Liftyee/multum-in-parvo/README.md

# multum-in-parvo
Low power, high performance mesh radio device
