Liftyee/multum-in-parvo/docs/project-proposal.md

# Project Proposal

## Target

I will design and test a high-performance, versatile mesh radio device. It will improve on two engineering fields compared to existing devices:

1. Radio-frequency (RF) and antenna design.
2. Low-power design.

These improvements will be field tested by community members to evaluate their real-world impact.

## Rationale

Everyday wireless devices like phones rely on base stations to communicate. These are single points of failure that can fail due to man-made or natural incidents (for example, a power cut), or be completely absent in remote locations.

In contrast, mesh networks such as Meshtastic are not reliant on any single device, because the mesh radio devices ("nodes") can communicate directly with each other. Distributing these devices to a community makes it more resilient, as it ensures coordination and communication can be maintained independently of major networks.

I already own many Meshtastic radio devices. They are inexpensive and functional, but there are two key problems:

1. The actual RF performance is often lacking, with poorly tuned antennas and suboptimal circuit design. This diminishes the range, efficiency, and therefore usefulness of the device.
2. Most nodes are power-hungry, with processors and high-power consumers such as GPS limiting battery life. Additionally, support for sustainable power sources (for example, solar and wind) is limited, hindering their off-grid potential.

I aim to improve on these two areas while maintaining an affordable price point compared with expensive professional nodes. The finished nodes will be sent to selected Meshtastic community members for testing.

## Timescale

1. **Design and ordering of first revision (electronics and casing):** 2 weeks.
2. **Standalone antenna and casing development:** 2 weeks, while waiting for designed parts to arrive.
3. **Testing, characterisation, and tuning of first revision:** 2 weeks.
4. **Improve design and order second revision:** 1 week.
5. **Repeat steps 2–3, distribute to the community, gather feedback, and write up:** 4 more weeks.

## Personal and Professional Development

In the short term, the skills I will gain in the RF and electronics engineering fields are in demand for internships and embedded engineering roles, which I aim to apply for.

In the medium to long term, RF is a field in which I am likely to specialise, from my current perspective. The real-world experience from this project will give me useful intuition about these concepts at an early stage, so I am well prepared to go further in my future career.

I think all the areas I plan to explore in this project are of high importance in our information-based society. These areas are also current weaknesses in my electronics skill set, so the experience from this project will help make me a more well-rounded engineer who can contribute to more projects in the future.

Finally, executing this project will improve my planning and decision-making skills, increasing my ability to bring projects to completion.
