Liftyee/multum-in-parvo/docs/references.md

# References

## Energy harvesting

- Chevrier, M., “The Secrets of Energy Harvesting: the Sloth and the Bear,” Texas Instruments, SSZTC44, September 2015. [Local PDF](./SSZTC44-sloth-and-bear.pdf) · [TI document page](https://www.ti.com/document-viewer/lit/html/ssztc44) · [TI PDF](https://www.ti.com/lit/ta/ssztc44/ssztc44.pdf)
