Liftyee/multum-in-parvo/hardware/reports/power-four-page.png

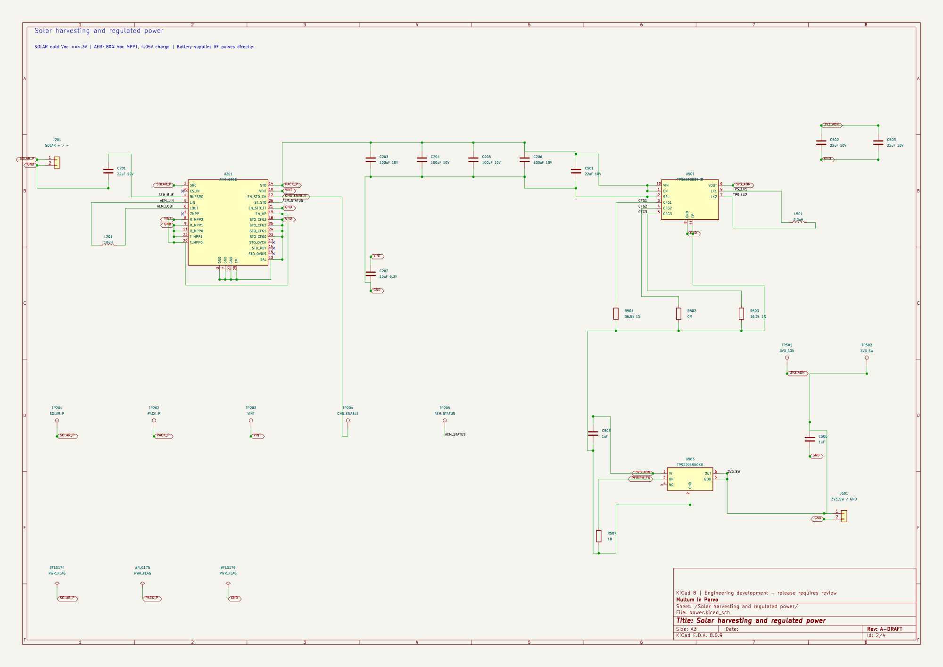
hardware/reports/power-four-page.png
