Liftyee/multum-in-parvo/hardware/reports/radio-four-page.png

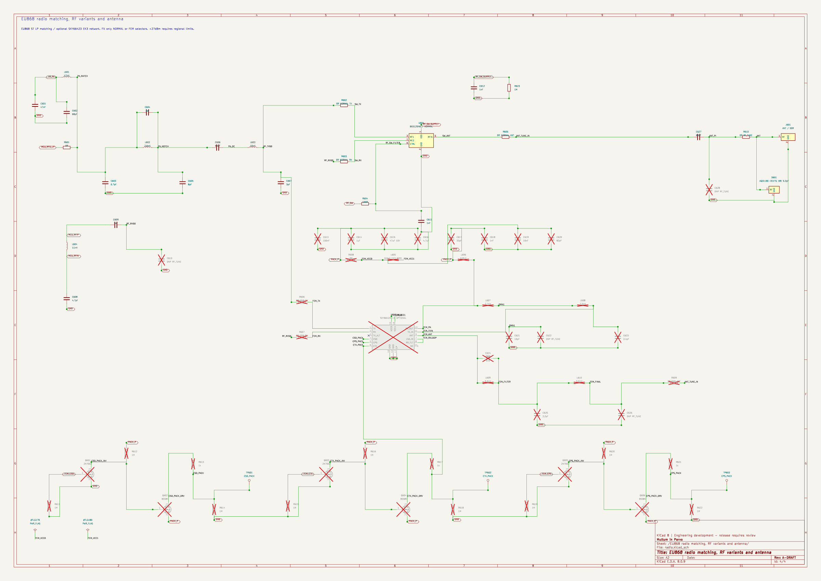
hardware/reports/radio-four-page.png
