Liftyee/multum-in-parvo/hardware/reports/rf-detail.png

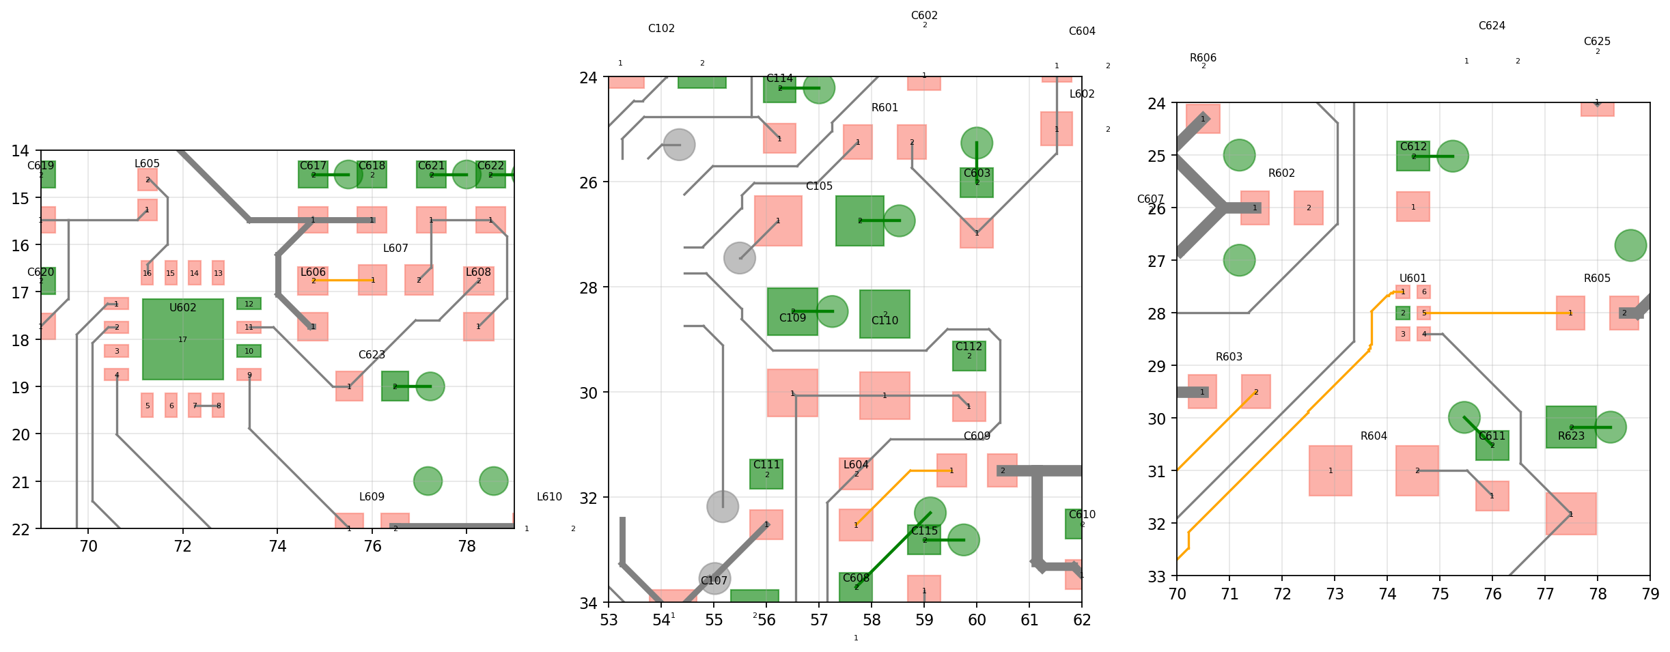
hardware/reports/rf-detail.png
