Liftyee/multum-in-parvo/hardware/reports/rf-placement.png

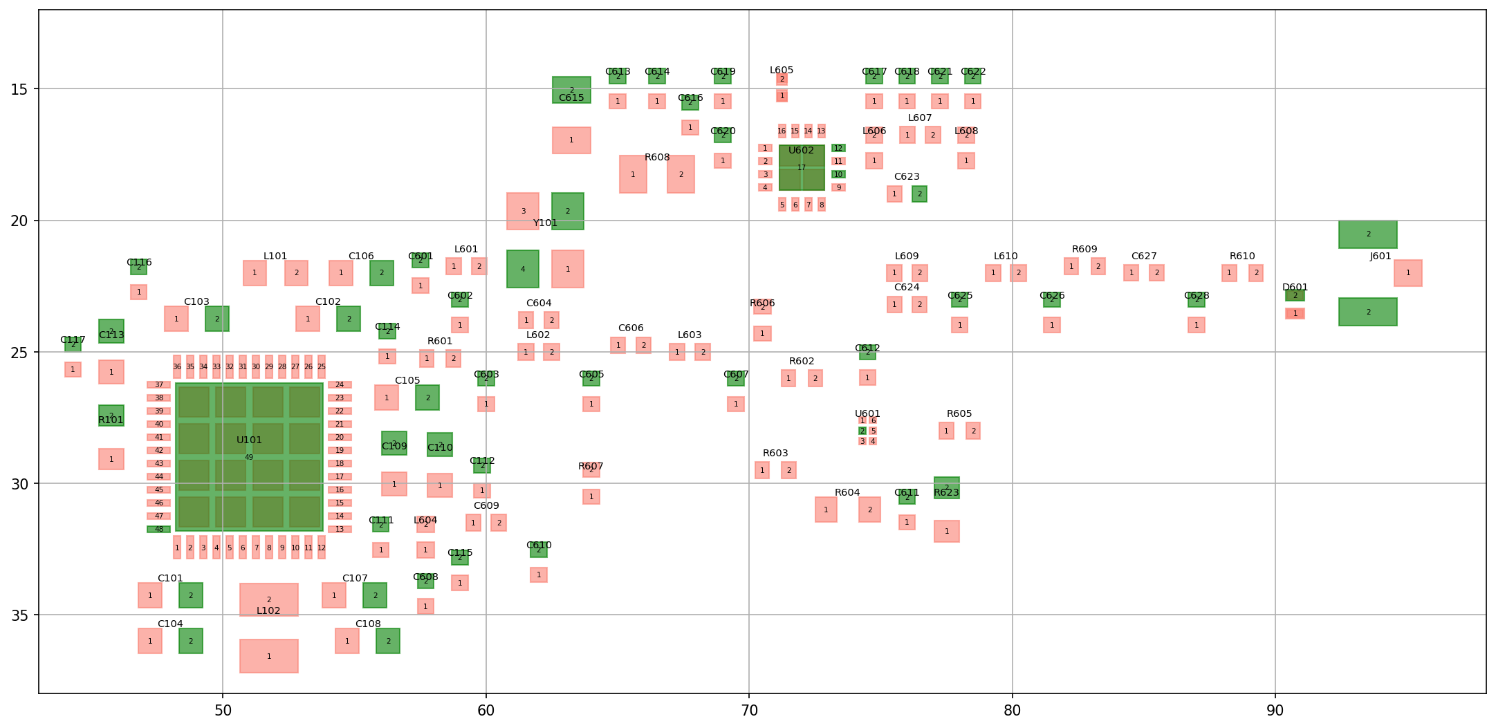
hardware/reports/rf-placement.png
