Liftyee/multum-in-parvo/hardware/reports/rf-routing-final.png

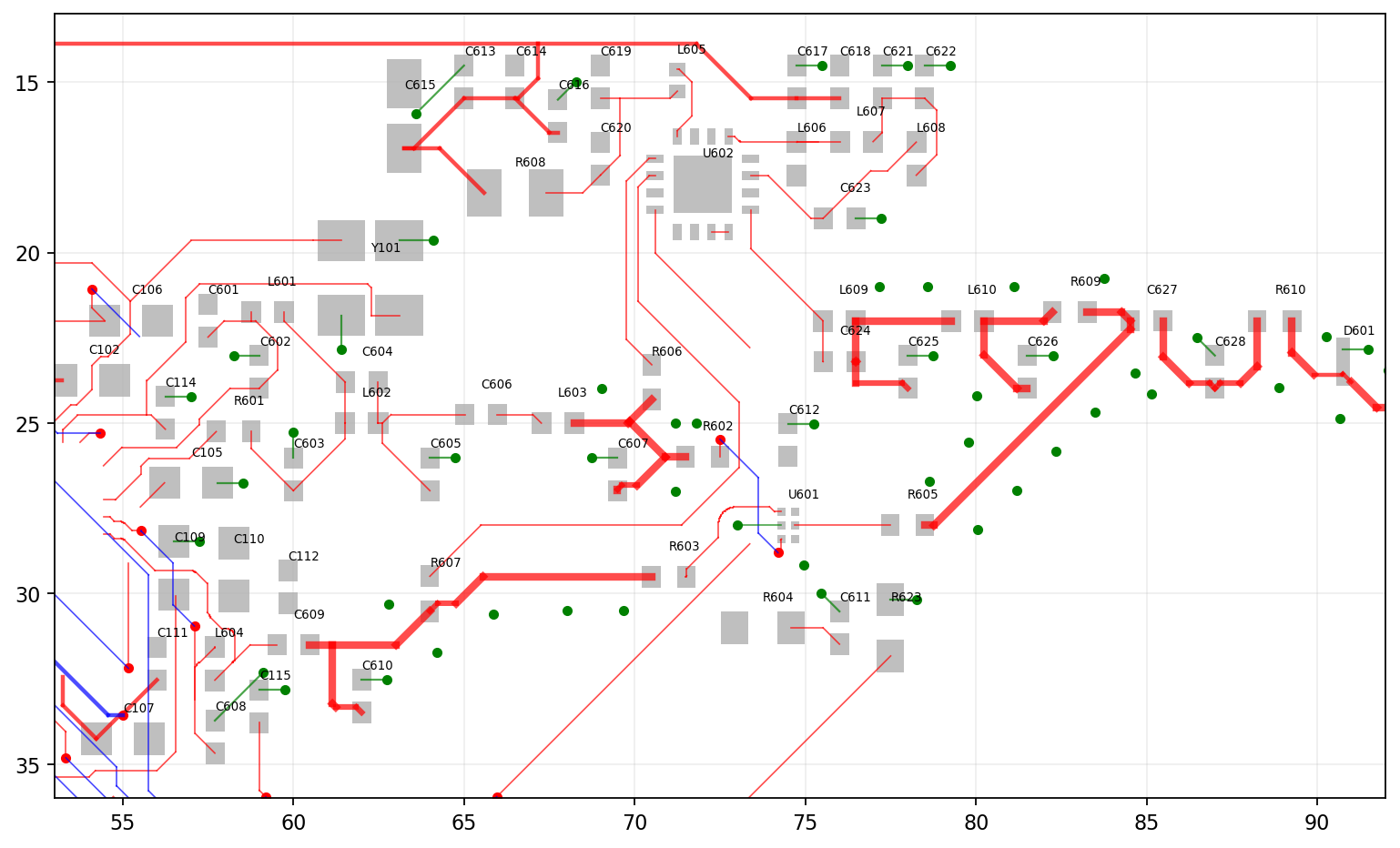
hardware/reports/rf-routing-final.png
