Liftyee/multum-in-parvo/hardware/reports/schematic-rf.png

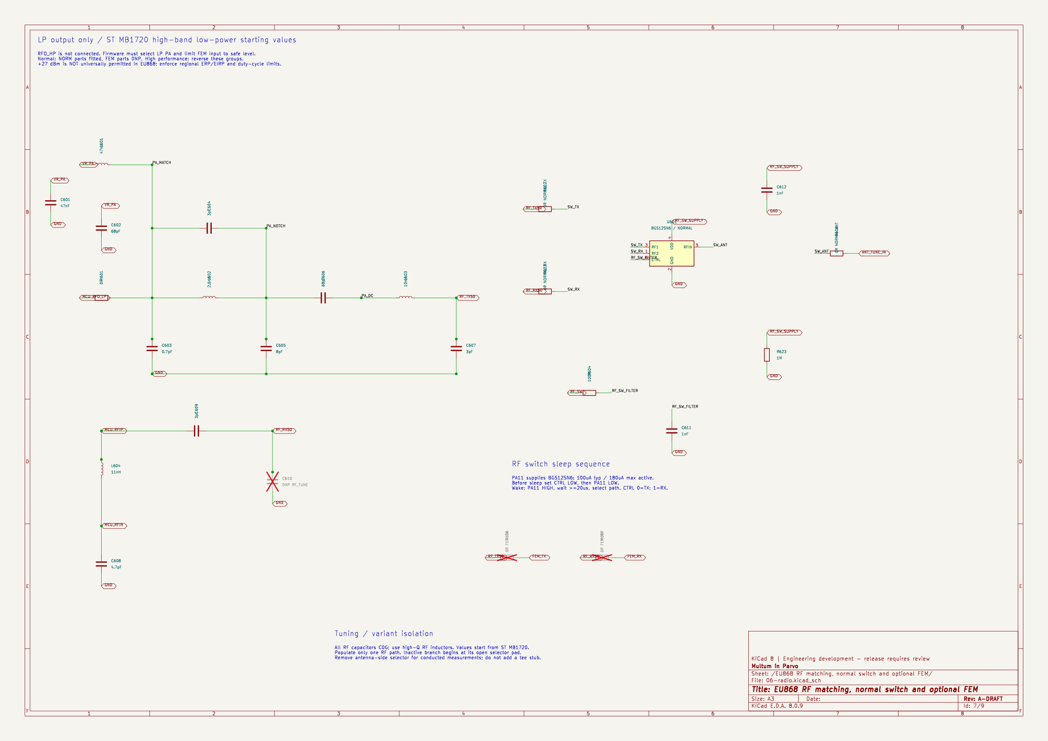
hardware/reports/schematic-rf.png
