Liftyee/multum-in-parvo/hardware/reports/schematic-solar.png

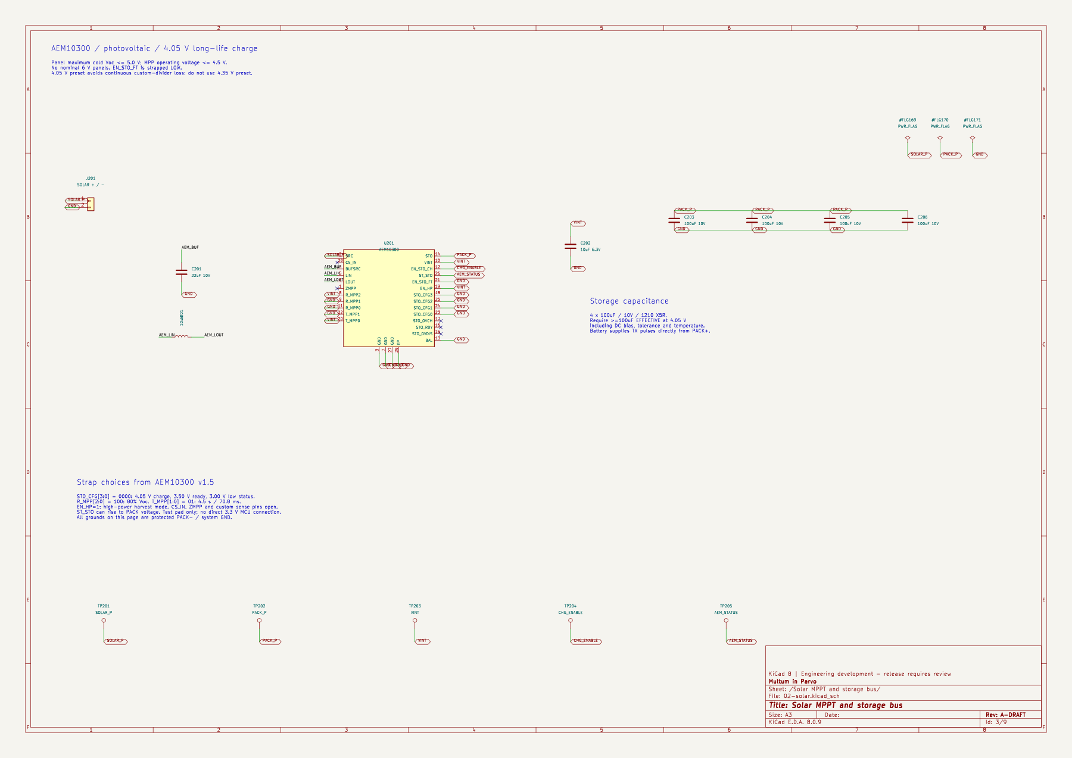
hardware/reports/schematic-solar.png
