Liftyee/multum-in-parvo/hardware/sources/aem-land.png

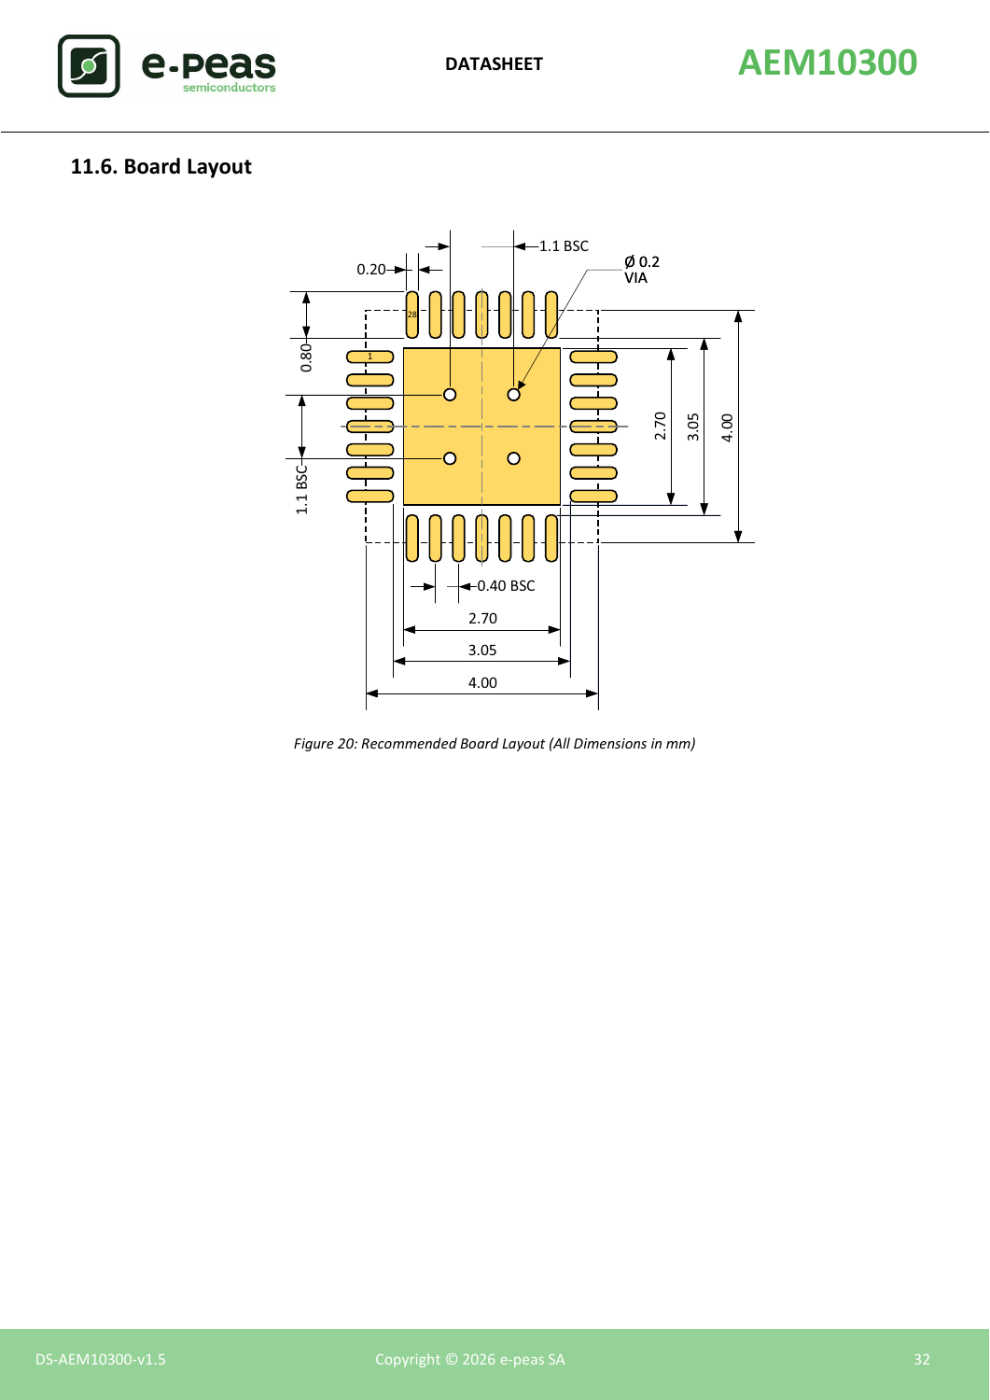
hardware/sources/aem-land.png
