Liftyee/multum-in-parvo/hardware/sources/fet-drawing.png

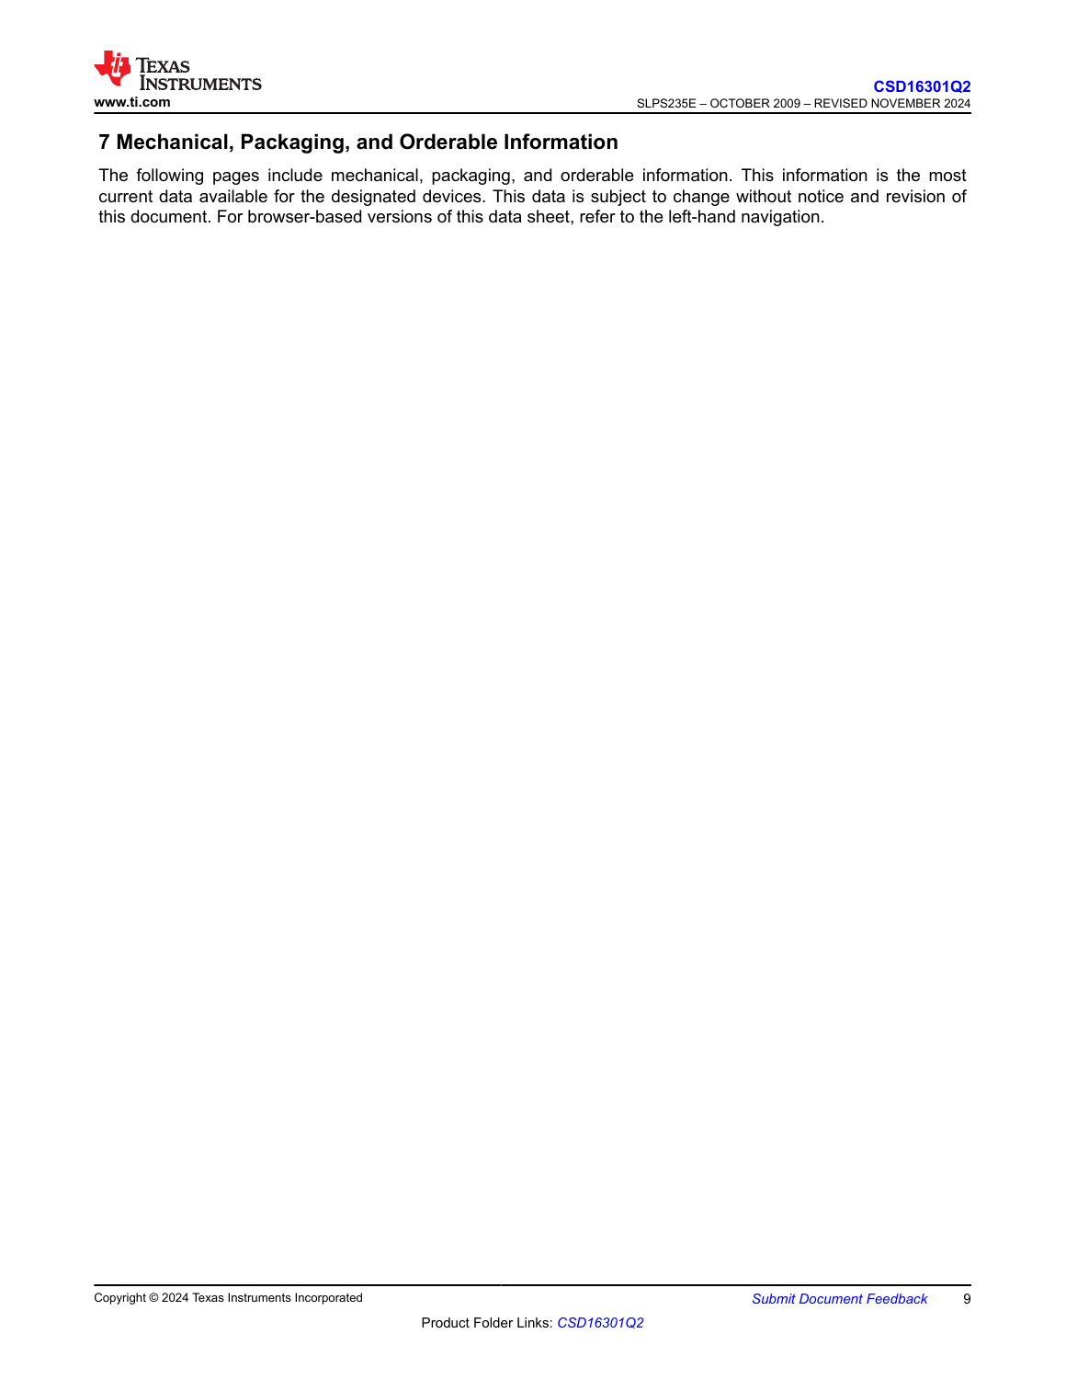
hardware/sources/fet-drawing.png
