Liftyee/multum-in-parvo/hardware/sources/fet-land.png

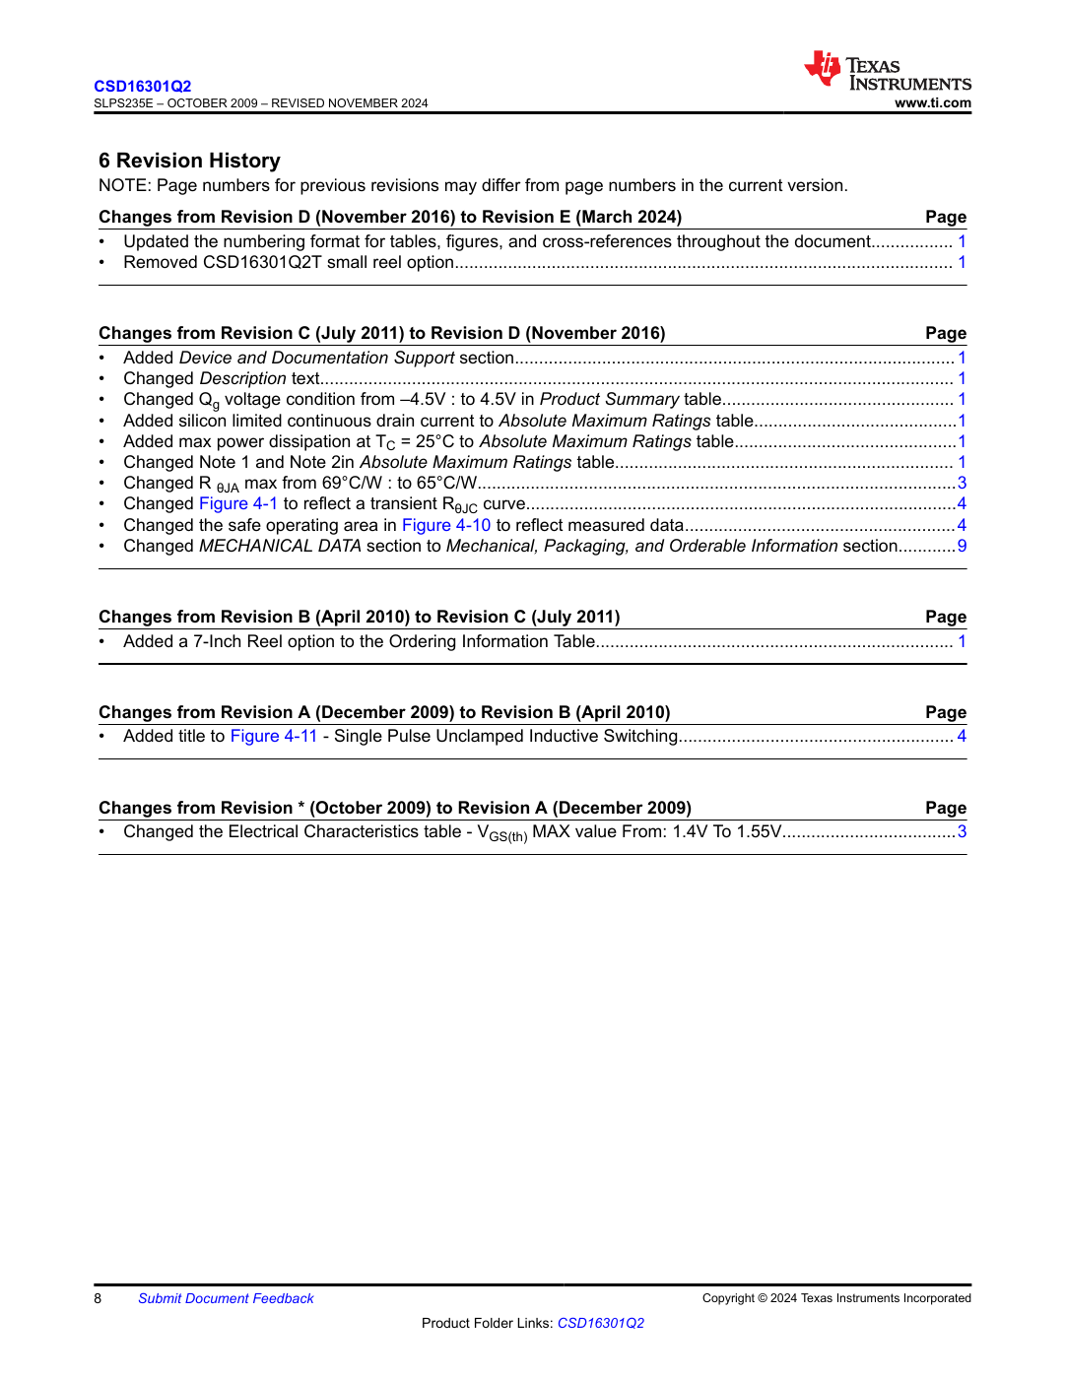
hardware/sources/fet-land.png
