Liftyee/multum-in-parvo/hardware/sources/sky-circuit.png

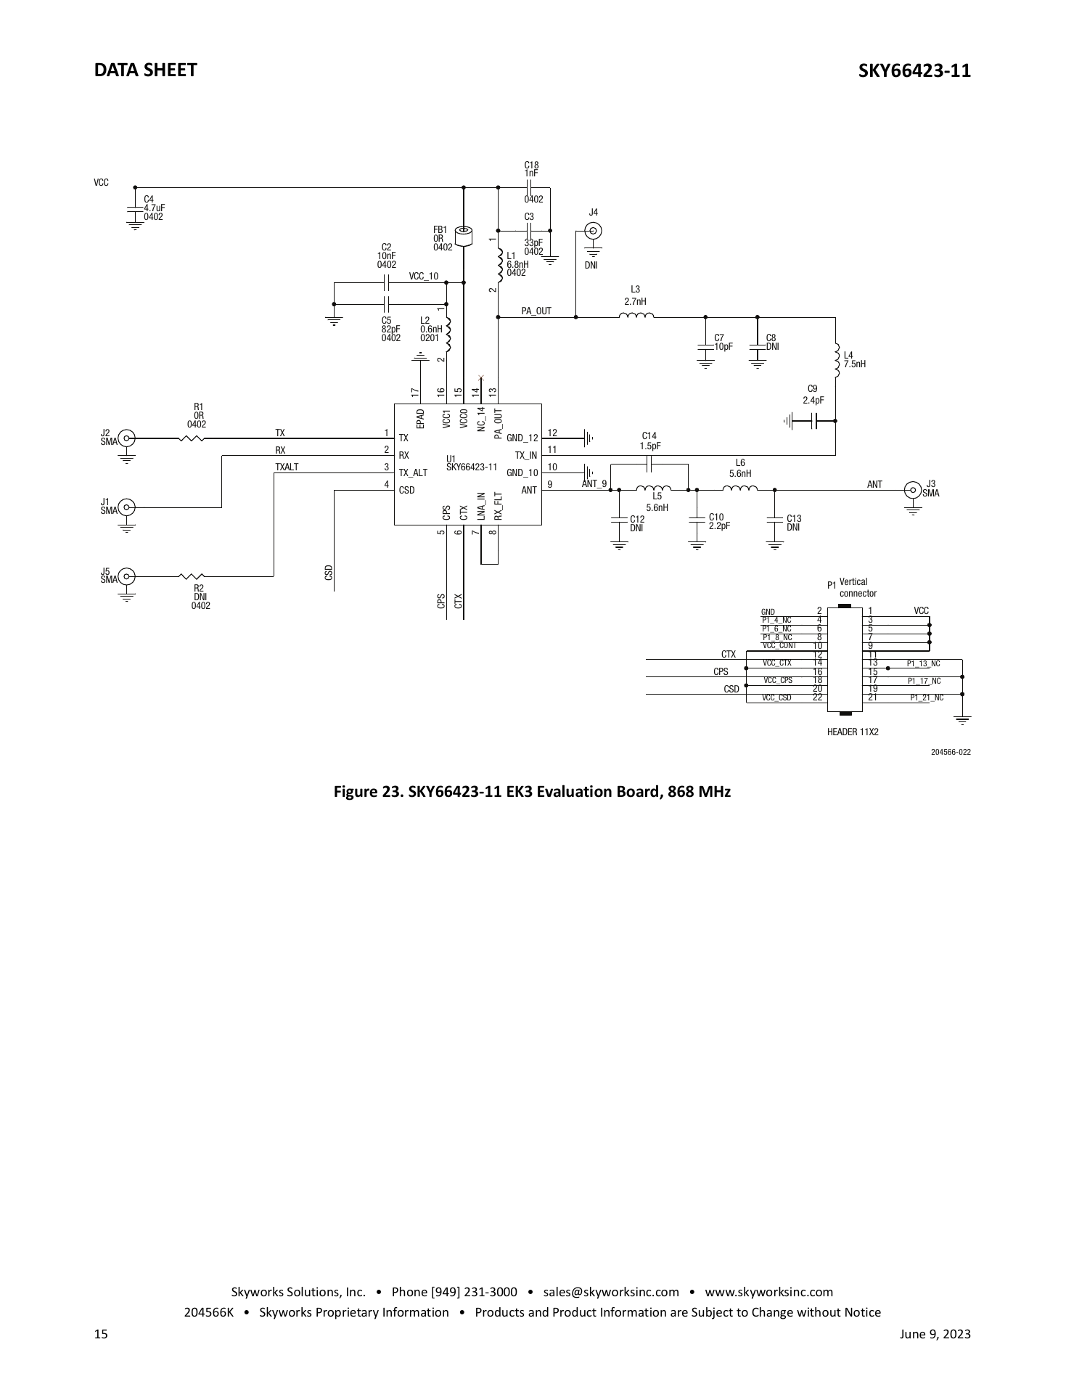
hardware/sources/sky-circuit.png
