Liftyee/multum-in-parvo/hardware/sources/sky-footprint.png

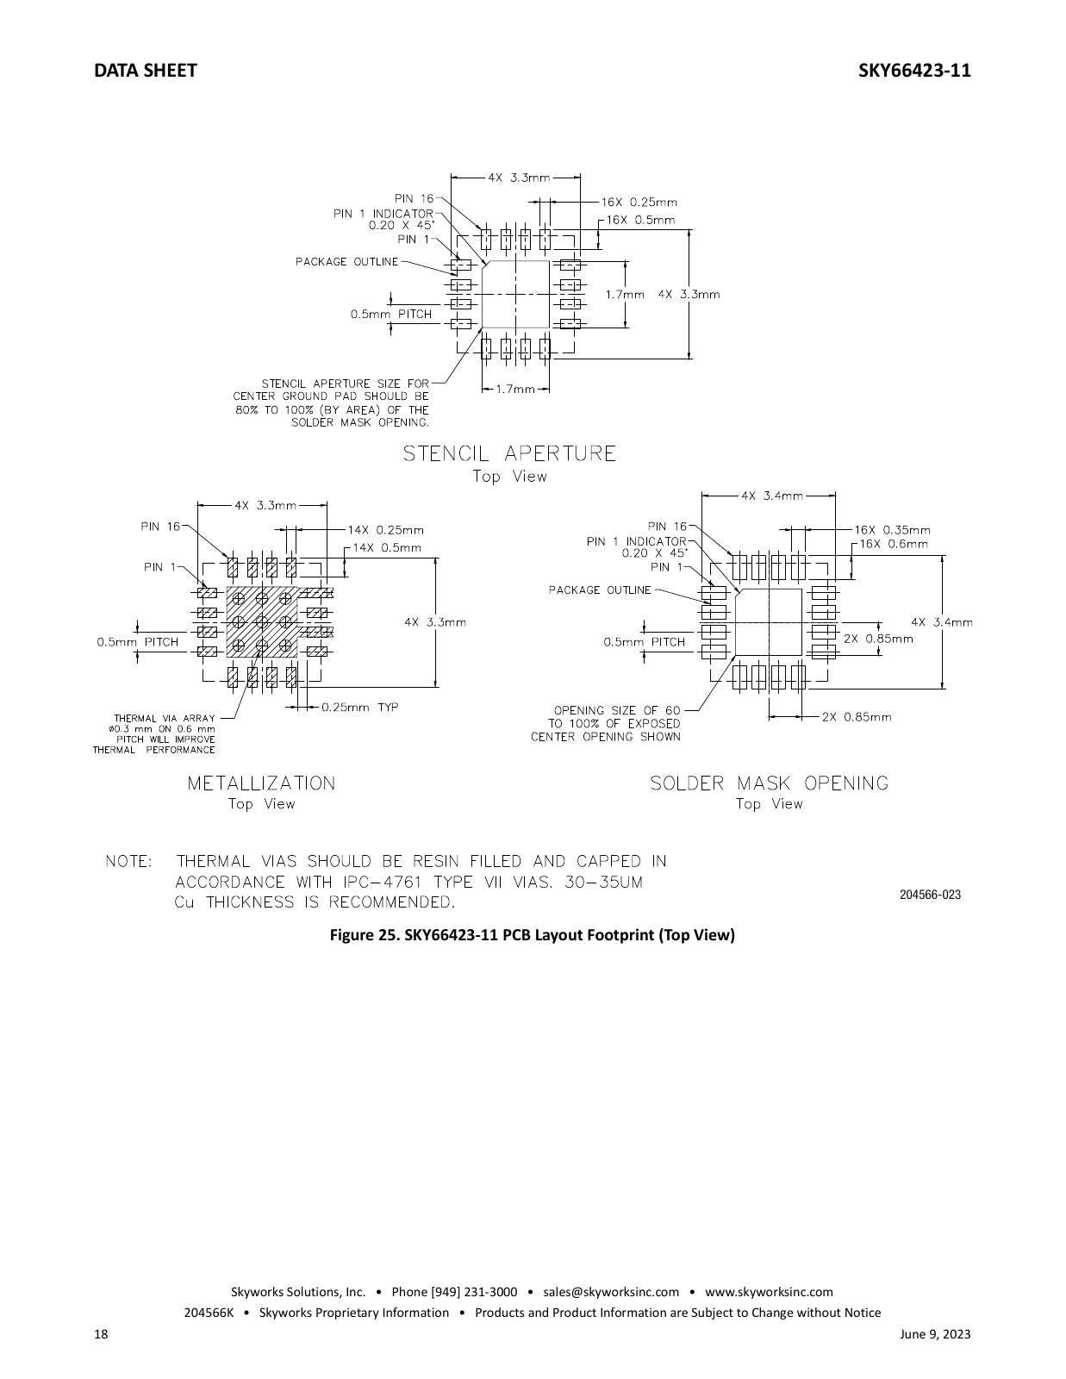
hardware/sources/sky-footprint.png
