Liftyee/multum-in-parvo/hardware/sources/sky-land.png

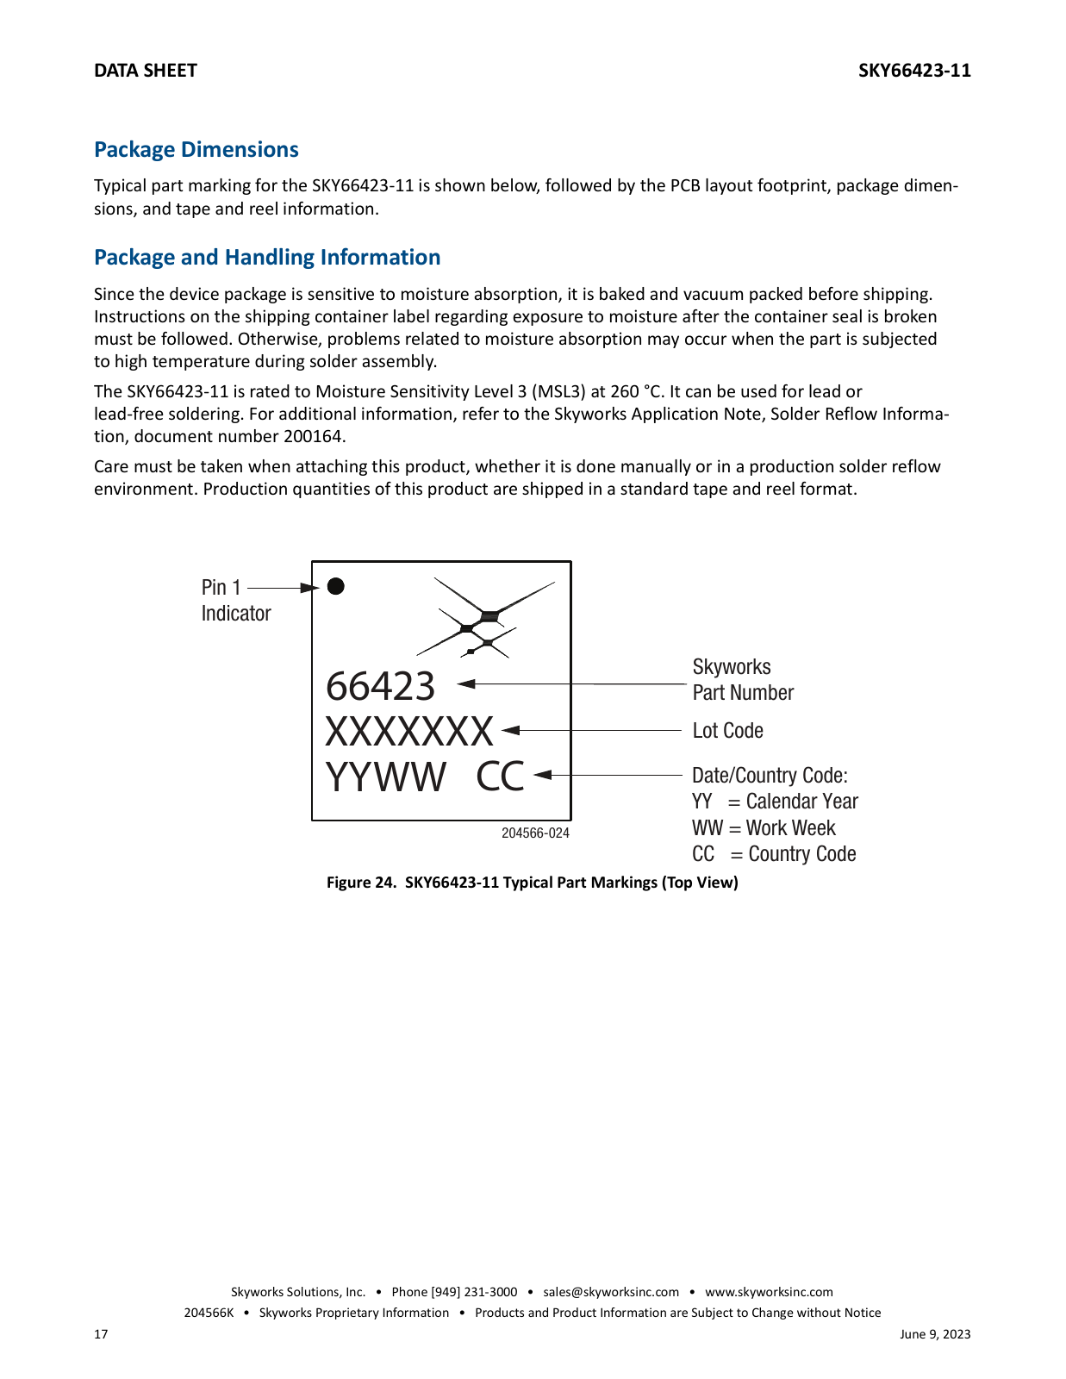
hardware/sources/sky-land.png
