Liftyee/multum-in-parvo/hardware/sources/sky-rf.png

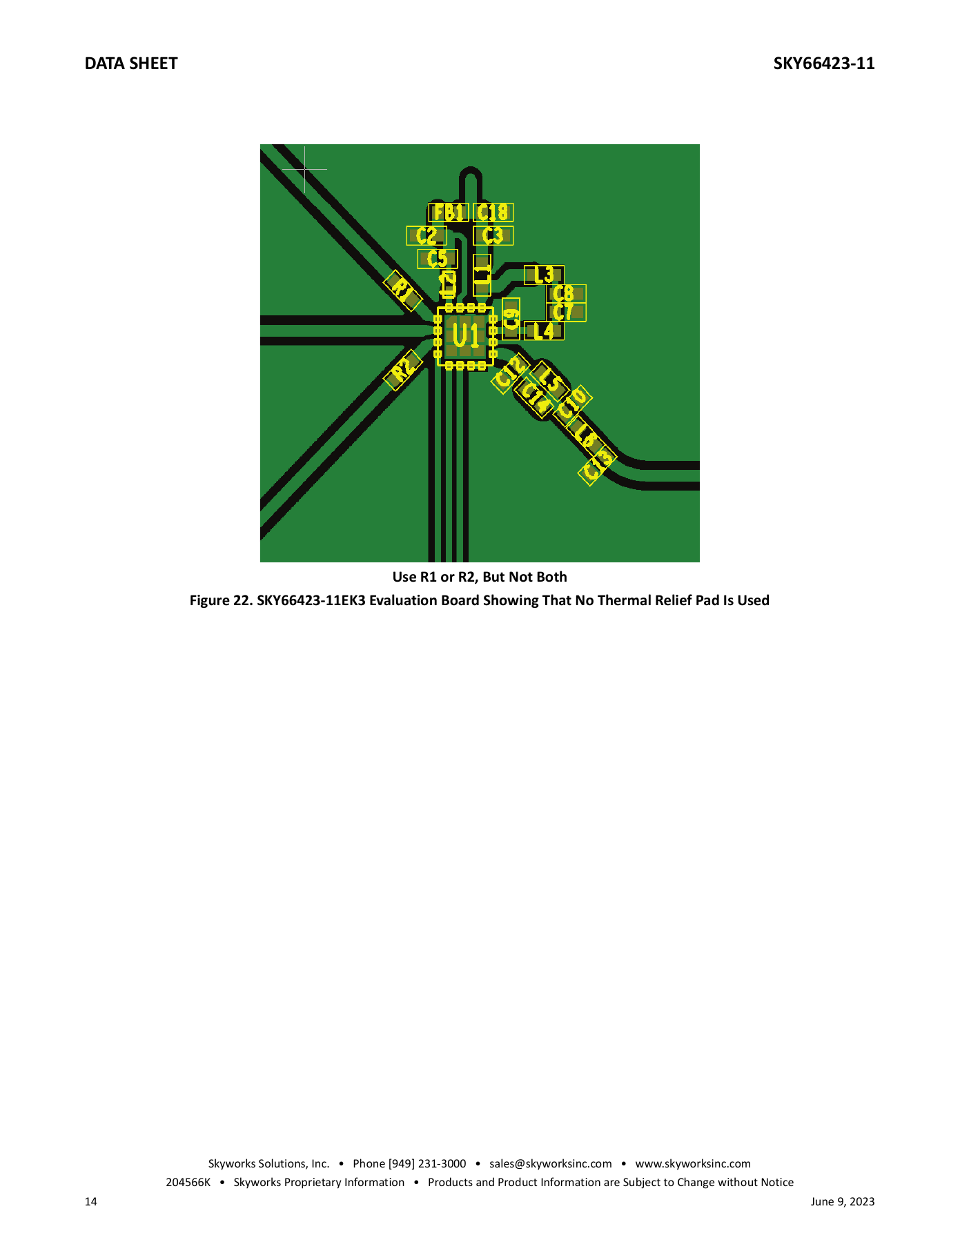
hardware/sources/sky-rf.png
