Liftyee/multum-in-parvo/hardware/sources/sky-schematic.png

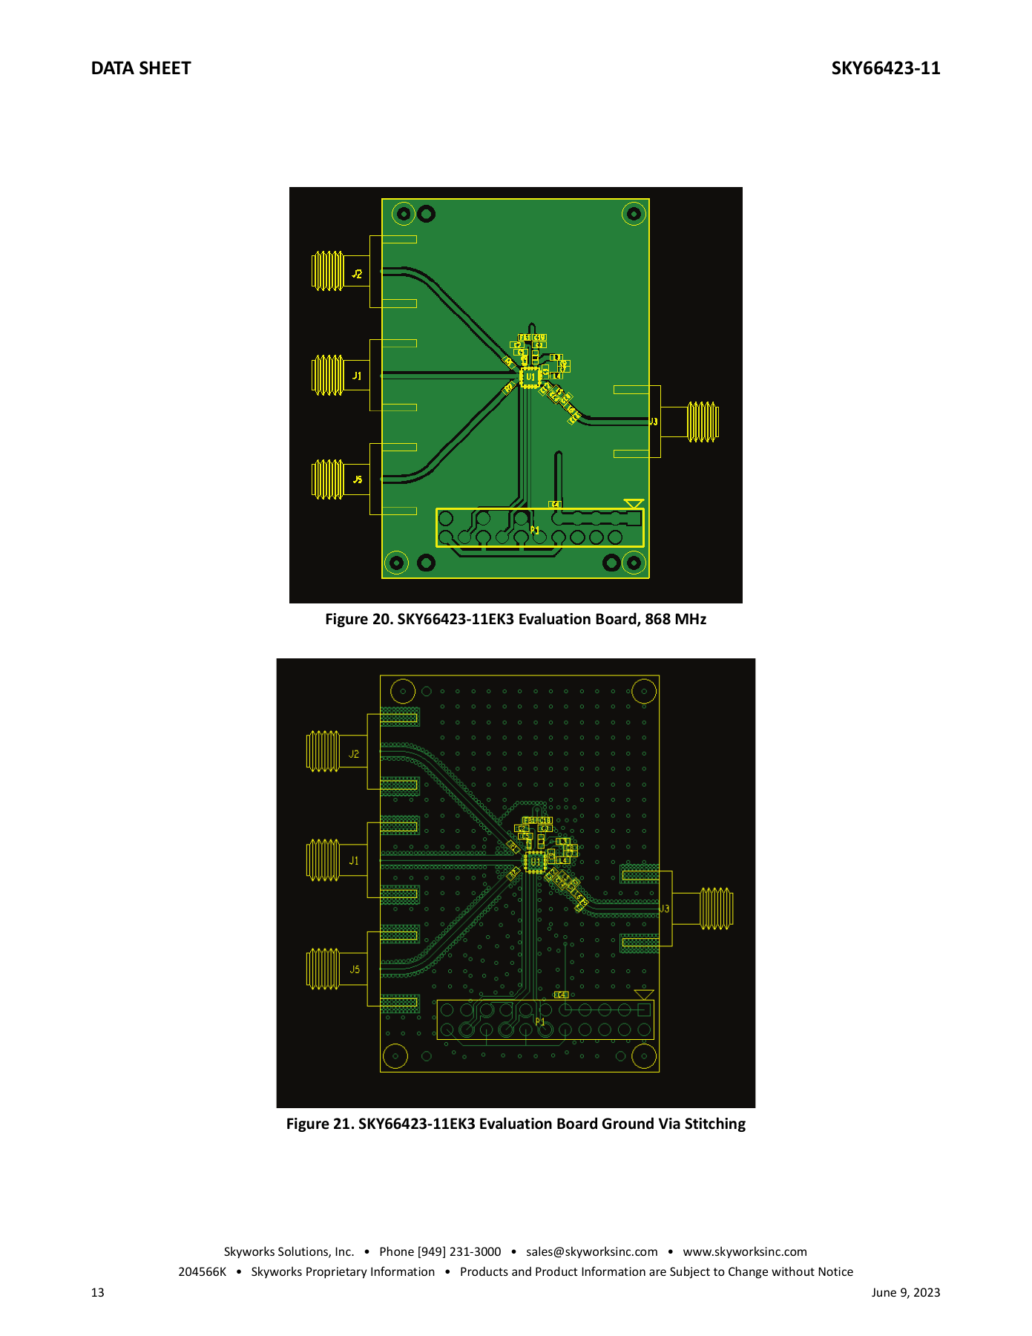
hardware/sources/sky-schematic.png
