Liftyee/multum-in-parvo/hardware/sources/st-circuit.png

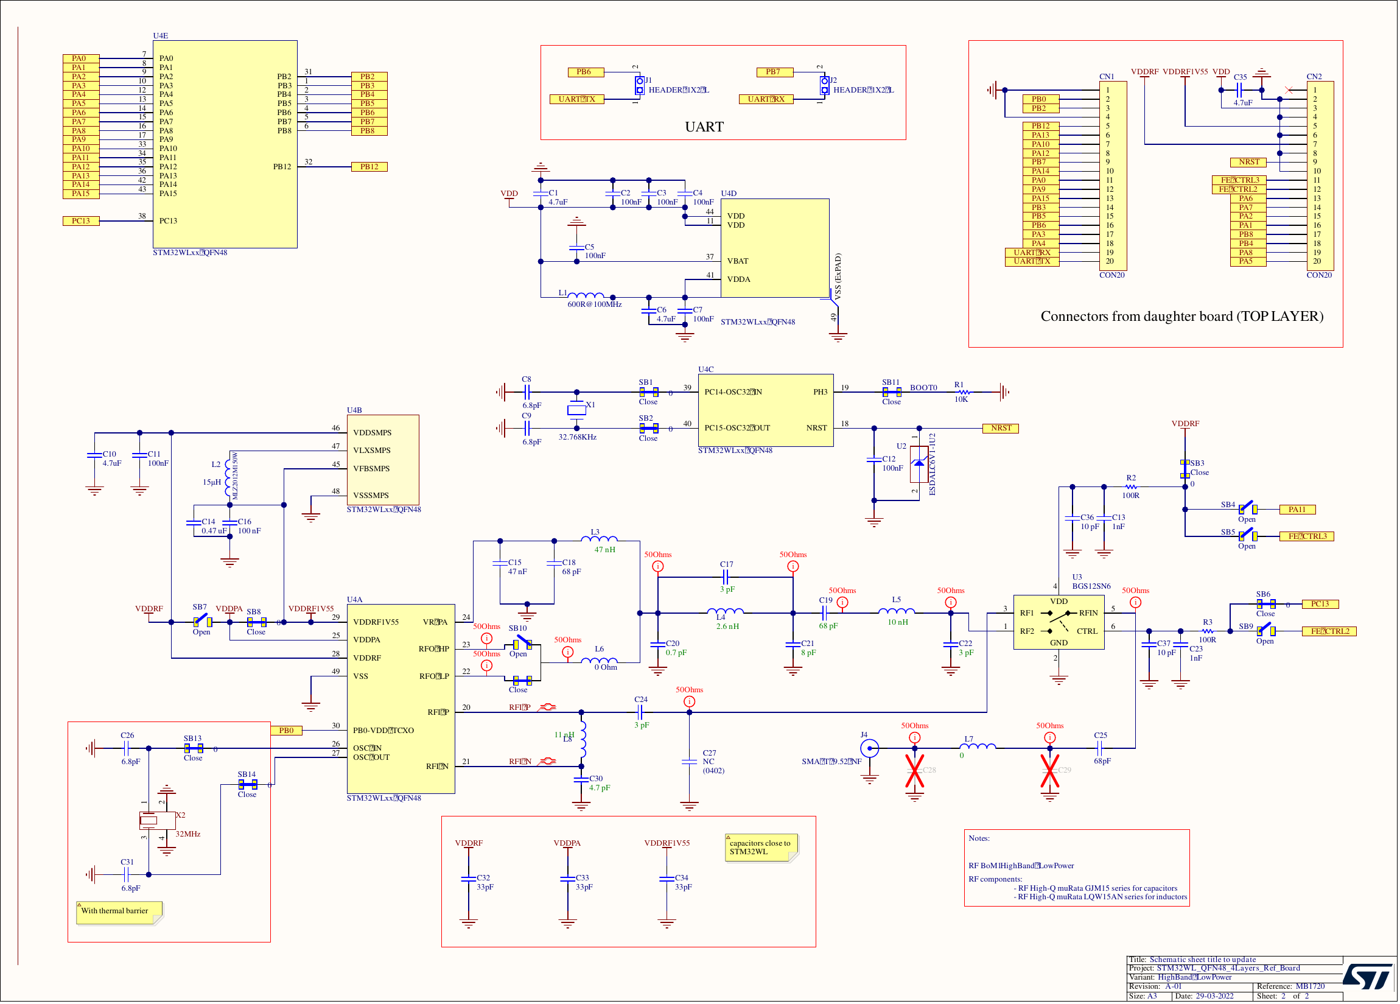
hardware/sources/st-circuit.png
