Liftyee/multum-in-parvo/(list of files, drawings)

Other design files:
hardware/reports/pcb-net-sync.json
hardware/reports/schematic-wiring.json
