Liftyee/multum-in-parvo/hardware/rak4630-carrier/rak4630-carrier.kicad_pcb

## KiCad design hardware/rak4630-carrier/rak4630-carrier.kicad_pcb (2026-10-19)

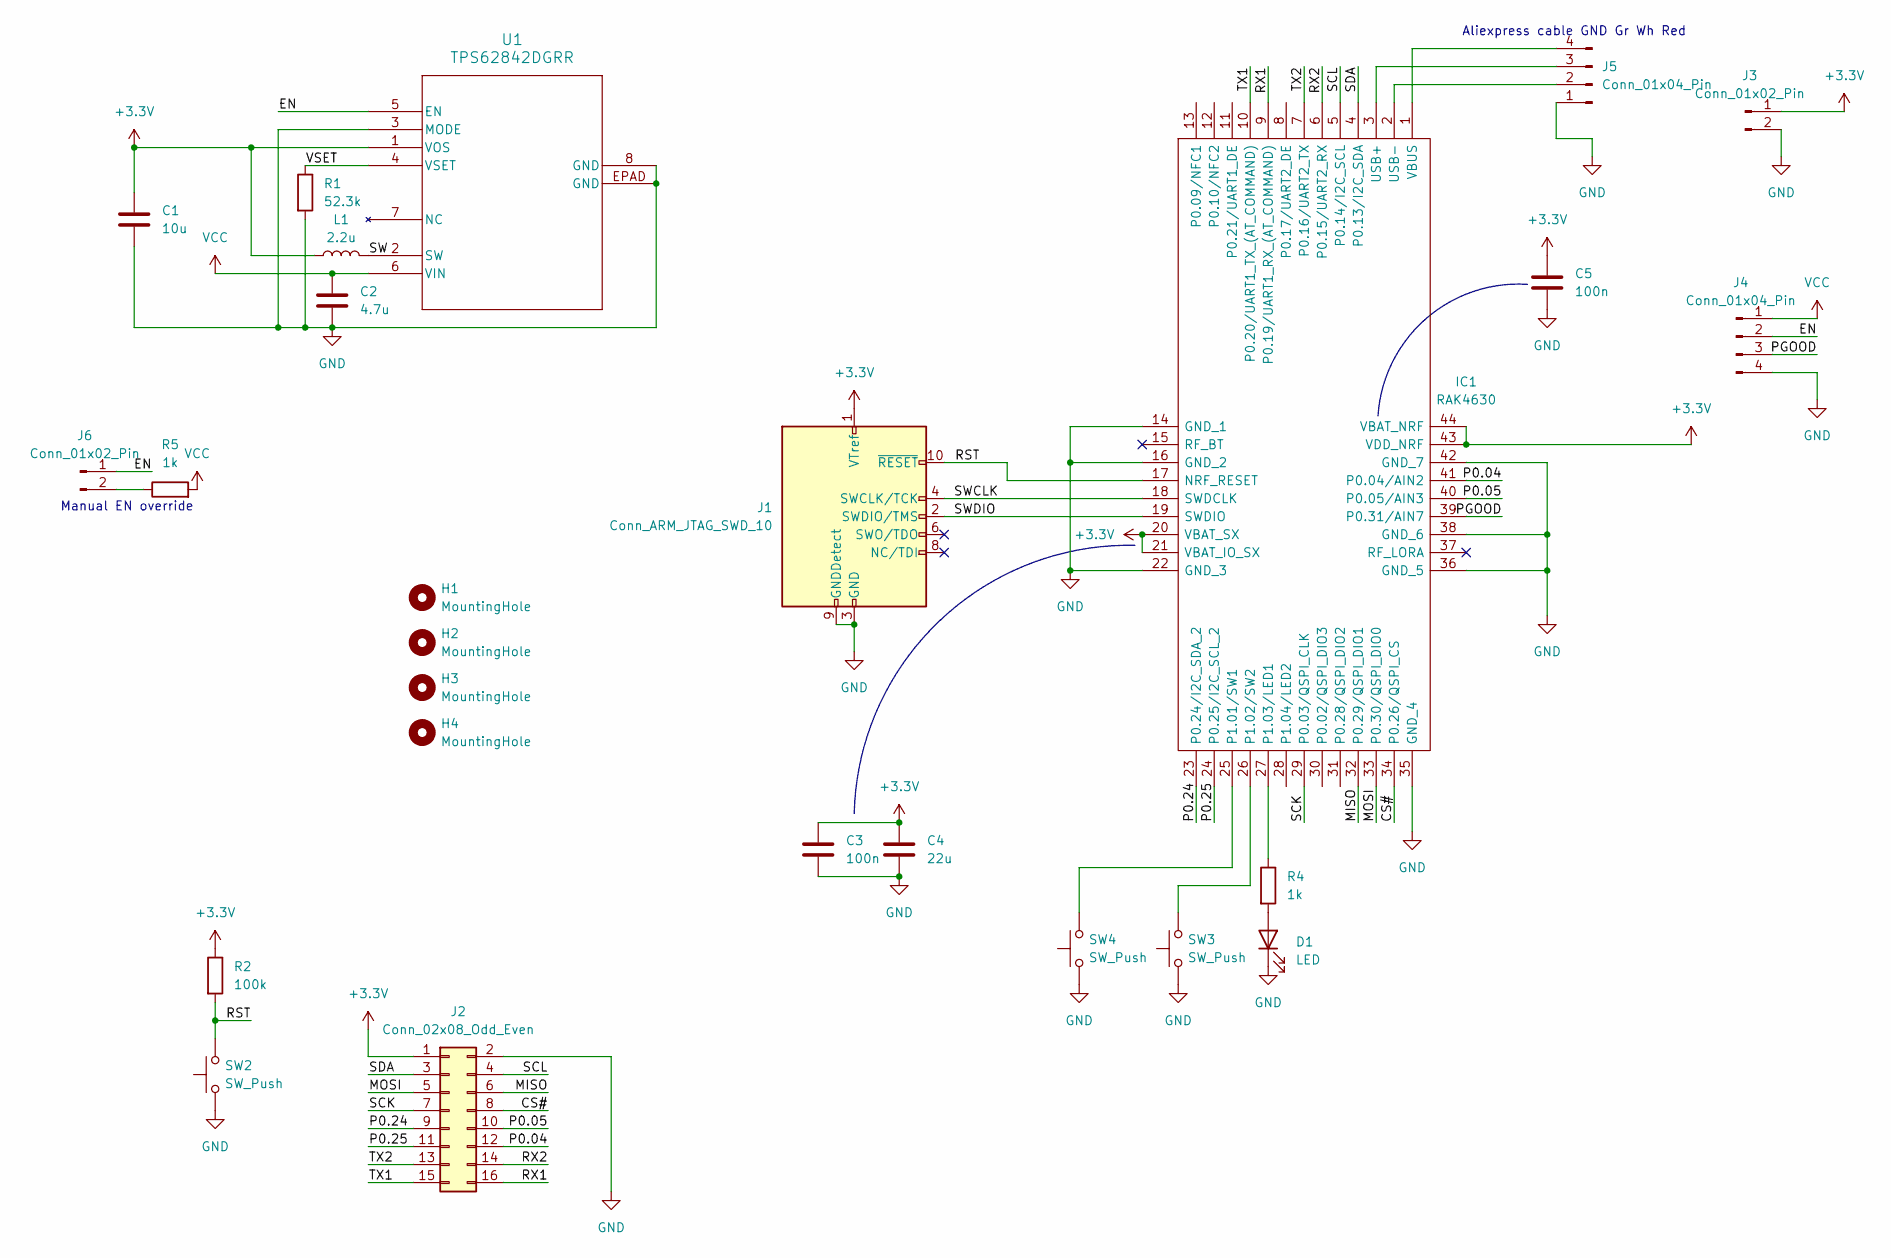
[picture p17: schematic rak4630-carrier.kicad_sch]

Parts:
C1: 10u; C_0805_2012Metric
C2: 4.7u; C_0805_2012Metric
C3, C5: 100n; C_0805_2012Metric
C4: 22u; C_0805_2012Metric
D1: LED; LED_0805_2012Metric
H1, H2, H3, H4: MountingHole; MountingHole_3.2mm_M3
IC1: RAK4630; Manufacturer_Part_Number RAK4630
J1: Conn_ARM_JTAG_SWD_10; PinHeader_2x05_P1.27mm_Vertical
J2: Conn_02x08_Odd_Even; PinHeader_2x08_P2.54mm_Vertical
J3: Conn_01x02_Pin; JST_XH_B2B-XH-A_1x02_P2.50mm_Vertical
J4: Conn_01x04_Pin; JST_XH_B4B-XH-A_1x04_P2.50mm_Vertical
J5: Conn_01x04_Pin; JST_PH_B4B-PH-K_1x04_P2.00mm_Vertical
J6: Conn_01x02_Pin; PinHeader_1x02_P2.54mm_Vertical
L1: 2.2u; L_Murata_DFE201610P
R1: 52.3k; R_0805_2012Metric
R2: 100k; R_0805_2012Metric
R4, R5: 1k; R_0805_2012Metric
SW2, SW3, SW4: SW_Push; Aliexpress_TLZWLA_SMD_Button_4mm
U1: TPS62842DGRR; HVSSOP8_DGR_TEX

Connections:
+3.3V: C1.1, C3.1, C4.1, C5.1, IC1.20 (VBAT_SX), IC1.21 (VBAT_IO_SX), IC1.43 (VDD_NRF), IC1.44 (VBAT_NRF), J1.1 (VTref), J2.1, J3.1, L1.1, R2.1, U1.1 (VOS)
/CS#: IC1.34 (P0.26/QSPI_CS), J2.8
/EN: J4.2, J6.1, U1.5 (EN)
/MISO: IC1.32 (P0.29/QSPI_DIO1), J2.6
/MOSI: IC1.33 (P0.30/QSPI_DIO0), J2.5
/P0.04: IC1.41 (P0.04/AIN2), J2.12
/P0.05: IC1.40 (P0.05/AIN3), J2.10
/P0.24: IC1.23 (P0.24/I2C_SDA_2), J2.9
/P0.25: IC1.24 (P0.25/I2C_SCL_2), J2.11
/PGOOD: IC1.39 (P0.31/AIN7), J4.3
/RST: IC1.17 (NRF_RESET), J1.10 (~RESET), R2.2, SW2.2
/RX1: IC1.9 (P0.19/UART1_RX_(AT_COMMAND)), J2.16
/RX2: IC1.6 (P0.15/UART2_RX), J2.14
/SCK: IC1.29 (P0.03/QSPI_CLK), J2.7
/SCL: IC1.5 (P0.14/I2C_SCL), J2.4
/SDA: IC1.4 (P0.13/I2C_SDA), J2.3
/SW: L1.2, U1.2 (SW)
/SWCLK: IC1.18 (SWDCLK), J1.4 (SWCLK/TCK)
/SWDIO: IC1.19 (SWDIO), J1.2 (SWDIO/TMS)
/TX1: IC1.10 (P0.20/UART1_TX_(AT_COMMAND)), J2.15
/TX2: IC1.7 (P0.16/UART2_TX), J2.13
/VSET: R1.1, U1.4 (VSET)
GND: C1.2, C2.2, C3.2, C4.2, C5.2, D1.1 (K), IC1.14 (GND_1), IC1.16 (GND_2), IC1.22 (GND_3), IC1.35 (GND_4), IC1.36 (GND_5), IC1.38 (GND_6), IC1.42 (GND_7), J1.3 (GND), J1.5 (GND), J1.9 (GNDDetect), J2.2, J3.2, J4.4, J5.1, R1.2, SW2.1, SW3.1, SW4.1, U1.3 (MODE), U1.8 (GND), U1.EPAD (GND)
unnamed: D1.2 (A), R4.2
unnamed: IC1.25 (P1.01/SW1), SW4.2
unnamed: IC1.26 (P1.02/SW2), SW3.2
unnamed: IC1.27 (P1.03/LED1), R4.1
unnamed: IC1.3 (USB+), J5.3
unnamed: IC1.2 (USB-), J5.2
unnamed: IC1.1 (VBUS), J5.4
unnamed: J6.2, R5.1
VCC: C2.1, J4.1, R5.2, U1.6 (VIN)

Notes on the sheet:
Manual EN override
Aliexpress cable GND Gr Wh Red

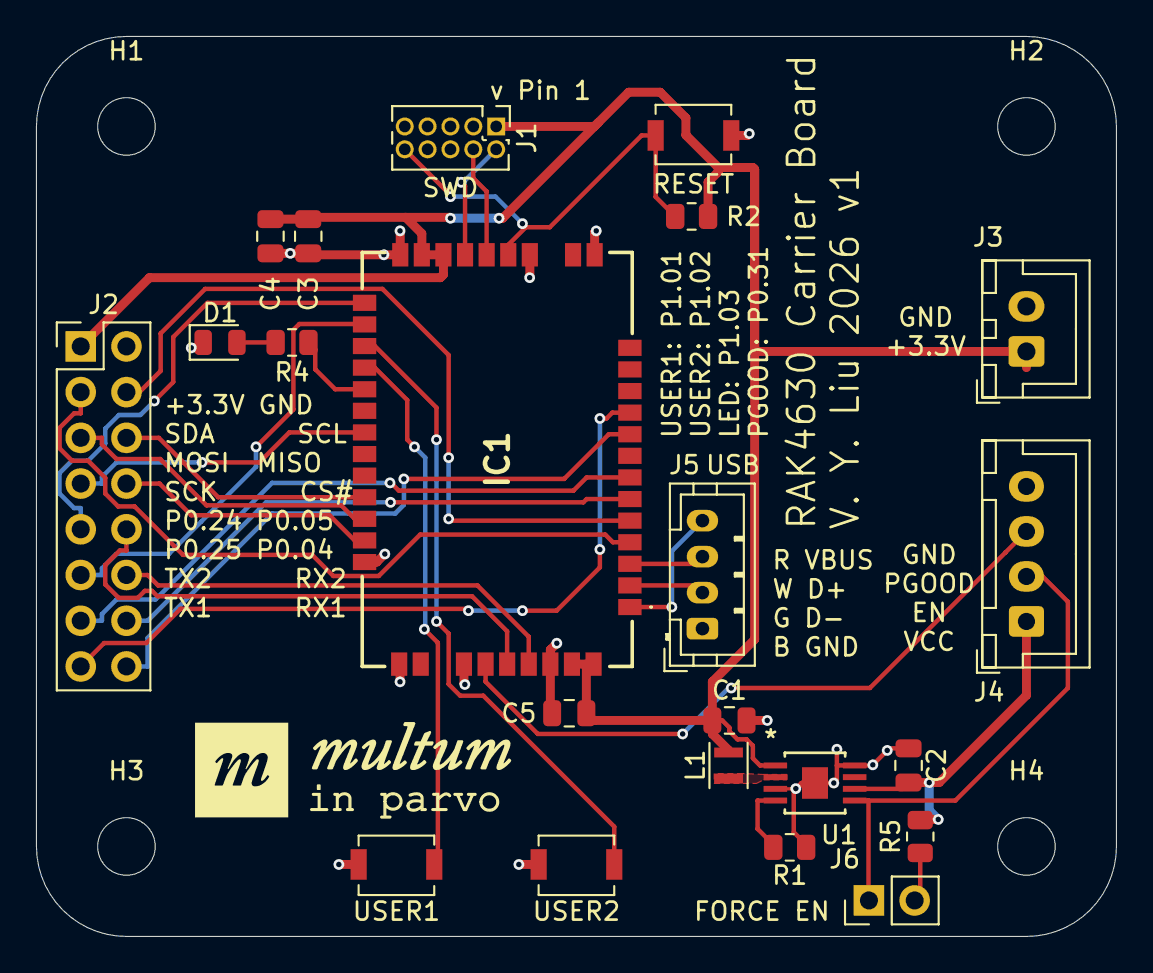
[picture p18: board rak4630-carrier.kicad_pcb from above]

Board: 2 copper layers, 60.0 x 50.0 mm, 26 parts (0 on the bottom side), 32 nets.
