Liftyee/multum-in-parvo/hardware/rak3172-carrier/rak3172-carrier.kicad_pcb

## KiCad design hardware/rak3172-carrier/rak3172-carrier.kicad_pcb (2026-10-19)

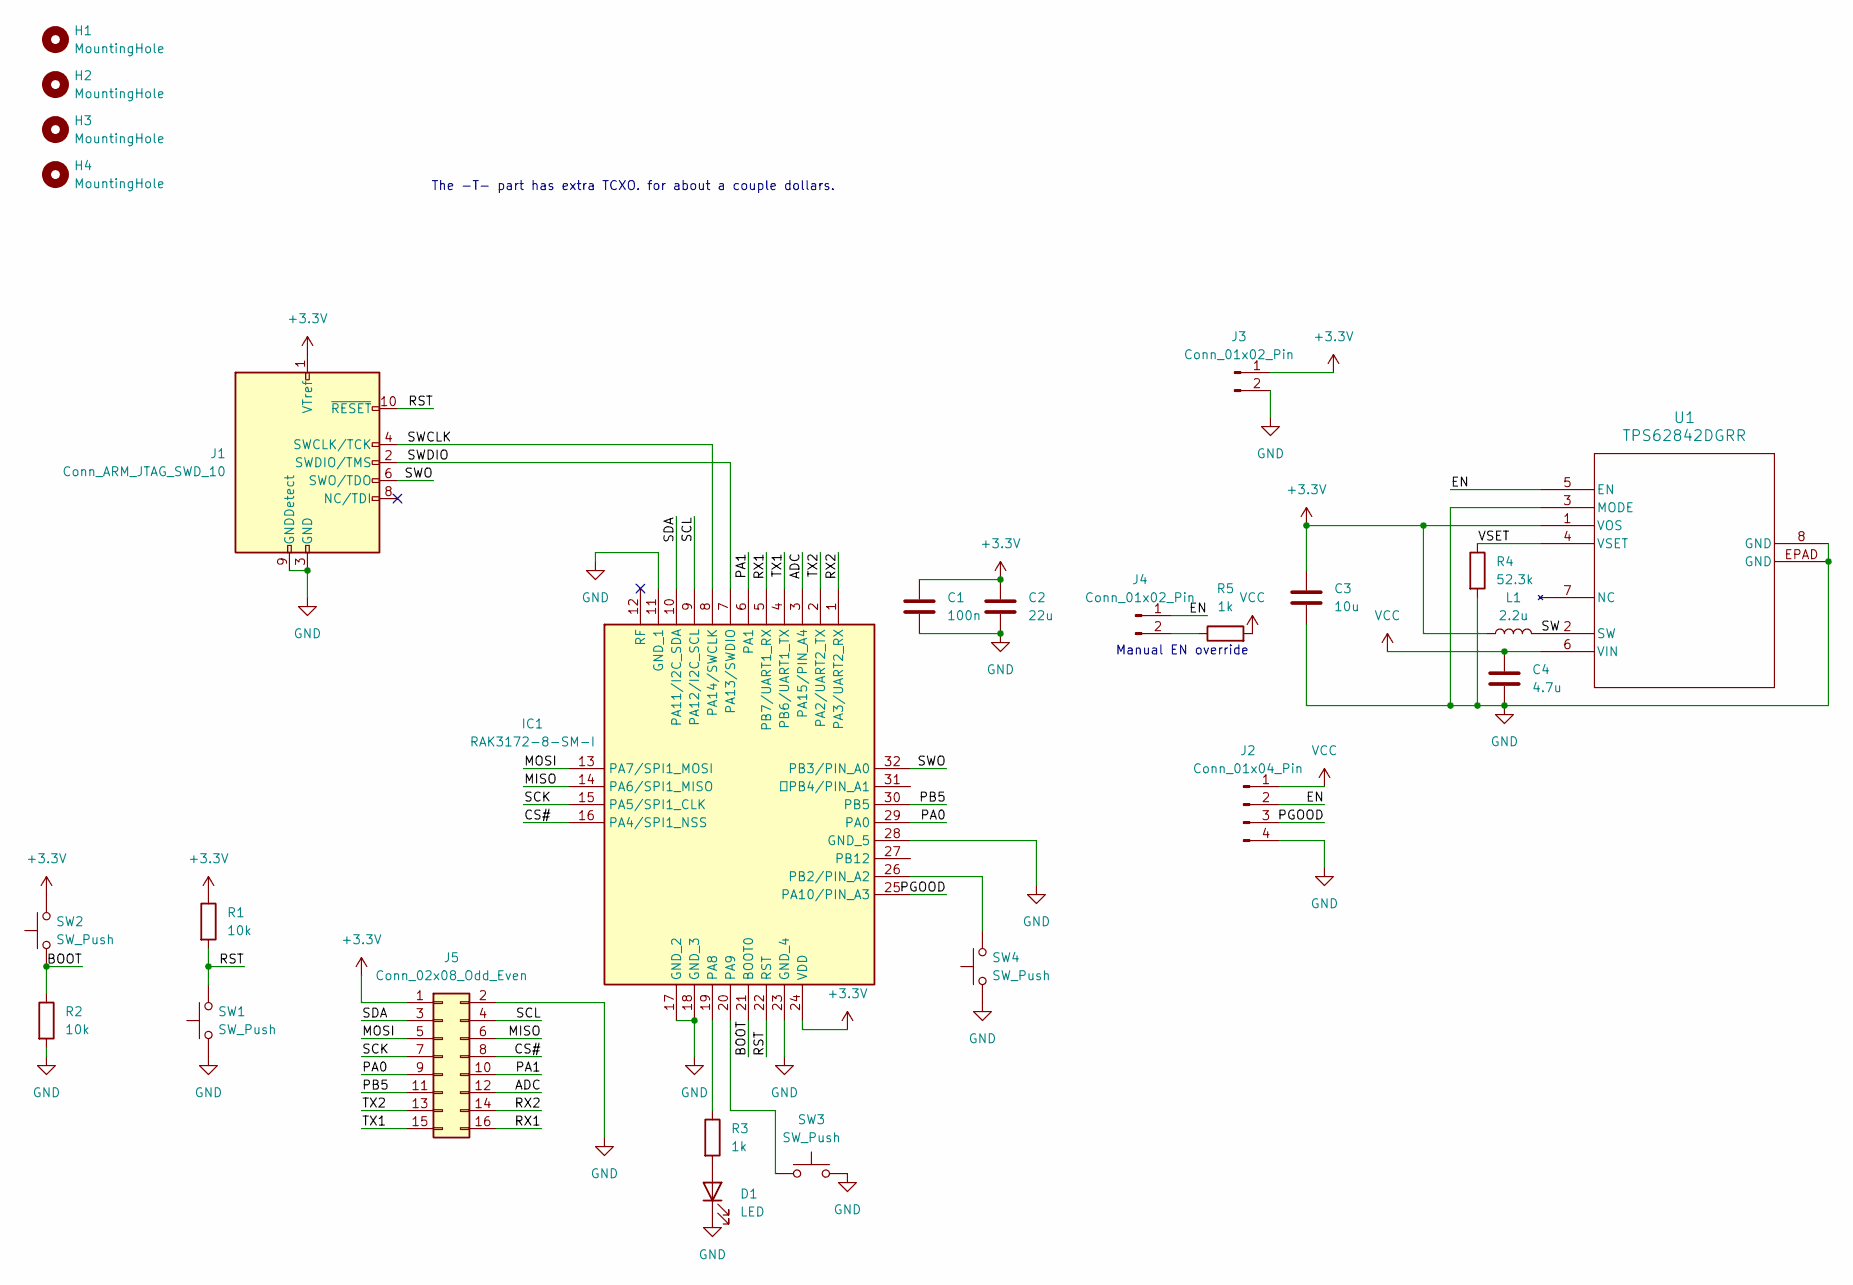
[picture p19: schematic rak3172-carrier.kicad_sch]

Parts:
C1: 100n; C_0805_2012Metric
C2: 22u; C_0805_2012Metric
C3: 10u; C_0805_2012Metric
C4: 4.7u; C_0805_2012Metric
D1: LED; LED_0805_2012Metric
H1, H2, H3, H4: MountingHole; MountingHole_3.2mm_M3
IC1: RAK3172-8-SM-I; RAK31729SMNI; Manufacturer_Part_Number RAK3172-9-SM-NI
J1: Conn_ARM_JTAG_SWD_10; PinHeader_2x05_P1.27mm_Vertical
J2: Conn_01x04_Pin; JST_XH_B4B-XH-A_1x04_P2.50mm_Vertical
J3: Conn_01x02_Pin; JST_XH_B2B-XH-A_1x02_P2.50mm_Vertical
J4: Conn_01x02_Pin; PinHeader_1x02_P2.54mm_Vertical
J5: Conn_02x08_Odd_Even; PinHeader_2x08_P2.54mm_Vertical
L1: 2.2u; L_Murata_DFE201610P
R1, R2: 10k; R_0805_2012Metric
R3, R5: 1k; R_0805_2012Metric
R4: 52.3k; R_0805_2012Metric
SW1, SW2, SW3, SW4: SW_Push; Aliexpress_TLZWLA_SMD_Button_4mm
U1: TPS62842DGRR; HVSSOP8_DGR_TEX

Connections:
+3.3V: C1.1, C2.1, C3.1, IC1.24 (VDD), J1.1 (VTref), J3.1, J5.1, L1.1, R1.1, SW2.2, U1.1 (VOS)
/ADC: IC1.3 (PA15/PIN_A4), J5.12
/BOOT: IC1.21 (BOOT0), R2.1, SW2.1
/CS#: IC1.16 (PA4/SPI1_NSS), J5.8
/EN: J2.2, J4.1, U1.5 (EN)
/MISO: IC1.14 (PA6/SPI1_MISO), J5.6
/MOSI: IC1.13 (PA7/SPI1_MOSI), J5.5
/PA0: IC1.29 (PA0), J5.9
/PA1: IC1.6 (PA1), J5.10
/PB5: IC1.30 (PB5), J5.11
/PGOOD: IC1.25 (PA10/PIN_A3), J2.3
/RST: IC1.22 (RST), J1.10 (~RESET), R1.2, SW1.2
/RX1: IC1.5 (PB7/UART1_RX), J5.16
/RX2: IC1.1 (PA3/UART2_RX), J5.14
/SCK: IC1.15 (PA5/SPI1_CLK), J5.7
/SCL: IC1.9 (PA12/I2C_SCL), J5.4
/SDA: IC1.10 (PA11/I2C_SDA), J5.3
/SW: L1.2, U1.2 (SW)
/SWCLK: IC1.8 (PA14/SWCLK), J1.4 (SWCLK/TCK)
/SWDIO: IC1.7 (PA13/SWDIO), J1.2 (SWDIO/TMS)
/SWO: IC1.32 (PB3/PIN_A0), J1.6 (SWO/TDO)
/TX1: IC1.4 (PB6/UART1_TX), J5.15
/TX2: IC1.2 (PA2/UART2_TX), J5.13
/VSET: R4.1, U1.4 (VSET)
GND: C1.2, C2.2, C3.2, C4.2, D1.1 (K), IC1.11 (GND_1), IC1.17 (GND_2), IC1.18 (GND_3), IC1.23 (GND_4), IC1.28 (GND_5), J1.3 (GND), J1.5 (GND), J1.9 (GNDDetect), J2.4, J3.2, J5.2, R2.2, R4.2, SW1.1, SW3.2, SW4.1, U1.3 (MODE), U1.8 (GND), U1.EPAD (GND)
unnamed: D1.2 (A), R3.2
unnamed: IC1.19 (PA8), R3.1
unnamed: IC1.20 (PA9), SW3.1
unnamed: IC1.26 (PB2/PIN_A2), SW4.2
unnamed: J4.2, R5.1
VCC: C4.1, J2.1, R5.2, U1.6 (VIN)

Notes on the sheet:
The -T- part has extra TCXO. for about a couple dollars.
Manual EN override

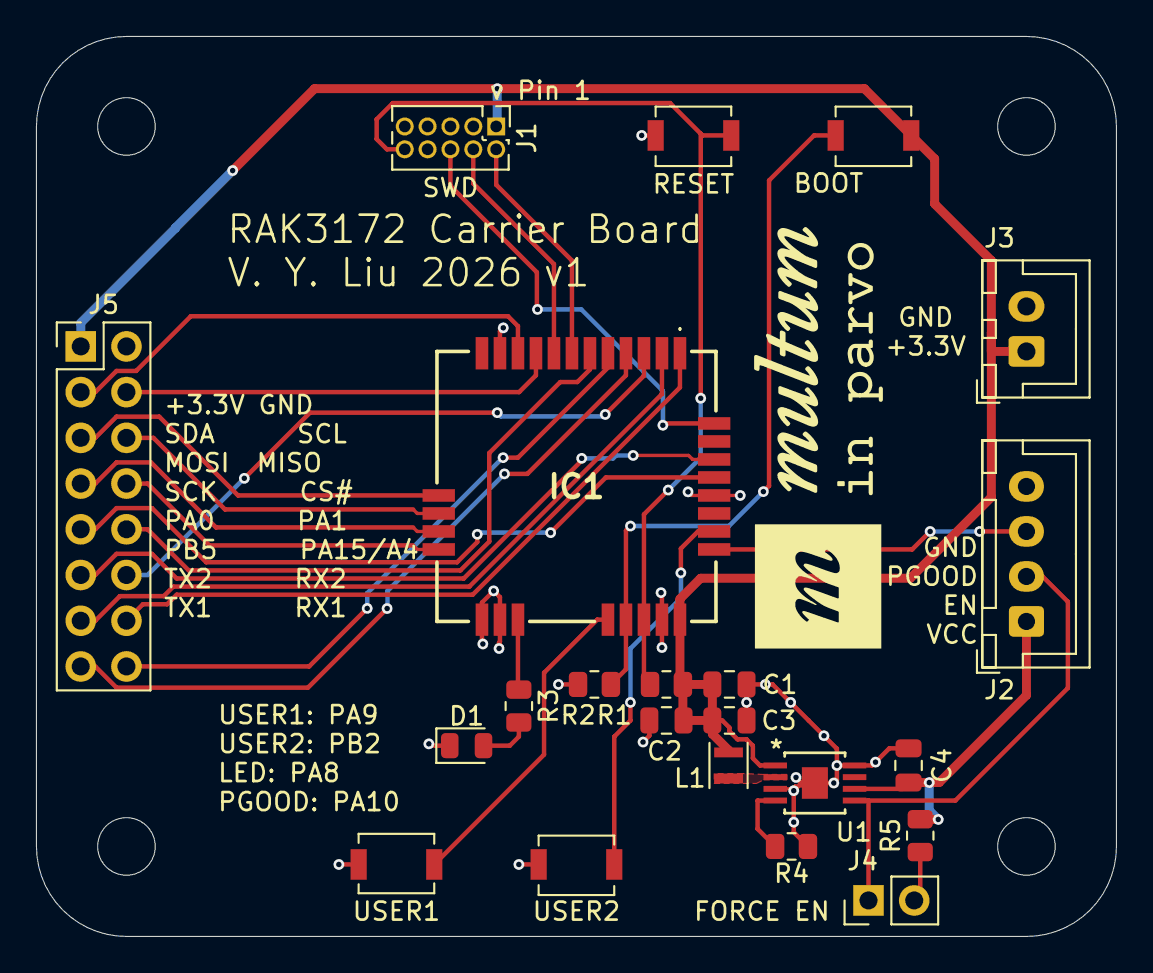
[picture p20: board rak3172-carrier.kicad_pcb from above]

Board: 2 copper layers, 60.0 x 50.0 mm, 26 parts (0 on the bottom side), 31 nets.
