Liftyee/multum-in-parvo/hardware/mesh-node/mesh-node.kicad_pcb

## KiCad design hardware/mesh-node/mesh-node.kicad_pcb (2026-10-19)

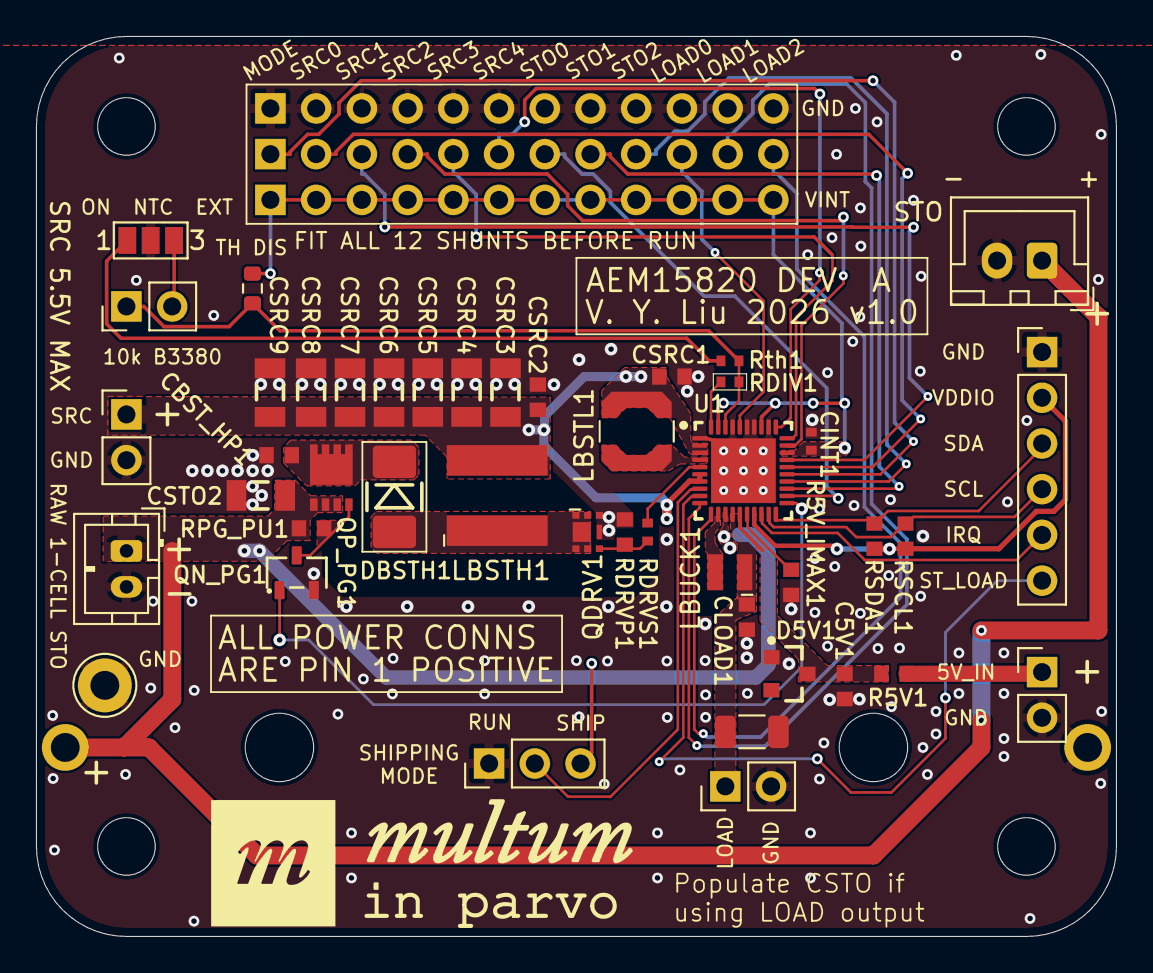
[picture p21: board hardware/mesh-node/mesh-node.kicad_pcb from above]

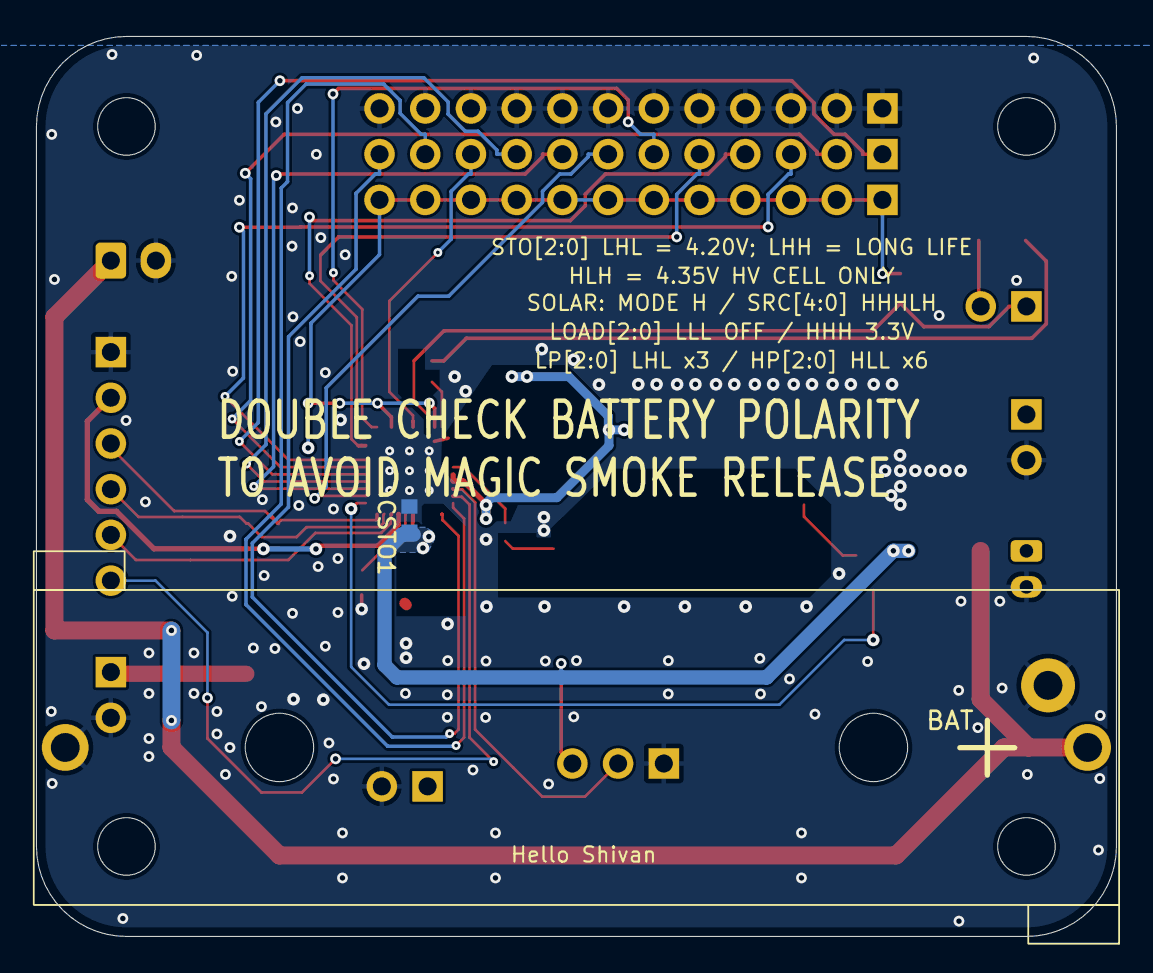
[picture p22: board hardware/mesh-node/mesh-node.kicad_pcb from below]

Board: 2 copper layers, 60.0 x 50.0 mm, 53 parts (2 on the bottom side), 38 nets.

Parts:
BAT: Bulgin BX0035 Battery Holder
C5V1: 47uF; AEM_Donor_C0603_[1608]
CBST_HP1: 47uF; AEM_Donor_C0603_[1608]
CINT1: 10uF; AEM_Donor_C0402_[1005]
CLOAD1: 22uF; AEM_Donor_C0603_[1608]
CLOAD2: OPTIONAL 220uF; C_1206_3216Metric
CSRC1, CSRC2: 22uF; AEM_Donor_C0603_[1608]
CSRC3, CSRC4, CSRC5, CSRC6, CSRC7, CSRC8, CSRC9: 220uF; AEM_Donor_C1206_[3216]
CSTO1: 47uF; AEM_Donor_C0603_[1608]
CSTO2: 220uF; AEM_Donor_C1206_[3216]
D5V1: 5.1V; AEM_Donor_SOT23-3P__3x1.40mm_Pitch=0.915mm_diode_AK
DBSTH1: VS-10BQ015; AEM_Donor_DO-214AA
H1, H2, H3, H4: M3; MountingHole_3.2mm_M3
J5V1: J5V1; PinHeader_1x02_P2.54mm_Vertical
JCFG1: LOW / GND; PinHeader_1x12_P2.54mm_Vertical
JCFG2: SIGNALS; PinHeader_1x12_P2.54mm_Vertical
JCFG3: HIGH / VINT; PinHeader_1x12_P2.54mm_Vertical
JIO1: JIO1; PinHeader_1x06_P2.54mm_Vertical
JLOAD1: JLOAD1; PinHeader_1x02_P2.54mm_Vertical
JNTC1: EXT NTC 10k B3380; PinHeader_1x02_P2.54mm_Vertical
JPNTC1: ONBOARD / EXTERNAL; SolderJumper-3_P1.3mm_Open_Pad1.0x1.5mm_NumberLabels
JSHIP1: RUN / SHIP; PinHeader_1x03_P2.54mm_Vertical
JSRC1: JSRC1; PinHeader_1x02_P2.54mm_Vertical
JSTO1: STO+ / STO-; JST_PH_2
LBSTH1: 3.3uH; L_Wurth_74438367033
LBSTL1: 33uH; L_Coilcraft_LPS4018
LBUCK1: 10uH; L_TDK_VLS252012CX
QDRV1: RF4E100AJ; ROHM_HUML2020L8_RF4E100AJ
QN_PG1: BSS138N; AEM_Donor_SOT23-3L_STM-L
QP_PG1: DMP2005UFG; DMP2005UFG_PowerDI3333_8_GSD
R5V1: 2.2R 0.1W; AEM_Donor_Resistor_0603_[1608]
R5V_IMAX1: 1.5k / 33.3mA; AEM_Donor_Resistor_0603_[1608]
RDIV1: 22k; AEM_Donor_Resistor_0402
RDRVP1: 330k; AEM_Donor_Resistor_0603_[1608]
RDRVS1: 0R; AEM_Donor_Resistor_0402
RPG_PU1: 330k; AEM_Donor_Resistor_0603_[1608]
RSCL1: 1k; AEM_Donor_Resistor_0603_[1608]
RSDA1: 1k; AEM_Donor_Resistor_0603_[1608]
RTHDIS1: 0R / THERMAL DISABLE; R_0603_1608Metric
Rth1: 10k B3380; AEM_Donor_Resistor_0402
STO: JST_XH_B2B-XH-A_1x02_P2.50mm_Vertical
TPSTO2: TP_STO-; TestPoint_THTPad_D3.0mm_Drill1.5mm
U1: AEM15820; AEM15820_QFN40

Connections:
5V_IMAX: R5V_IMAX1.2, U1.16
5V_IN: C5V1.2, D5V1.1, R5V1.2, U1.15
5V_IN_EXT: J5V1.1, R5V1.1
BST_HP_DRV: RDRVS1.2, U1.5
BST_HP_PG: QN_PG1.1, U1.21
GND: BAT.2, C5V1.1, CBST_HP1.1, CINT1.1, CLOAD1.1, CLOAD2.2, CSRC1.1, CSRC2.1, CSRC3.1, CSRC4.1, CSRC5.1, CSRC6.1, CSRC7.1, CSRC8.1, CSRC9.1, CSTO1.1, CSTO2.1, D5V1.2, J5V1.2, JCFG1.1, JCFG1.2, JCFG1.3, JCFG1.4, JCFG1.5, JCFG1.6, JCFG1.7, JCFG1.8, JCFG1.9, JCFG1.10, JCFG1.11, JCFG1.12, JIO1.1, JLOAD1.2, JPNTC1.2, JSHIP1.1, JSRC1.2, JSTO1.2, QDRV1.4, QDRV1.8, QN_PG1.2, R5V_IMAX1.1, RDRVP1.1, STO.2, TPSTO2.1, U1.1, U1.32, U1.34, U1.35, U1.37, U1.41
IRQ: JIO1.5, U1.18
LOAD: CLOAD1.2, CLOAD2.1, JLOAD1.1, LBUCK1.1, U1.14
LOAD_CFG_0: JCFG2.10, U1.36
LOAD_CFG_1: JCFG2.11, U1.10
LOAD_CFG_2: JCFG2.12, U1.11
NTC_EXT_RETURN: JNTC1.2, JPNTC1.3
NTC_ON_RETURN: JPNTC1.1, Rth1.1
NetCBST_HP_2: CBST_HP1.2, DBSTH1.1, QP_PG1.3
NetDBSTH_A: DBSTH1.2, LBSTH1.1, QDRV1.1, QDRV1.2, QDRV1.5, QDRV1.6, QDRV1.7
NetQDRV_1: QDRV1.3, RDRVP1.2, RDRVS1.1
NetQN_PG_3: QN_PG1.3, QP_PG1.1, RPG_PU1.1
NetRdiv_1: JNTC1.1, RDIV1.1, RTHDIS1.1, Rth1.2, U1.38
NetRdiv_2: RDIV1.2, U1.40
SCL: JIO1.4, RSCL1.1, U1.19
SDA: JIO1.3, RSDA1.1, U1.20
SHIP_MODE: JSHIP1.2, U1.8
SRC: CSRC1.2, CSRC2.2, CSRC3.2, CSRC4.2, CSRC5.2, CSRC6.2, CSRC7.2, CSRC8.2, CSRC9.2, JSRC1.1, LBSTH1.2, LBSTL1.2, U1.2, U1.3, U1.6, U1.7
SRC_CFG_0: JCFG2.2, U1.26
SRC_CFG_1: JCFG2.3, U1.27
SRC_CFG_2: JCFG2.4, U1.29
SRC_CFG_3: JCFG2.5, U1.30
SRC_CFG_4: JCFG2.6, U1.31
SRC_MODE: JCFG2.1, U1.25
STO: BAT.1, CSTO1.2, CSTO2.2, JSHIP1.3, JSTO1.1, QP_PG1.2, RPG_PU1.2, STO.1, U1.13
STO_CFG_0: JCFG2.7, U1.22
STO_CFG_1: JCFG2.8, U1.23
STO_CFG_2: JCFG2.9, U1.24
ST_LOAD: JIO1.6, U1.9
SWBST_LP: LBSTL1.1, U1.4
SWBUCK: LBUCK1.2, U1.12
VDDIO: JIO1.2, RSCL1.2, RSDA1.2, U1.17
VINT: CINT1.2, JCFG3.1, JCFG3.2, JCFG3.3, JCFG3.4, JCFG3.5, JCFG3.6, JCFG3.7, JCFG3.8, JCFG3.9, JCFG3.10, JCFG3.11, JCFG3.12, RTHDIS1.2, U1.28, U1.33, U1.39
