Liftyee/multum-in-parvo/hardware/mesh-node.kicad_pcb

## KiCad design hardware/mesh-node.kicad_pcb (2026-09-08)

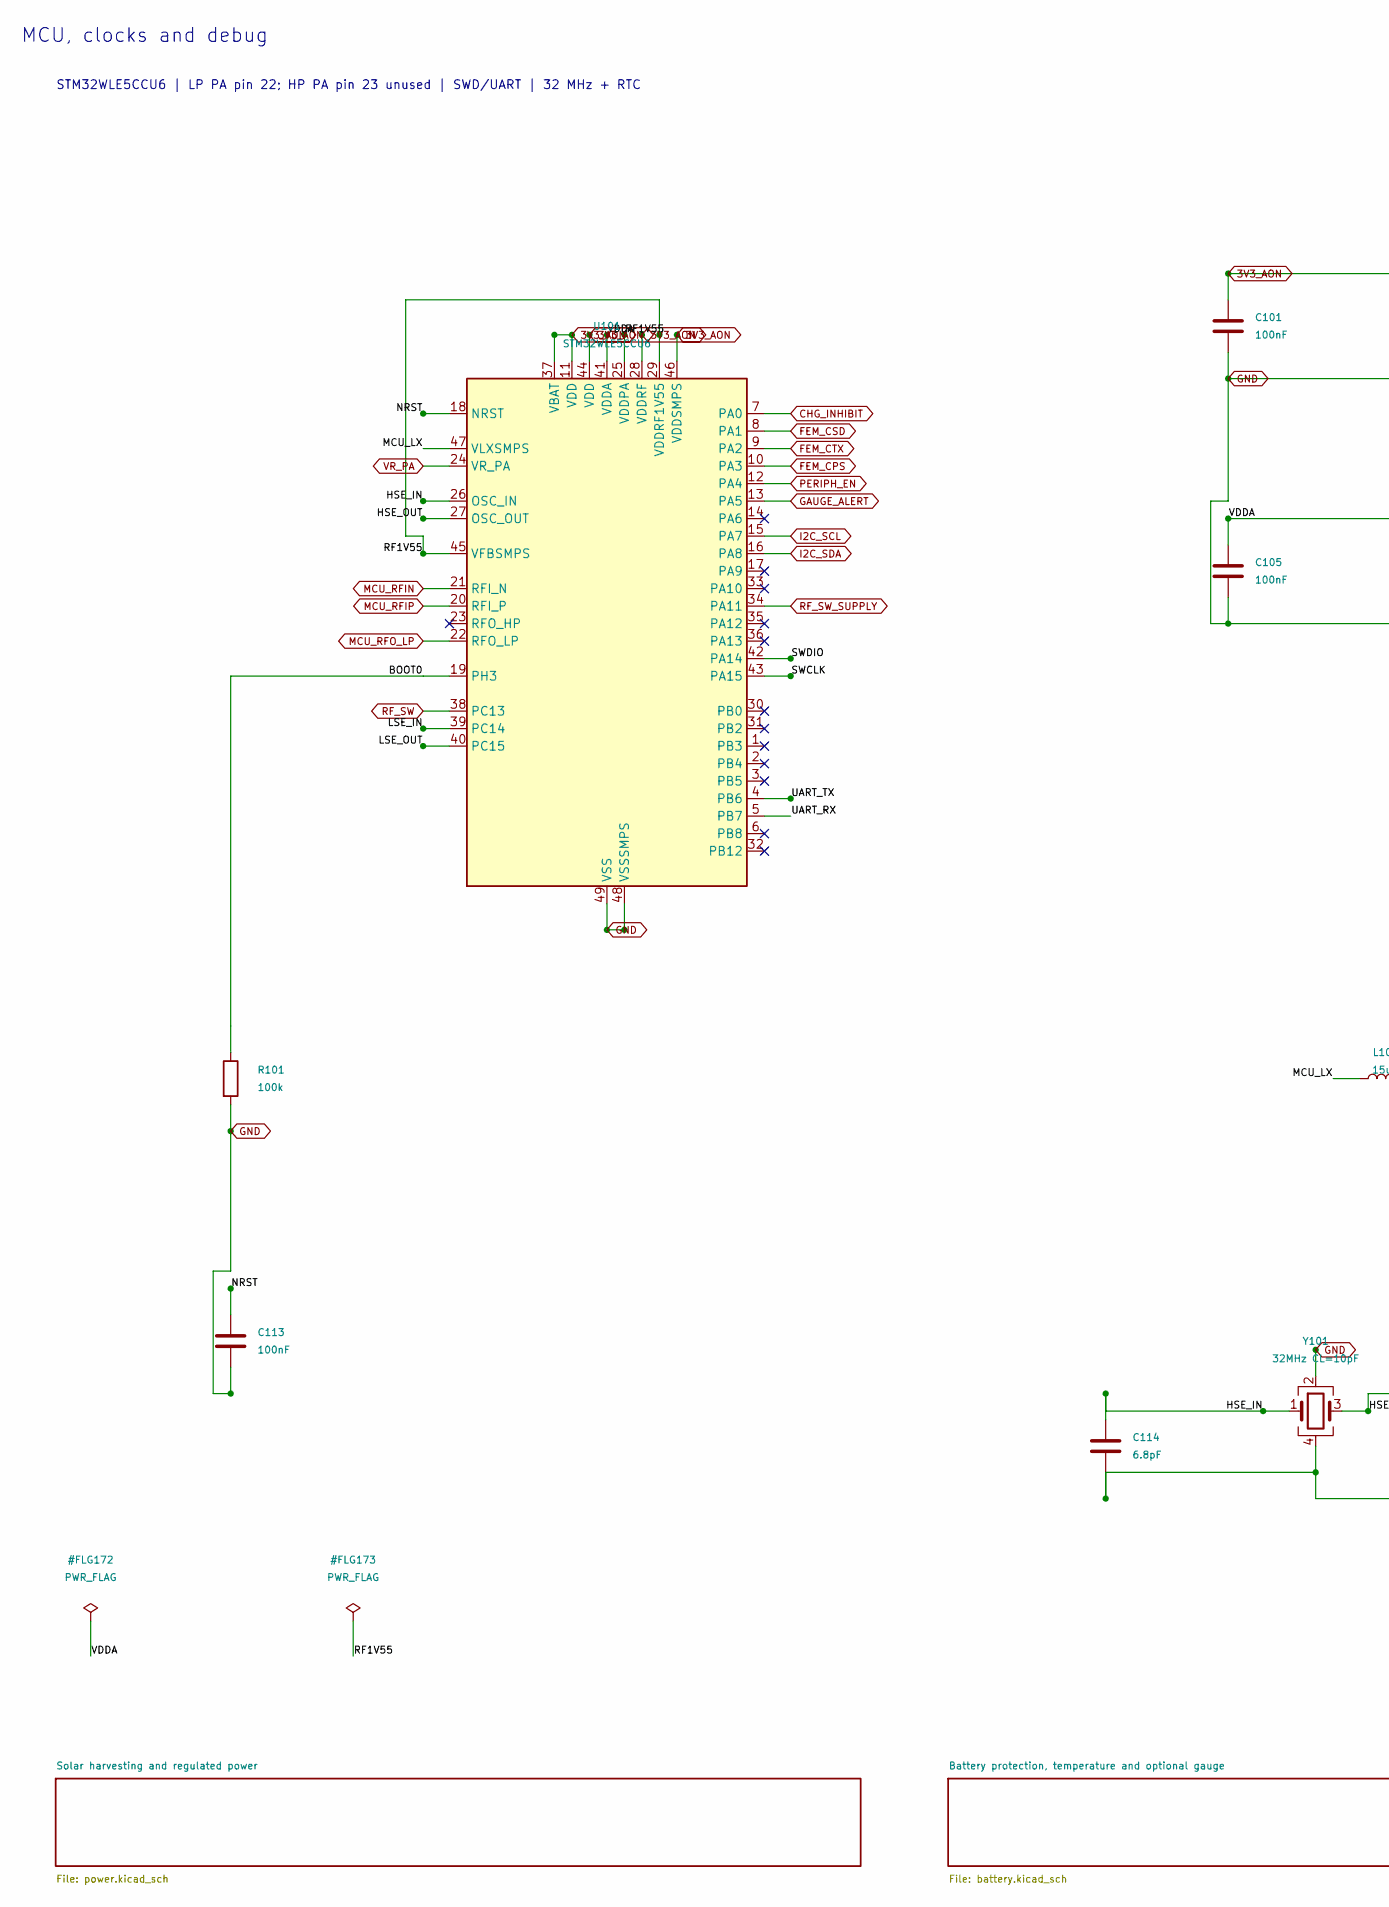
[picture p23: schematic mesh-node.kicad_sch, MCU, clocks and debug, part in row 1, column 1]

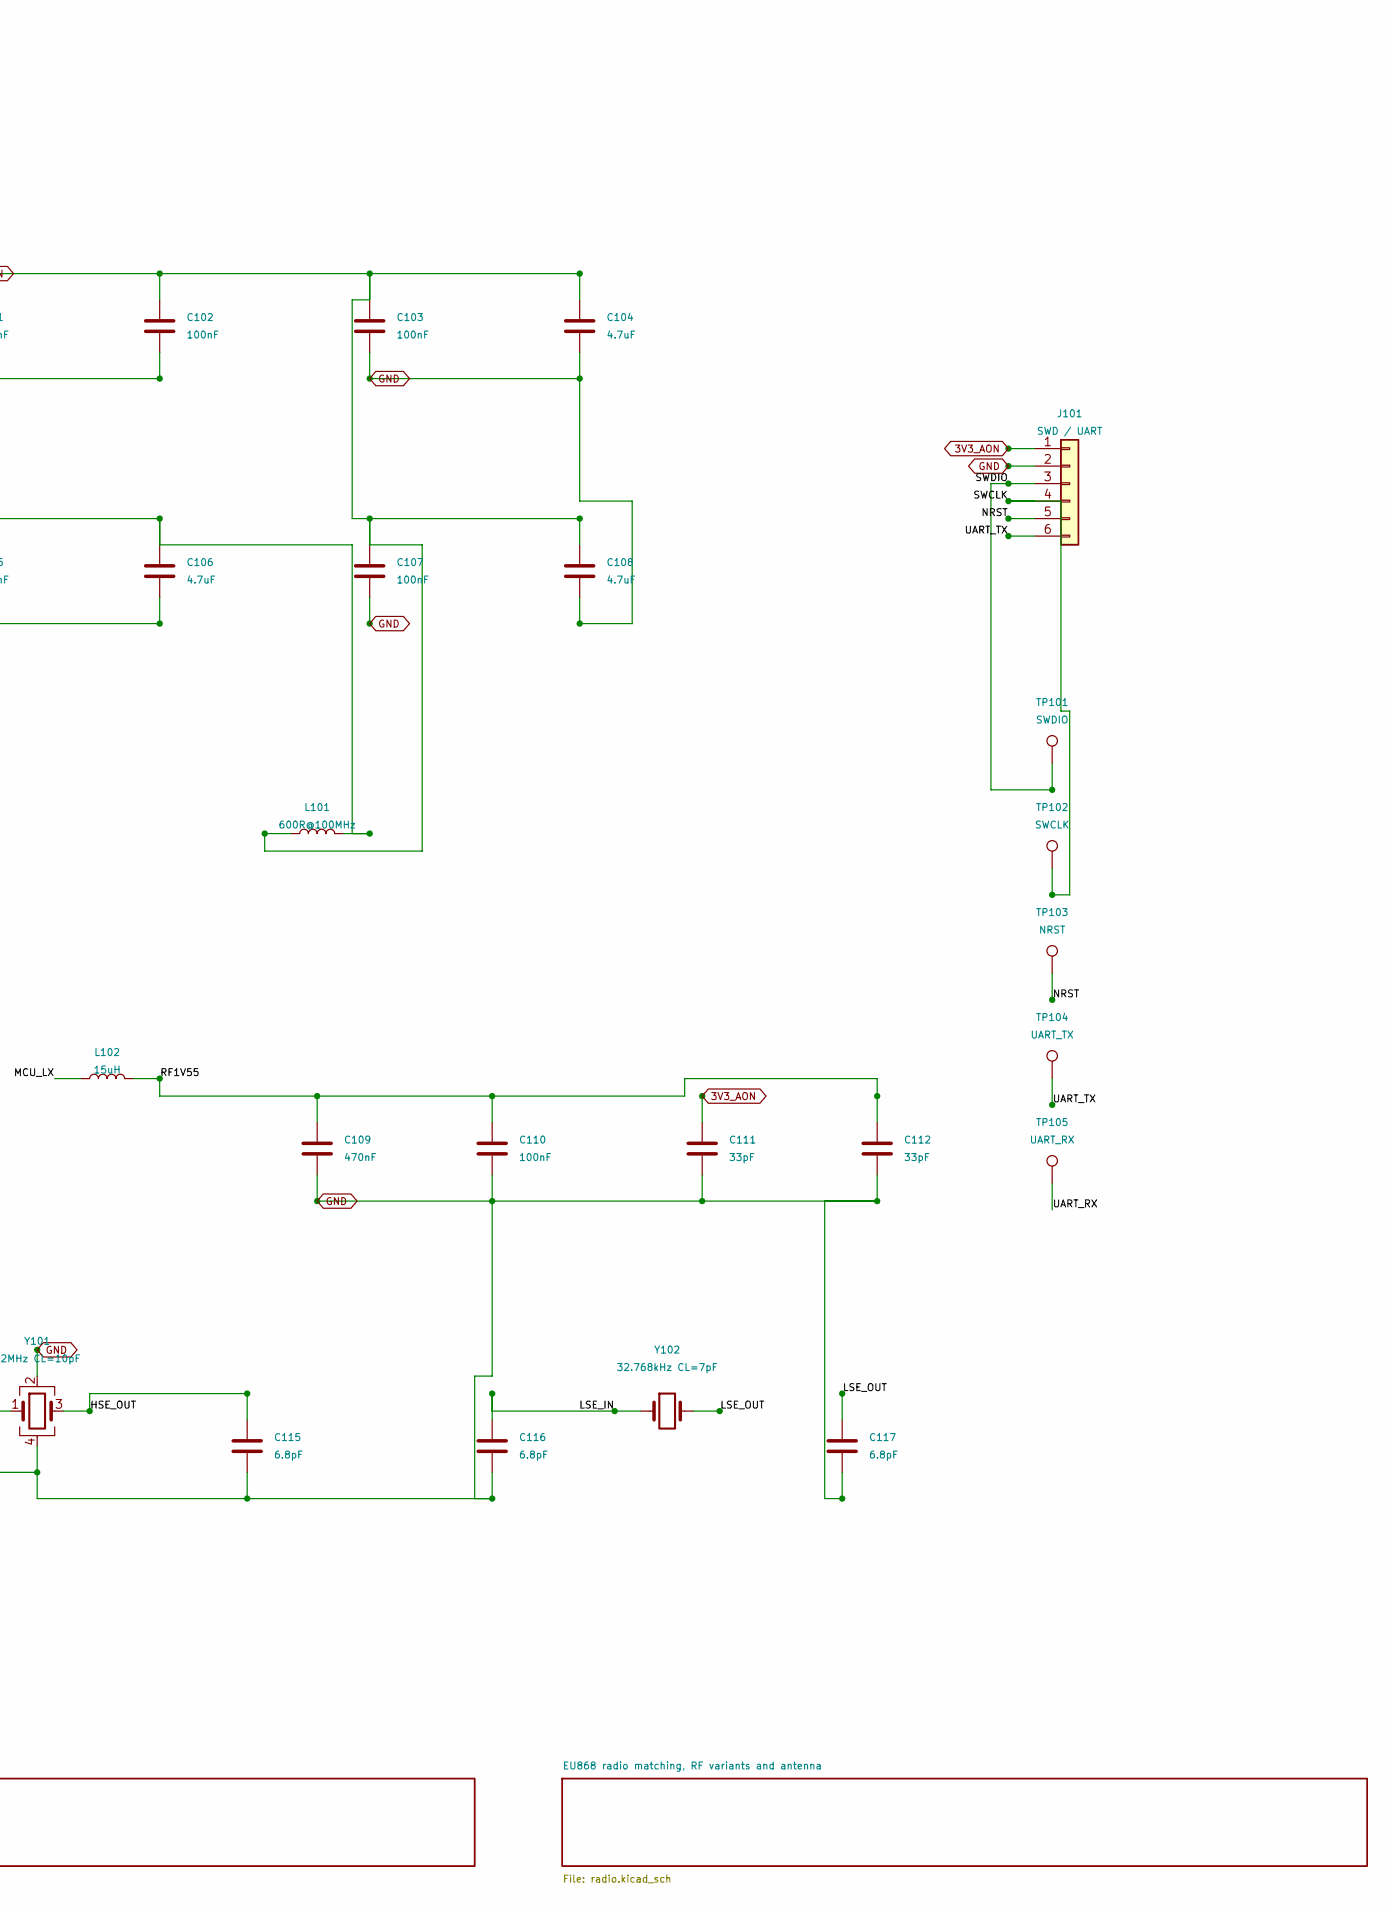
[picture p24: schematic mesh-node.kicad_sch, MCU, clocks and debug, part in row 1, column 2]

Parts:
C101, C102, C103, C105, C107, C110, C113: 100nF; C0603; MPN 100nF
C104, C106, C108: 4.7uF; C0603; MPN 4.7uF
C109: 470nF; C0603; MPN 470nF
C111, C112: 33pF; C0402; MPN 33pF
C114, C115, C116, C117: 6.8pF; C0402; MPN 6.8pF
J101: SWD / UART; Header1x6; MPN SWD / UART
L101: 600R@100MHz; L0603; MPN BLM18AG601SN1D
L102: 15uH; L2520; MPN LQM2MPN150MEHL
R101: 100k; R0603; MPN 100k
TP101: SWDIO; TestPad; MPN SWDIO
TP102: SWCLK; TestPad; MPN SWCLK
TP103: NRST; TestPad; MPN NRST
TP104: UART_TX; TestPad; MPN UART_TX
TP105: UART_RX; TestPad; MPN UART_RX
U101: STM32WLE5CCU6; STM32WLE5_QFN48; MPN STM32WLE5CCU6
Y101: 32MHz CL=10pF; Crystal3225; MPN ABM8-32.000MHZ-10-D1G-T
Y102: 32.768kHz CL=7pF; Crystal3215; MPN ABS07-32.768KHZ-7-T

Connections:
3V3_AON: C101.1, C102.1, C103.1, C104.1, C107.1, C108.1, C111.1, J101.1, L101.1, U101.11 (VDD), U101.28 (VDDRF), U101.37 (VBAT), U101.44 (VDD), U101.46 (VDDSMPS); also elsewhere on the board
/BOOT0: R101.1, U101.19 (PH3)
/HSE_IN: C114.1, U101.26 (OSC_IN), Y101.1
/HSE_OUT: C115.1, U101.27 (OSC_OUT), Y101.3
/LSE_IN: C116.1, U101.39 (PC14), Y102.1
/LSE_OUT: C117.1, U101.40 (PC15), Y102.2
/MCU_LX: L102.1, U101.47 (VLXSMPS)
/NRST: C113.1, J101.5, TP103.1, U101.18 (NRST)
/RF1V55: C109.1, C110.1, C112.1, L102.2, U101.25 (VDDPA), U101.29 (VDDRF1V55), U101.45 (VFBSMPS)
/SWCLK: J101.4, TP102.1, U101.43 (PA15)
/SWDIO: J101.3, TP101.1, U101.42 (PA14)
/UART_RX: TP105.1, U101.5 (PB7)
/UART_TX: J101.6, TP104.1, U101.4 (PB6)
/VDDA: C105.1, C106.1, L101.2, U101.41 (VDDA)
CHG_INHIBIT: U101.7 (PA0); also elsewhere on the board
FEM_CPS: U101.10 (PA3); also elsewhere on the board
FEM_CSD: U101.8 (PA1); also elsewhere on the board
FEM_CTX: U101.9 (PA2); also elsewhere on the board
GAUGE_ALERT: U101.13 (PA5); also elsewhere on the board
GND: C101.2, C102.2, C103.2, C104.2, C105.2, C106.2, C107.2, C108.2, C109.2, C110.2, C111.2, C112.2, C113.2, C114.2, C115.2, C116.2, C117.2, J101.2, R101.2, U101.48 (VSSSMPS), U101.49 (VSS), Y101.2, Y101.4; also elsewhere on the board
I2C_SCL: U101.15 (PA7); also elsewhere on the board
I2C_SDA: U101.16 (PA8); also elsewhere on the board
MCU_RFIN: U101.21 (RFI_N); also elsewhere on the board
MCU_RFIP: U101.20 (RFI_P); also elsewhere on the board
MCU_RFO_LP: U101.22 (RFO_LP); also elsewhere on the board
PERIPH_EN: U101.12 (PA4); also elsewhere on the board
RF_SW: U101.38 (PC13); also elsewhere on the board
RF_SW_SUPPLY: U101.34 (PA11); also elsewhere on the board
VR_PA: U101.24 (VR_PA); also elsewhere on the board

Notes on the sheet:
MCU, clocks and debug
STM32WLE5CCU6 | LP PA pin 22; HP PA pin 23 unused | SWD/UART | 32 MHz + RTC
