Liftyee/multum-in-parvo/hardware/mesh-node.kicad_pcb

## KiCad design hardware/mesh-node.kicad_pcb (continued)

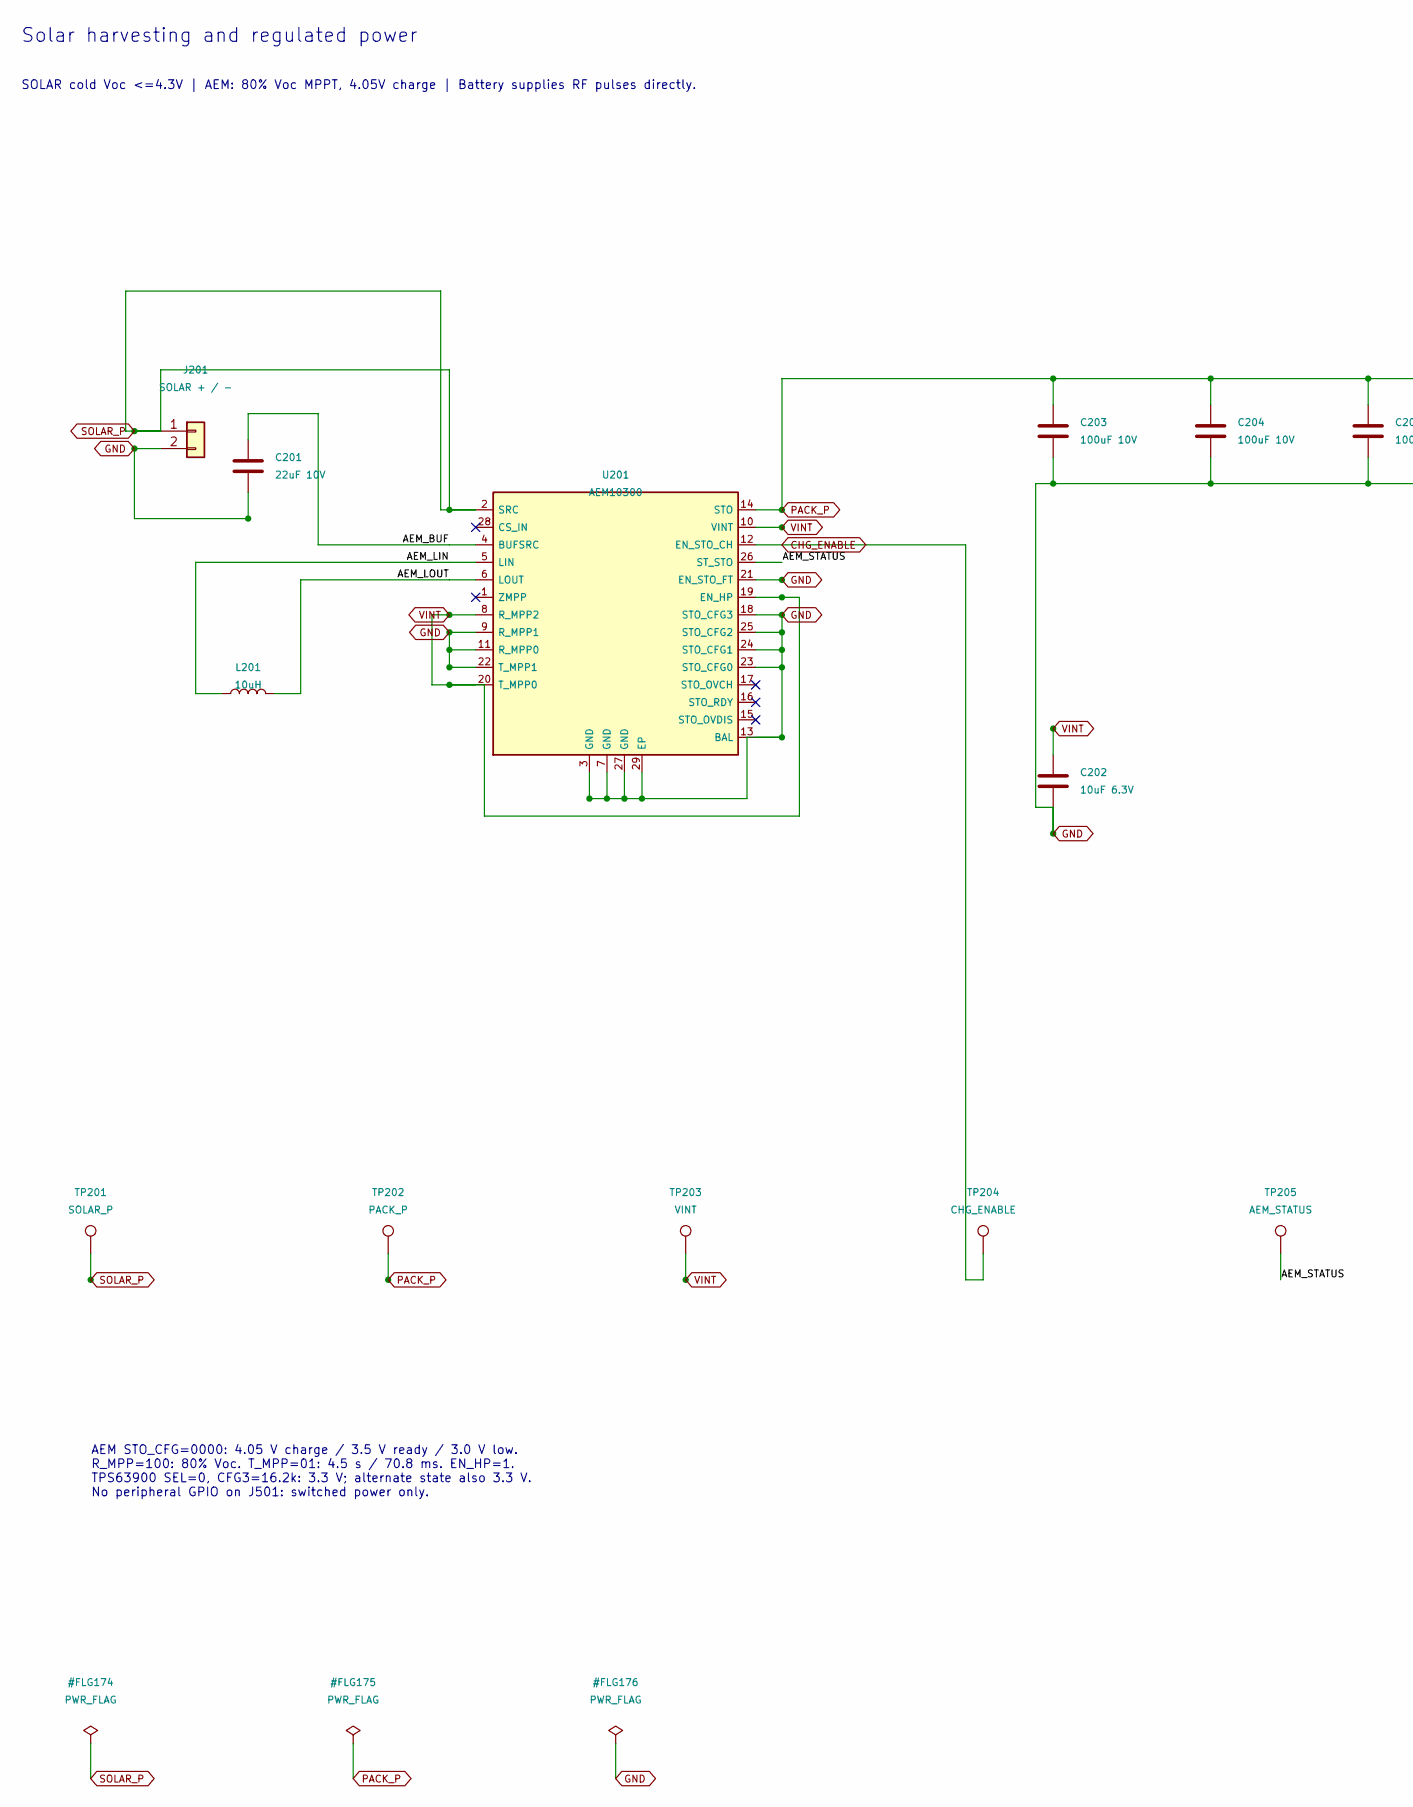
[picture p25: schematic power.kicad_sch, Solar harvesting and regulated power, part in row 1, column 1]

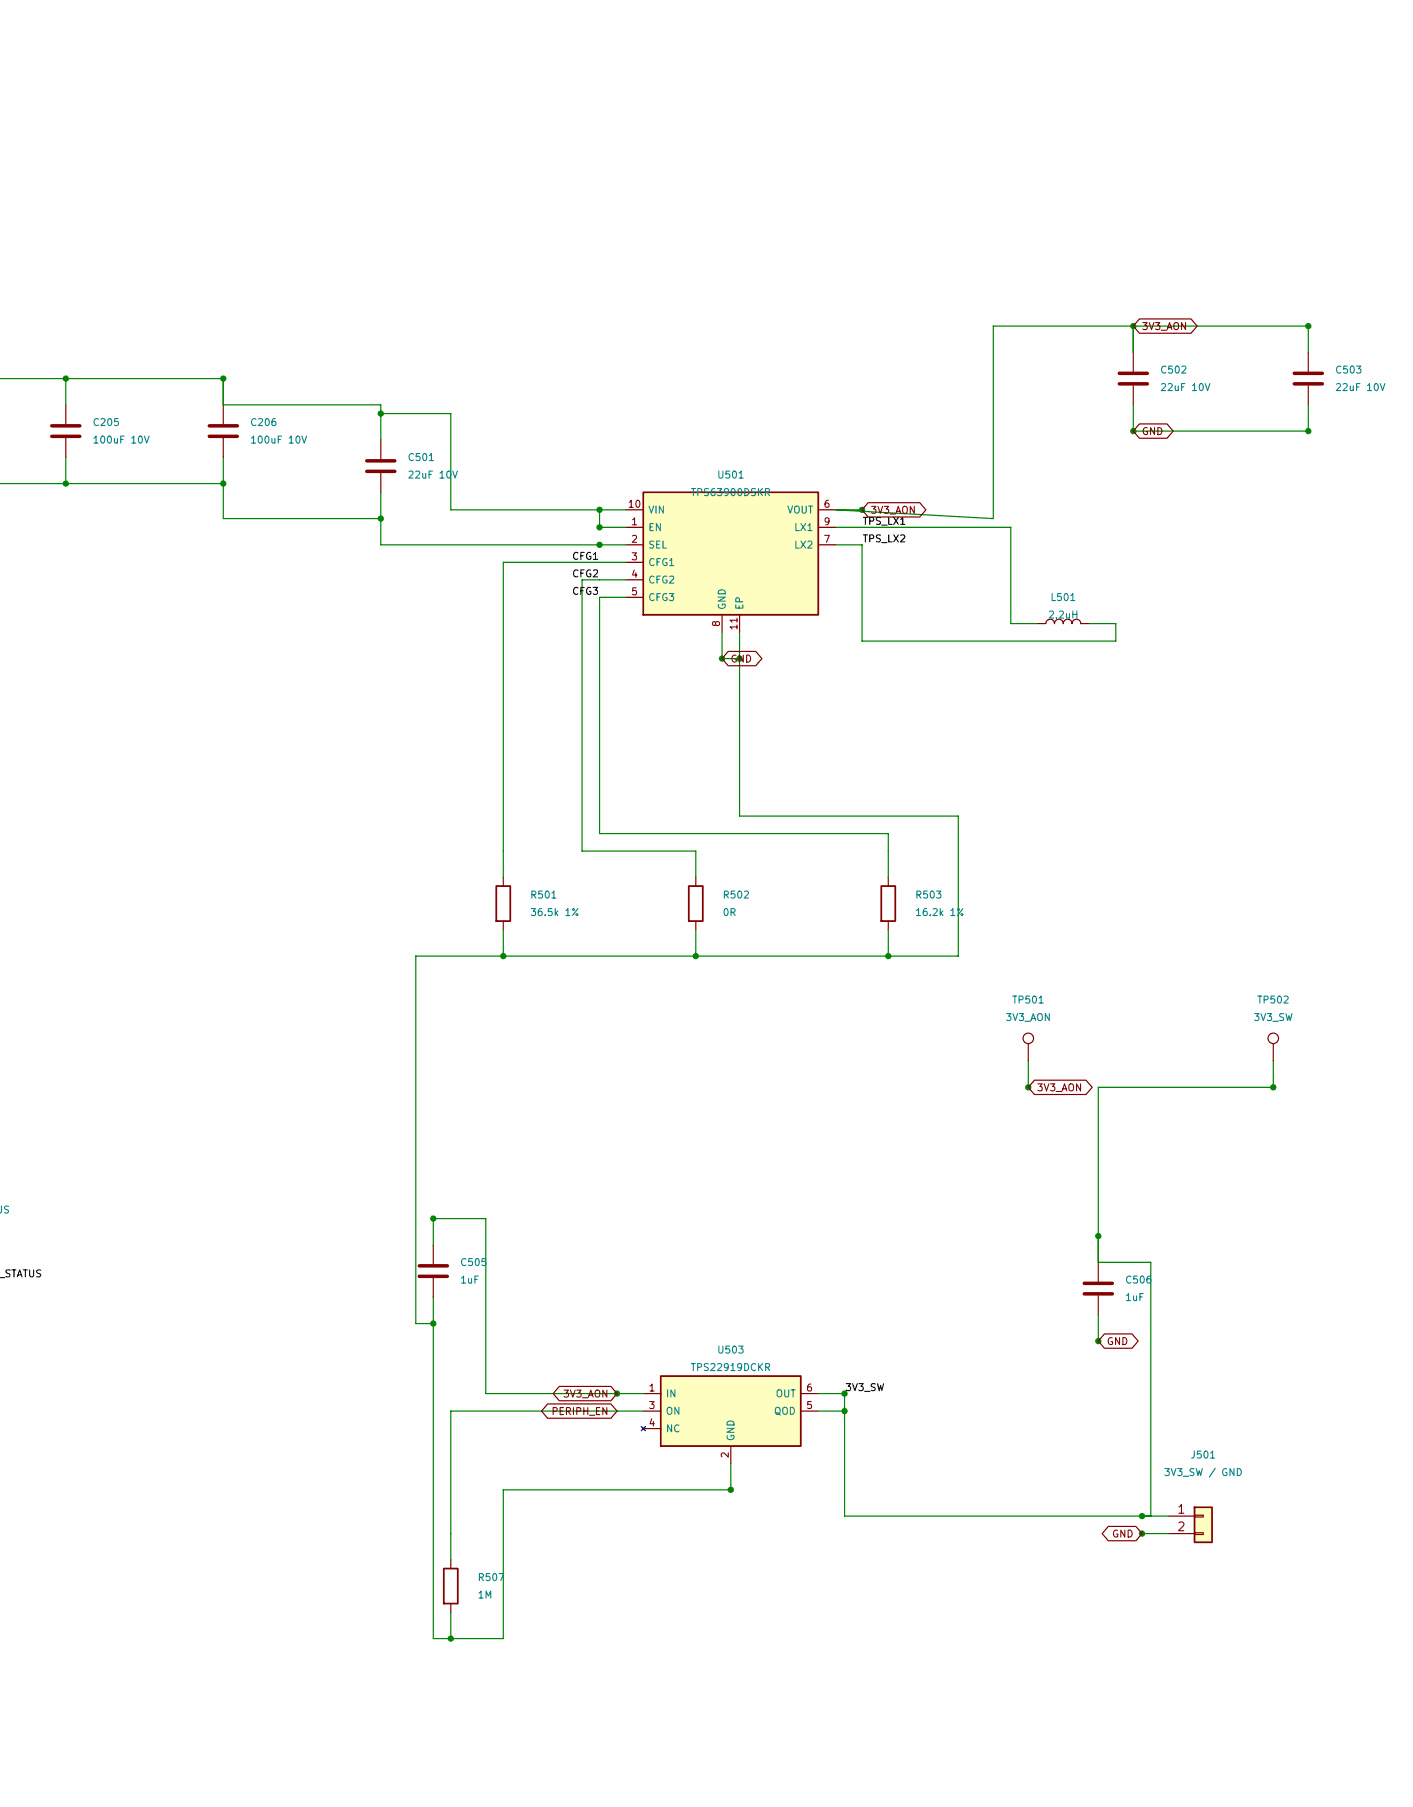
[picture p26: schematic power.kicad_sch, Solar harvesting and regulated power, part in row 1, column 2]

Parts:
C201: 22uF 10V; C0805; MPN GRM21BR61A226ME44L
C202: 10uF 6.3V; C0805; MPN 10uF 6.3V
C203, C204, C205, C206: 100uF 10V; C1210; MPN GRM32ER61A107ME20L
C501, C502, C503: 22uF 10V; C0805; MPN 22uF 10V
C505, C506: 1uF; C0603; MPN 1uF
J201: SOLAR + / -; JST_PH_2; MPN B2B-PH-K-S(LF)(SN)
J501: 3V3_SW / GND; Header1x2; MPN 3V3_SW / GND
L201: 10uH; L2520; MPN DFE252010F-100M
L501: 2.2uH; L2520; MPN DFE252012F-2R2M
R501: 36.5k 1%; R0603; MPN 36.5k 1%
R502: 0R; R0603; MPN 0R
R503: 16.2k 1%; R0603; MPN 16.2k 1%
R507: 1M; R0603; MPN 1M
TP201: SOLAR_P; TestPad; MPN SOLAR_P
TP202: PACK_P; TestPad; MPN PACK_P
TP203: VINT; TestPad; MPN VINT
TP204: CHG_ENABLE; TestPad; MPN CHG_ENABLE
TP205: AEM_STATUS; TestPad; MPN AEM_STATUS
TP501: 3V3_AON; TestPad; MPN 3V3_AON
TP502: 3V3_SW; TestPad; MPN 3V3_SW
U201: AEM10300; AEM10300_QFN28; MPN AEM10300
U501: TPS63900DSKR; TPS63900_WSON10; MPN TPS63900DSKR
U503: TPS22919DCKR; SC70_6; MPN TPS22919DCKR

Connections:
3V3_AON: C502.1, C503.1, C505.1, TP501.1, U501.6 (VOUT), U503.1 (IN); also elsewhere on the board
/Solar harvesting and regulated power/3V3_SW: C506.1, J501.1, TP502.1, U503.5 (QOD), U503.6 (OUT)
/Solar harvesting and regulated power/AEM_BUF: C201.1, U201.4 (BUFSRC)
/Solar harvesting and regulated power/AEM_LIN: L201.1, U201.5 (LIN)
/Solar harvesting and regulated power/AEM_LOUT: L201.2, U201.6 (LOUT)
/Solar harvesting and regulated power/AEM_STATUS: TP205.1, U201.26 (ST_STO)
/Solar harvesting and regulated power/CFG1: R501.1, U501.3 (CFG1)
/Solar harvesting and regulated power/CFG2: R502.1, U501.4 (CFG2)
/Solar harvesting and regulated power/CFG3: R503.1, U501.5 (CFG3)
/Solar harvesting and regulated power/TPS_LX1: L501.1, U501.9 (LX1)
/Solar harvesting and regulated power/TPS_LX2: L501.2, U501.7 (LX2)
CHG_ENABLE: TP204.1, U201.12 (EN_STO_CH); also elsewhere on the board
GND: C201.2, C202.2, C203.2, C204.2, C205.2, C206.2, C501.2, C502.2, C503.2, C505.2, C506.2, J201.2, J501.2, R501.2, R502.2, R503.2, R507.2, U201.3 (GND), U201.7 (GND), U201.9 (R_MPP1), U201.11 (R_MPP0), U201.13 (BAL), U201.18 (STO_CFG3), U201.21 (EN_STO_FT), U201.22 (T_MPP1), U201.23 (STO_CFG0), U201.24 (STO_CFG1), U201.25 (STO_CFG2), U201.27 (GND), U201.29 (EP), U501.2 (SEL), U501.8 (GND), U501.11 (EP), U503.2 (GND); also elsewhere on the board
PACK_P: C203.1, C204.1, C205.1, C206.1, C501.1, TP202.1, U201.14 (STO), U501.1 (EN), U501.10 (VIN); also elsewhere on the board
PERIPH_EN: R507.1, U503.3 (ON); also elsewhere on the board
SOLAR_P: J201.1, TP201.1, U201.2 (SRC); also elsewhere on the board
VINT: C202.1, TP203.1, U201.8 (R_MPP2), U201.10 (VINT), U201.19 (EN_HP), U201.20 (T_MPP0); also elsewhere on the board

Notes on the sheet:
Solar harvesting and regulated power
SOLAR cold Voc <=4.3V | AEM: 80% Voc MPPT, 4.05V charge | Battery supplies RF pulses directly.
AEM STO_CFG=0000: 4.05 V charge / 3.5 V ready / 3.0 V low. R_MPP=100: 80% Voc. T_MPP=01: 4.5 s / 70.8 ms. EN_HP=1. TPS63900 SEL=0, CFG3=16.2k: 3.3 V; alternate state also 3.3 V. No peripheral GPIO on J501: switched power only.

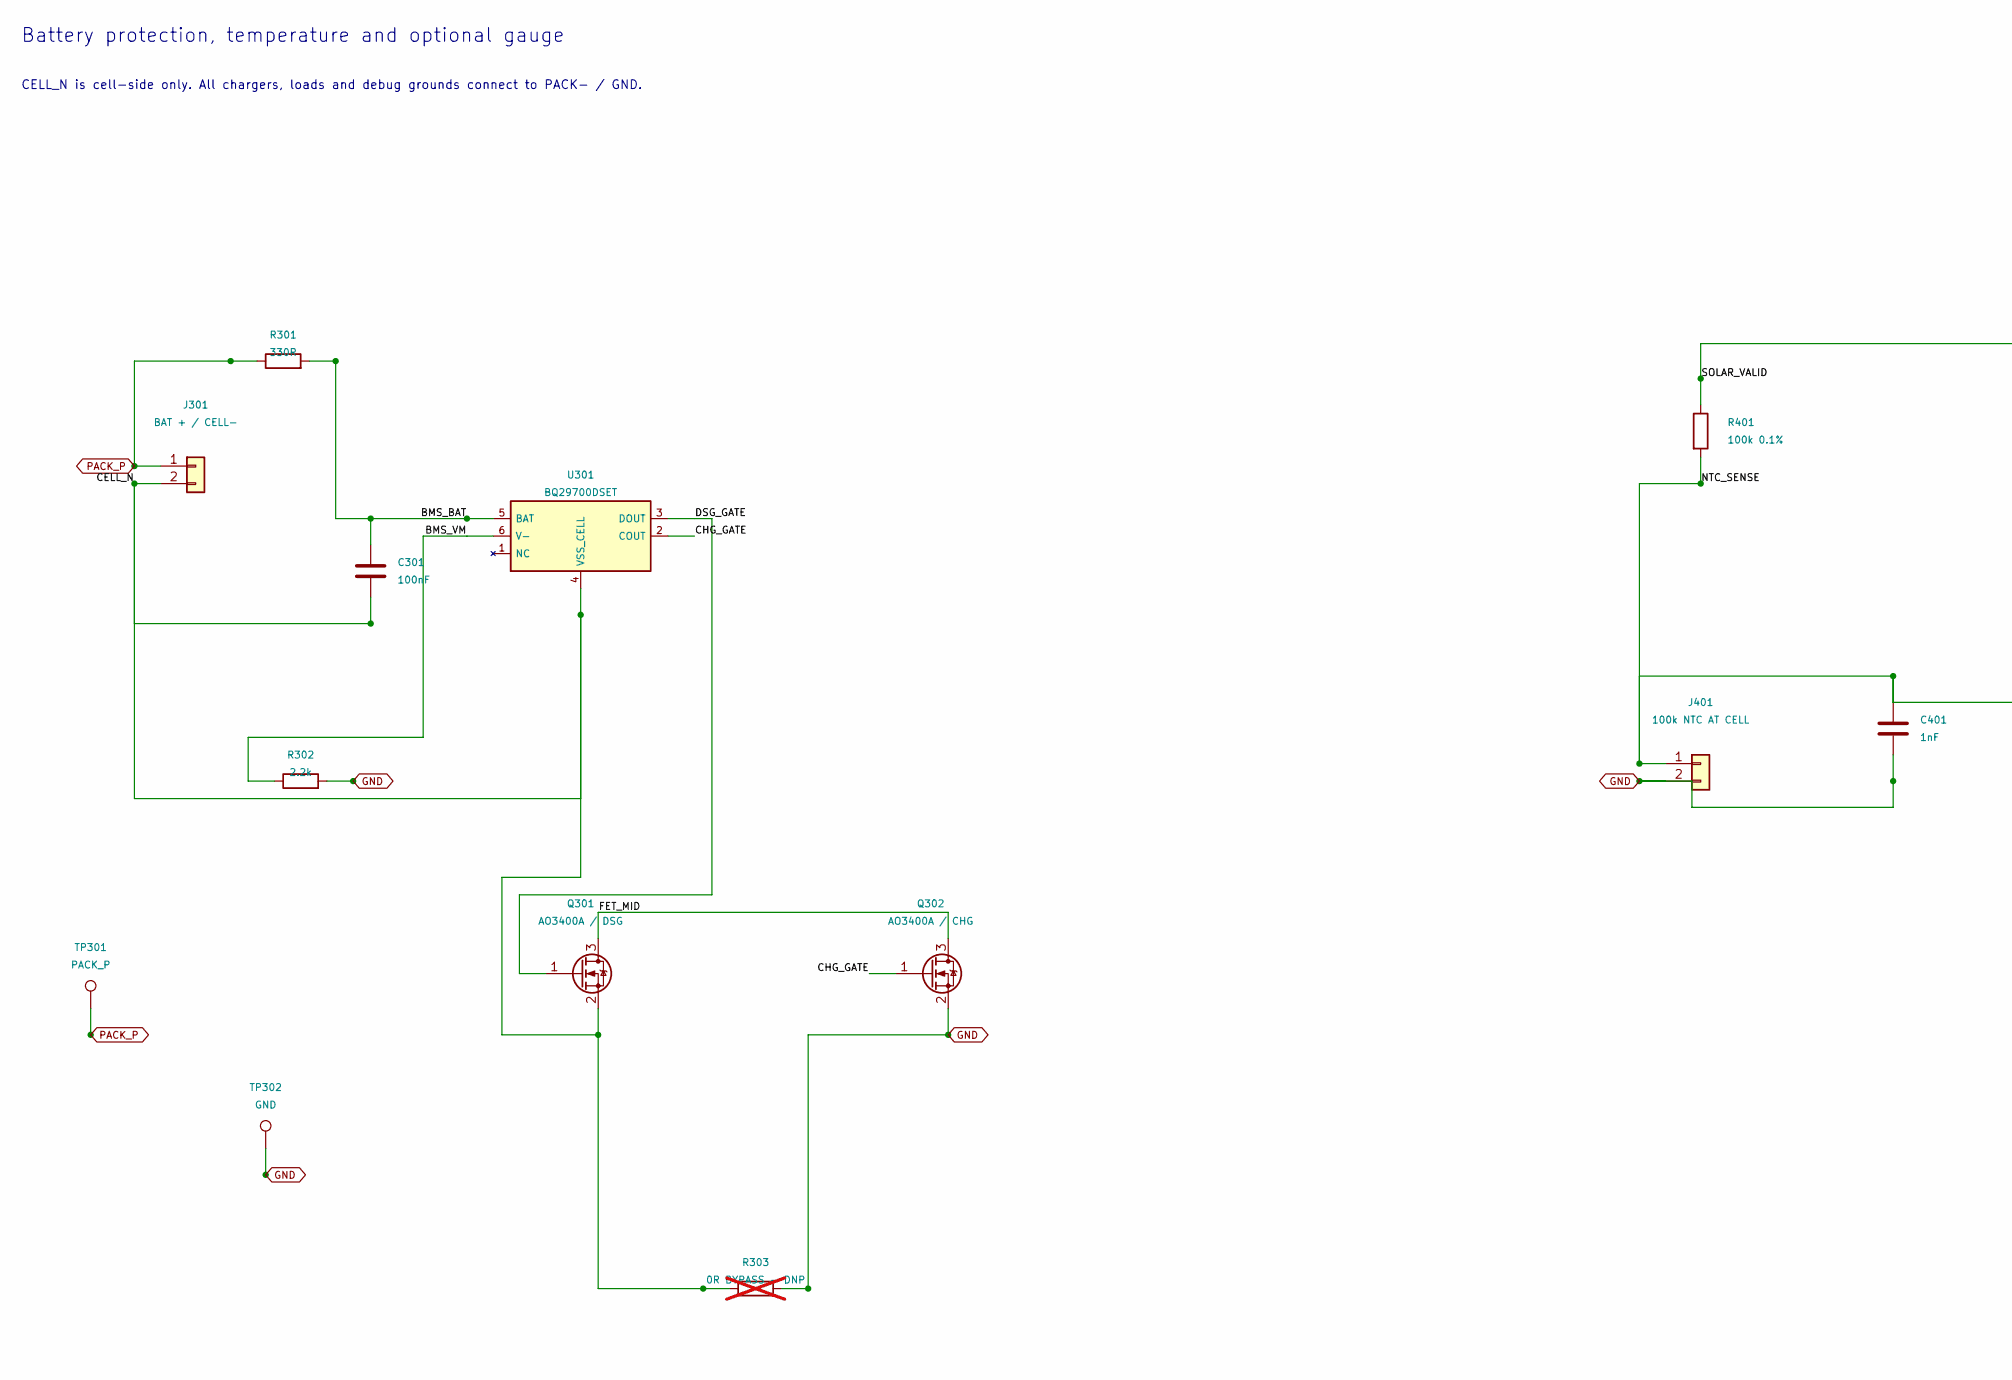
[picture p27: schematic battery.kicad_sch, Battery protection, temperature and optional gauge, part in row 1, column 1]

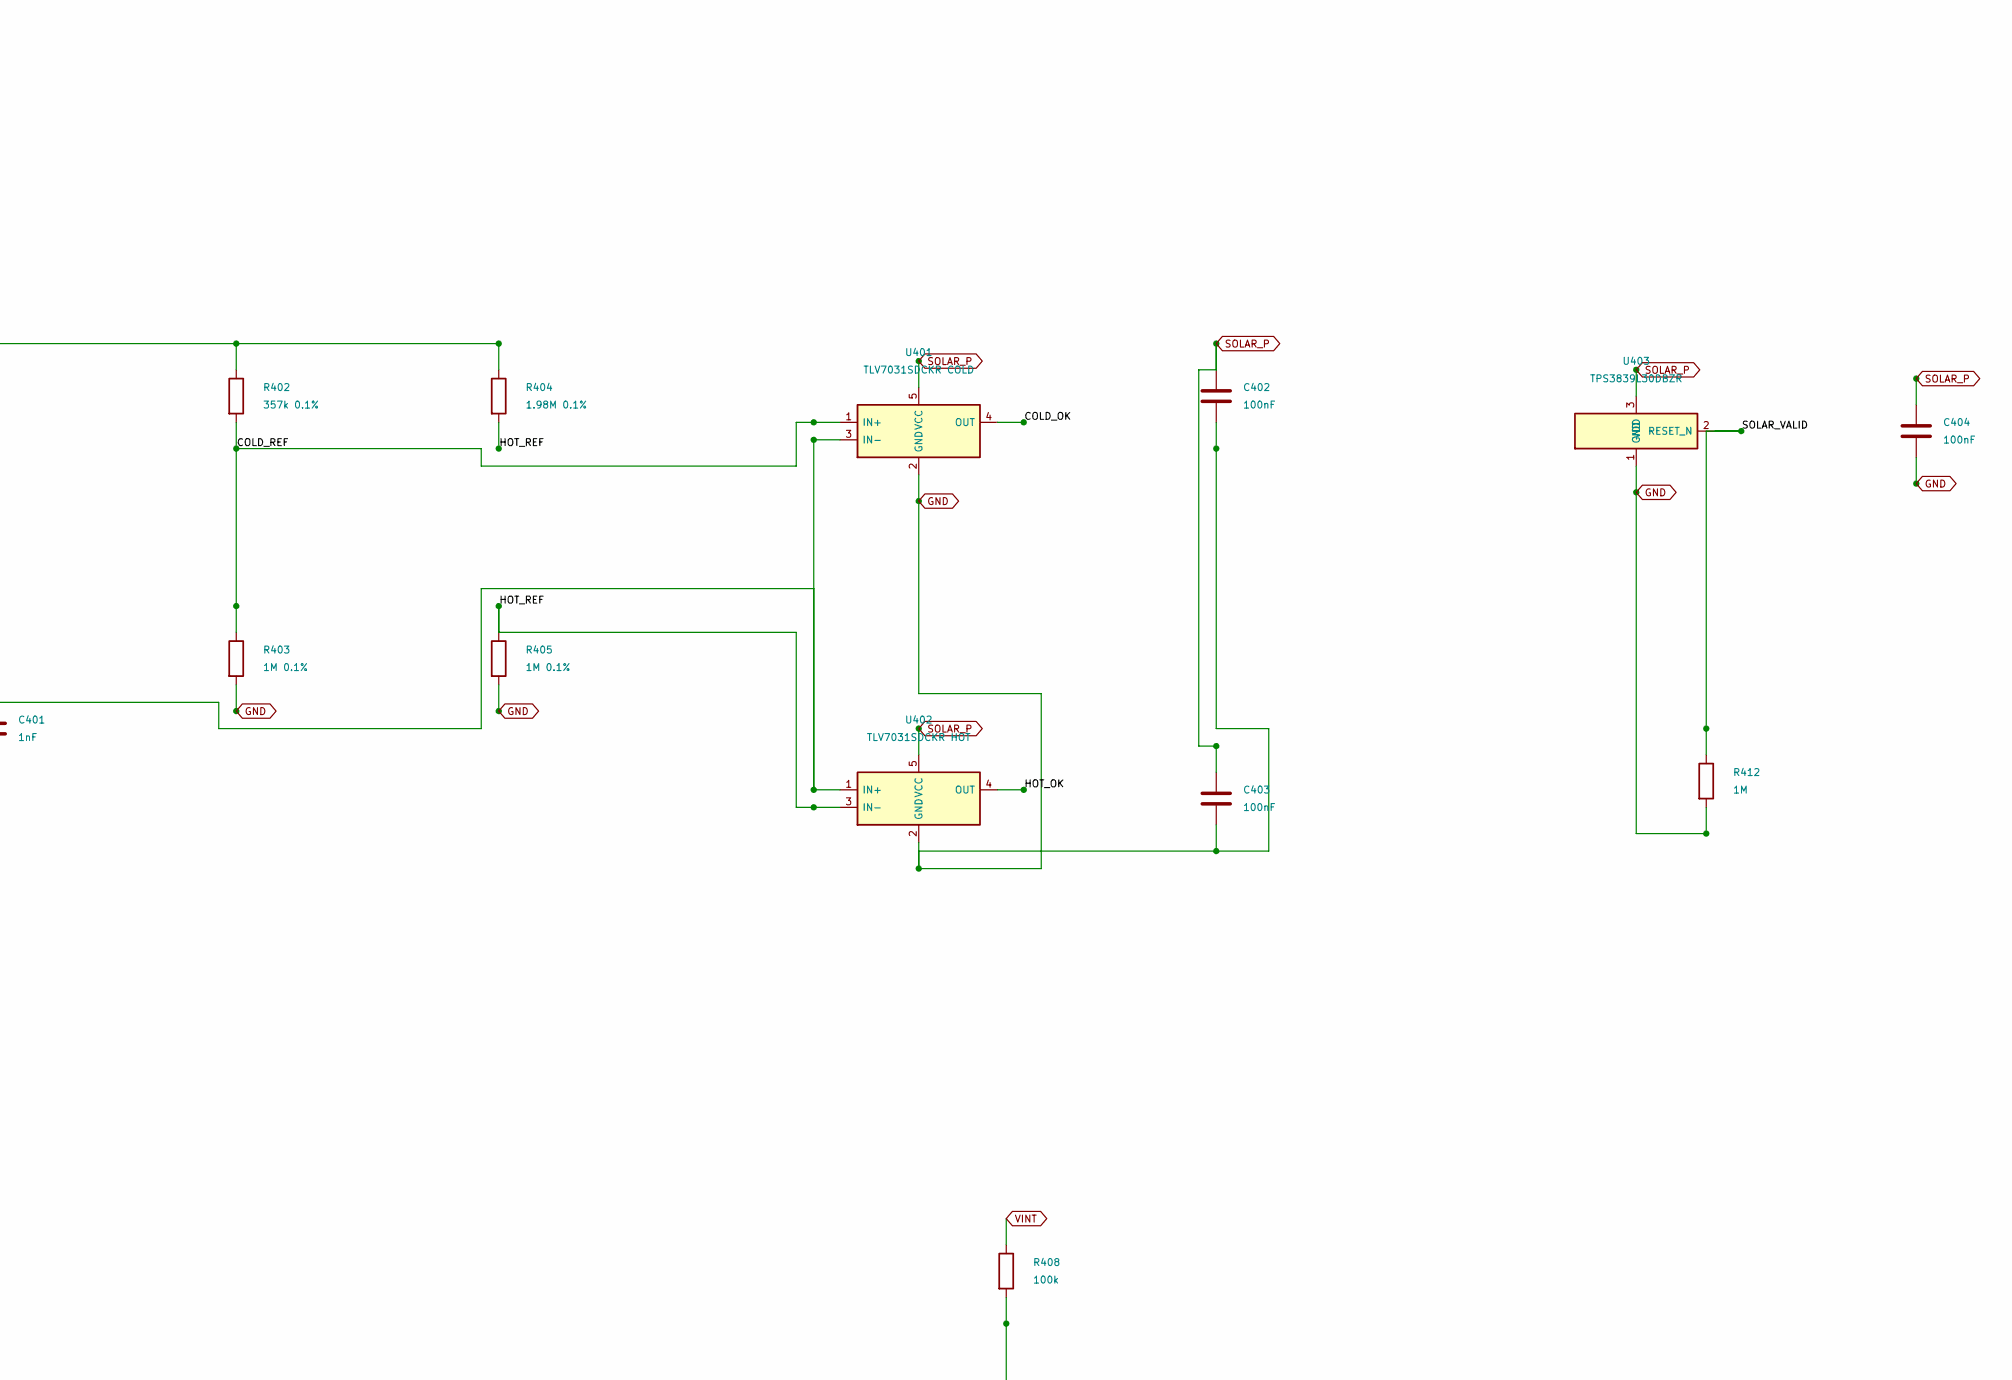
[picture p28: schematic battery.kicad_sch, Battery protection, temperature and optional gauge, part in row 1, column 2]

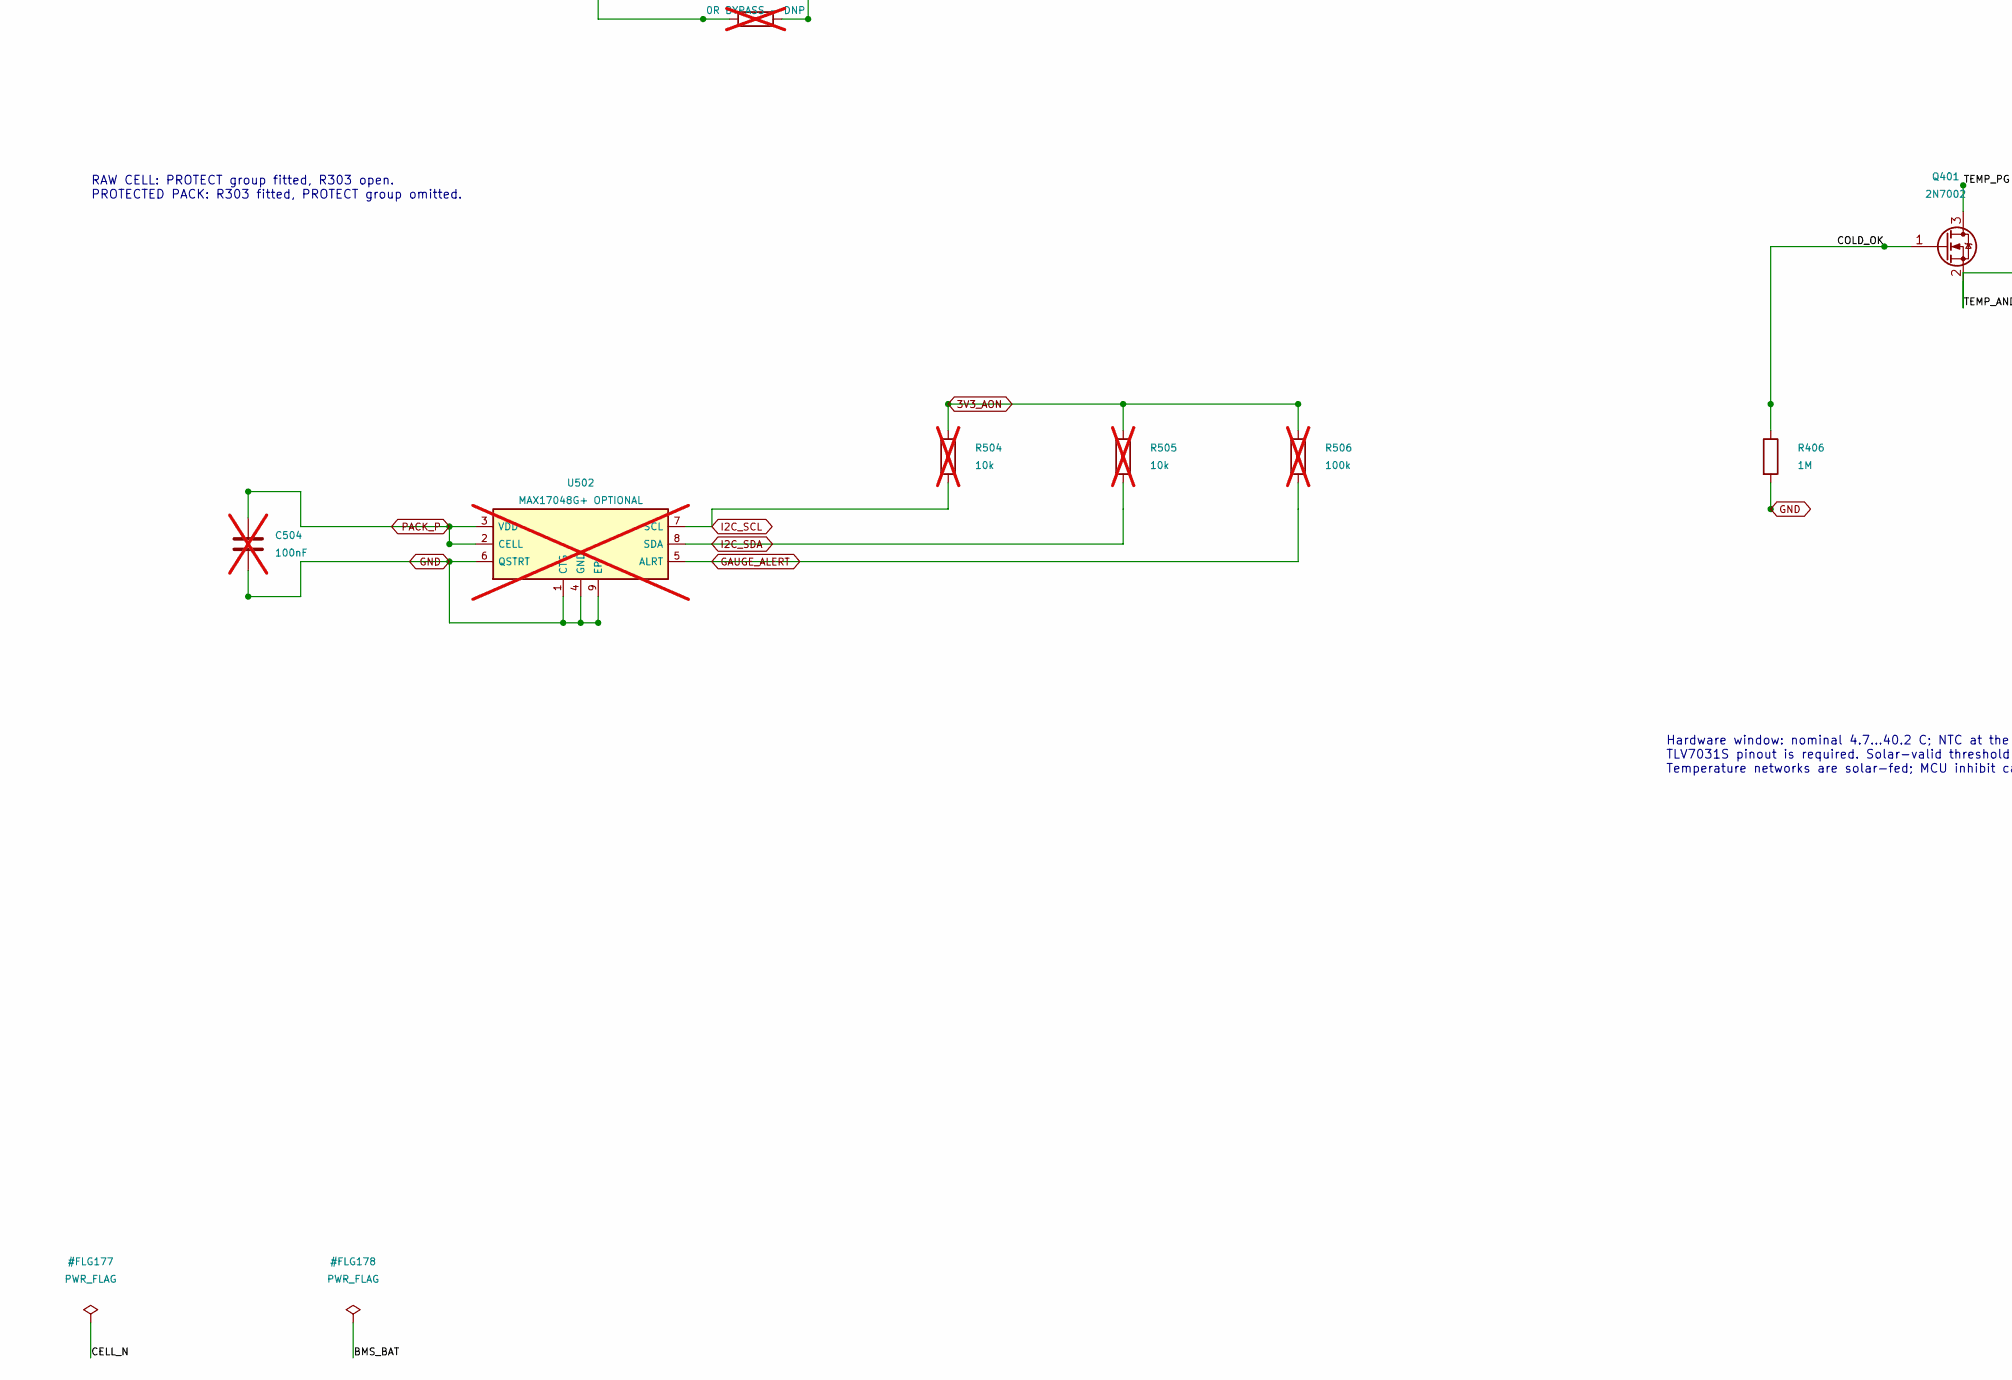
[picture p29: schematic battery.kicad_sch, Battery protection, temperature and optional gauge, part in row 2, column 1]

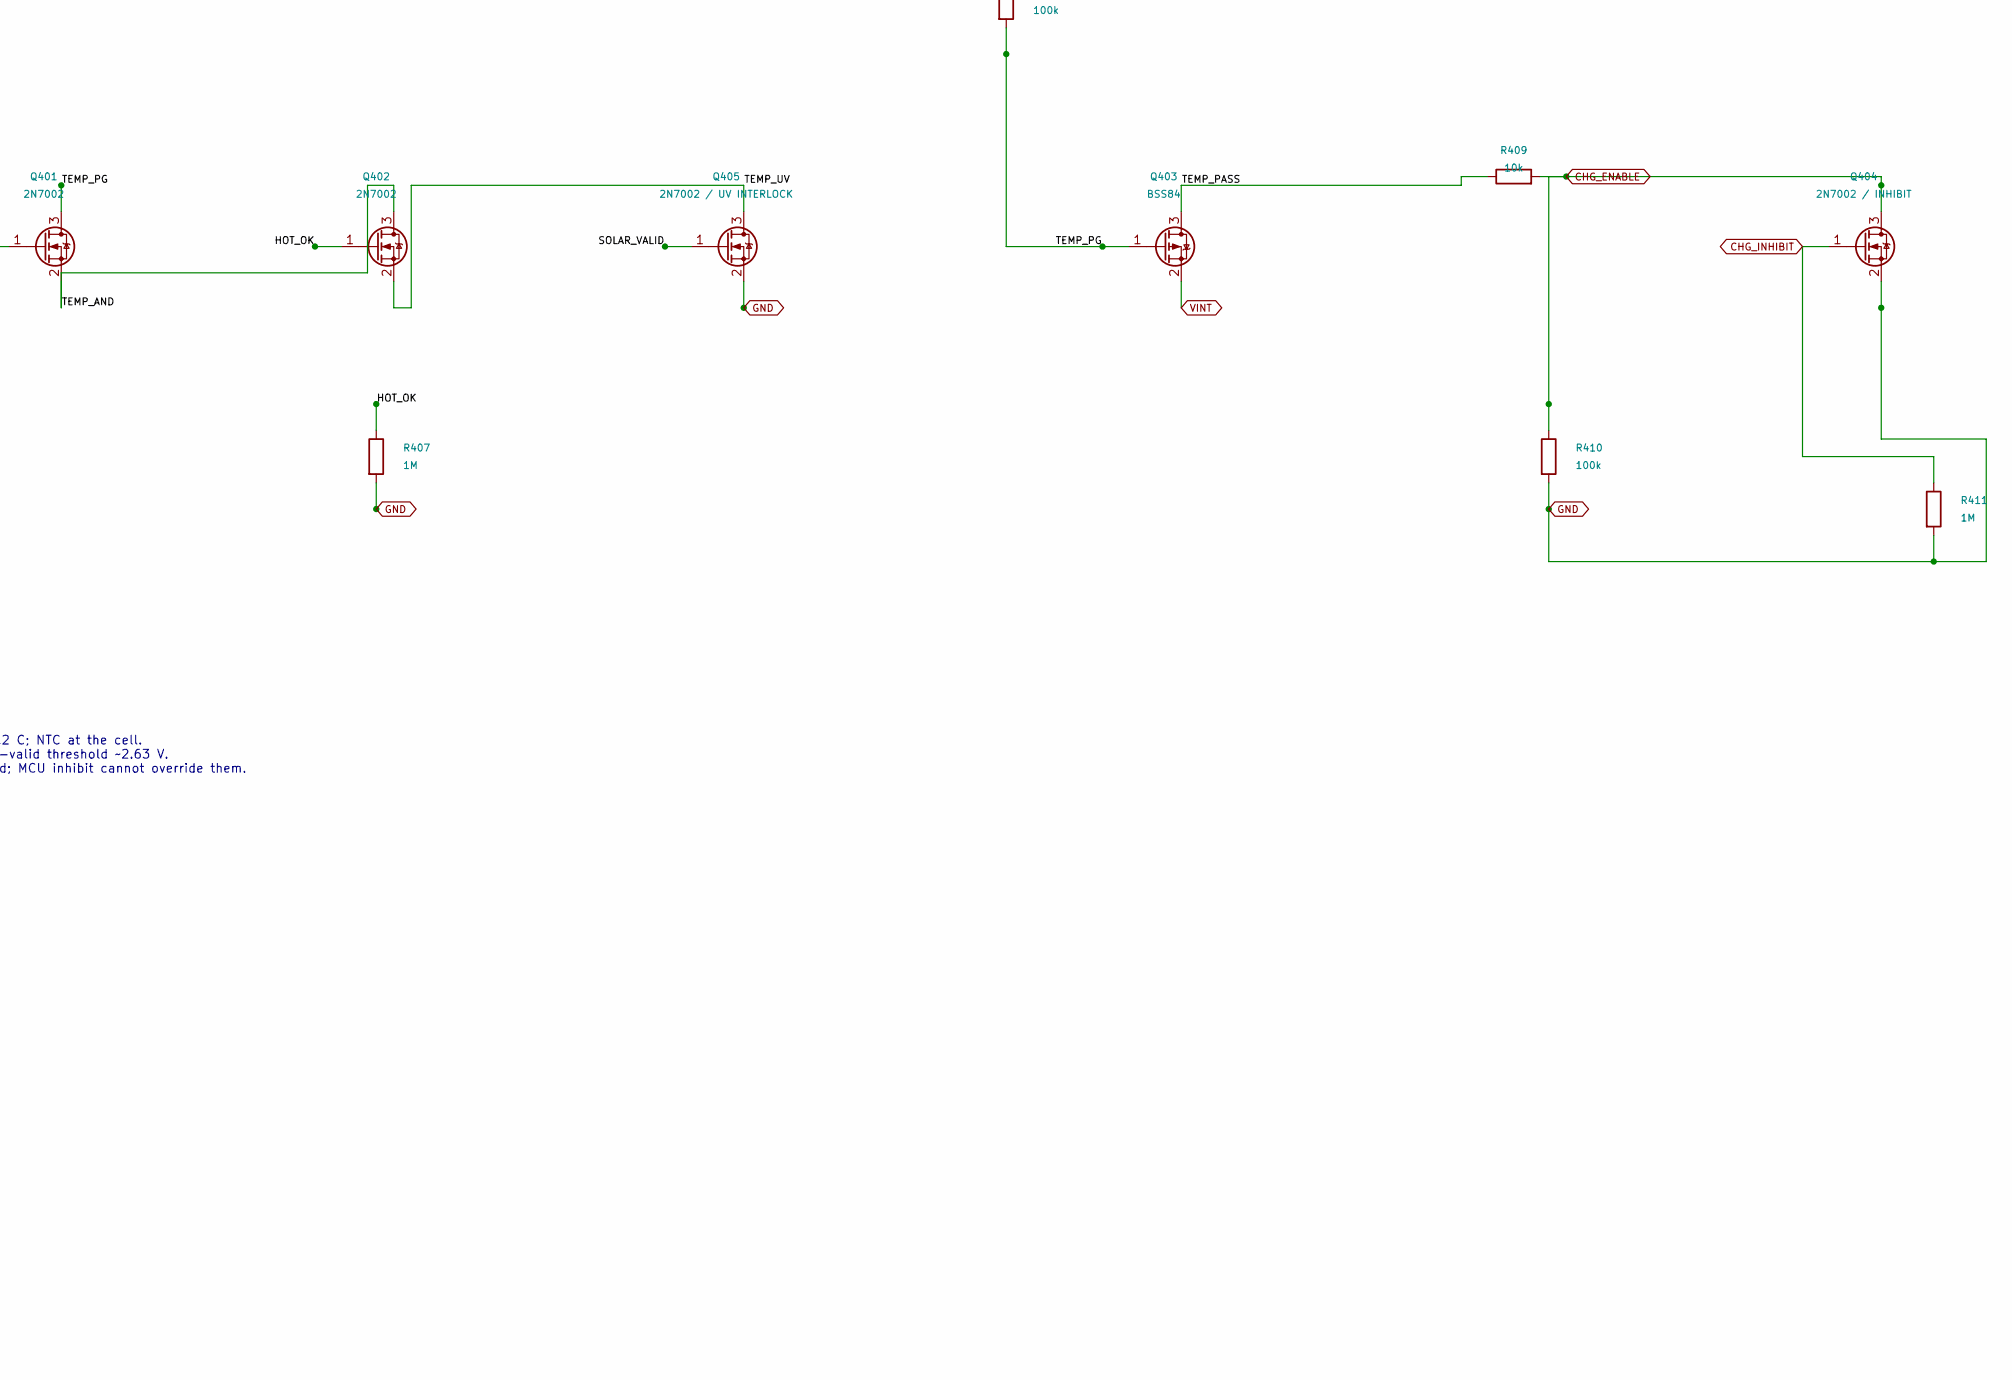
[picture p30: schematic battery.kicad_sch, Battery protection, temperature and optional gauge, part in row 2, column 2]

Parts:
C301, C402, C403, C404: 100nF; C0603; MPN 100nF
C401: 1nF; C0603; MPN 1nF
C504: 100nF; C0603; MPN 100nF; not fitted
J301: BAT + / CELL-; JST_PH_2; MPN B2B-PH-K-S(LF)(SN)
J401: 100k NTC AT CELL; Header1x2; MPN External NTC NCP18WF104F12RB mounted on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
Q301: AO3400A / DSG; SOT23; MPN AO3400A
Q302: AO3400A / CHG; SOT23; MPN AO3400A
Q401, Q402: 2N7002; SOT23; MPN 2N7002
Q403: BSS84; SOT23; MPN BSS84
Q404: 2N7002 / INHIBIT; SOT23; MPN 2N7002 / INHIBIT
Q405: 2N7002 / UV INTERLOCK; SOT23; MPN 2N7002 / UV INTERLOCK
R301: 330R; R0603; MPN 330R
R302: 2.2k; R0603; MPN 2.2k
R303: 0R BYPASS - DNP; R1206; MPN 0R BYPASS - DNP; not fitted
R401: 100k 0.1%; R0603; MPN 100k 0.1%
R402: 357k 0.1%; R0603; MPN 357k 0.1%
R403, R405: 1M 0.1%; R0603; MPN 1M 0.1%
R404: 1.98M 0.1%; R0603; MPN 1.98M 0.1%
R406, R407, R411, R412: 1M; R0603; MPN 1M
R408, R410: 100k; R0603; MPN 100k
R409: 10k; R0603; MPN 10k
R504, R505: 10k; R0603; MPN 10k; not fitted
R506: 100k; R0603; MPN 100k; not fitted
TP301: PACK_P; TestPad; MPN PACK_P
TP302: GND; TestPad; MPN GND
U301: BQ29700DSET; BQ29700_WSON6; MPN BQ29700DSET
U401: TLV7031SDCKR COLD; SC70_5; MPN TLV7031SDCKR COLD
U402: TLV7031SDCKR HOT; SC70_5; MPN TLV7031SDCKR HOT
U403: TPS3839L30DBZR; SOT23; MPN TPS3839L30DBZR
U502: MAX17048G+ OPTIONAL; MAX17048_TDFN8; MPN MAX17048G+; not fitted

Connections:
3V3_AON: R504.1, R505.1, R506.1; also elsewhere on the board
/Battery protection, temperature and optional gauge/BMS_BAT: C301.1, R301.2, U301.5 (BAT)
/Battery protection, temperature and optional gauge/BMS_VM: R302.1, U301.6 (V-)
/Battery protection, temperature and optional gauge/CELL_N: C301.2, J301.2, Q301.2 (S), R303.1, U301.4 (VSS_CELL)
/Battery protection, temperature and optional gauge/CHG_GATE: Q302.1 (G), U301.2 (COUT)
/Battery protection, temperature and optional gauge/COLD_OK: Q401.1 (G), R406.1, U401.4 (OUT)
/Battery protection, temperature and optional gauge/COLD_REF: R402.2, R403.1, U401.1 (IN+)
/Battery protection, temperature and optional gauge/DSG_GATE: Q301.1 (G), U301.3 (DOUT)
/Battery protection, temperature and optional gauge/FET_MID: Q301.3 (D), Q302.3 (D)
/Battery protection, temperature and optional gauge/HOT_OK: Q402.1 (G), R407.1, U402.4 (OUT)
/Battery protection, temperature and optional gauge/HOT_REF: R404.2, R405.1, U402.3 (IN-)
/Battery protection, temperature and optional gauge/NTC_SENSE: C401.1, J401.1, R401.2, U401.3 (IN-), U402.1 (IN+)
/Battery protection, temperature and optional gauge/SOLAR_VALID: Q405.1 (G), R401.1, R402.1, R404.1, R412.1, U403.2 (RESET_N)
/Battery protection, temperature and optional gauge/TEMP_AND: Q401.2 (S), Q402.3 (D)
/Battery protection, temperature and optional gauge/TEMP_PASS: Q403.3 (D), R409.1
/Battery protection, temperature and optional gauge/TEMP_PG: Q401.3 (D), Q403.1 (G), R408.2
/Battery protection, temperature and optional gauge/TEMP_UV: Q402.2 (S), Q405.3 (D)
CHG_ENABLE: Q404.3 (D), R409.2, R410.1; also elsewhere on the board
CHG_INHIBIT: Q404.1 (G), R411.1; also elsewhere on the board
GAUGE_ALERT: R506.2, U502.5 (ALRT); also elsewhere on the board
GND: C401.2, C402.2, C403.2, C404.2, C504.2, J401.2, Q302.2 (S), Q404.2 (S), Q405.2 (S), R302.2, R303.2, R403.2, R405.2, R406.2, R407.2, R410.2, R411.2, R412.2, TP302.1, U401.2 (GND), U402.2 (GND), U403.1 (GND), U502.1 (CTG), U502.4 (GND), U502.6 (QSTRT), U502.9 (EP); also elsewhere on the board
I2C_SCL: R504.2, U502.7 (SCL); also elsewhere on the board
I2C_SDA: R505.2, U502.8 (SDA); also elsewhere on the board
PACK_P: C504.1, J301.1, R301.1, TP301.1, U502.2 (CELL), U502.3 (VDD); also elsewhere on the board
SOLAR_P: C402.1, C403.1, C404.1, U401.5 (VCC), U402.5 (VCC), U403.3 (VDD); also elsewhere on the board
VINT: Q403.2 (S), R408.1; also elsewhere on the board

Notes on the sheet:
Battery protection, temperature and optional gauge
CELL_N is cell-side only. All chargers, loads and debug grounds connect to PACK- / GND.
RAW CELL: PROTECT group fitted, R303 open. PROTECTED PACK: R303 fitted, PROTECT group omitted.
Hardware window: nominal 4.7...40.2 C; NTC at the cell. TLV7031S pinout is required. Solar-valid threshold ~2.63 V. Temperature networks are solar-fed; MCU inhibit cannot override them.
