Liftyee/multum-in-parvo/hardware/mesh-node.kicad_pcb

## KiCad design hardware/mesh-node.kicad_pcb (continued)

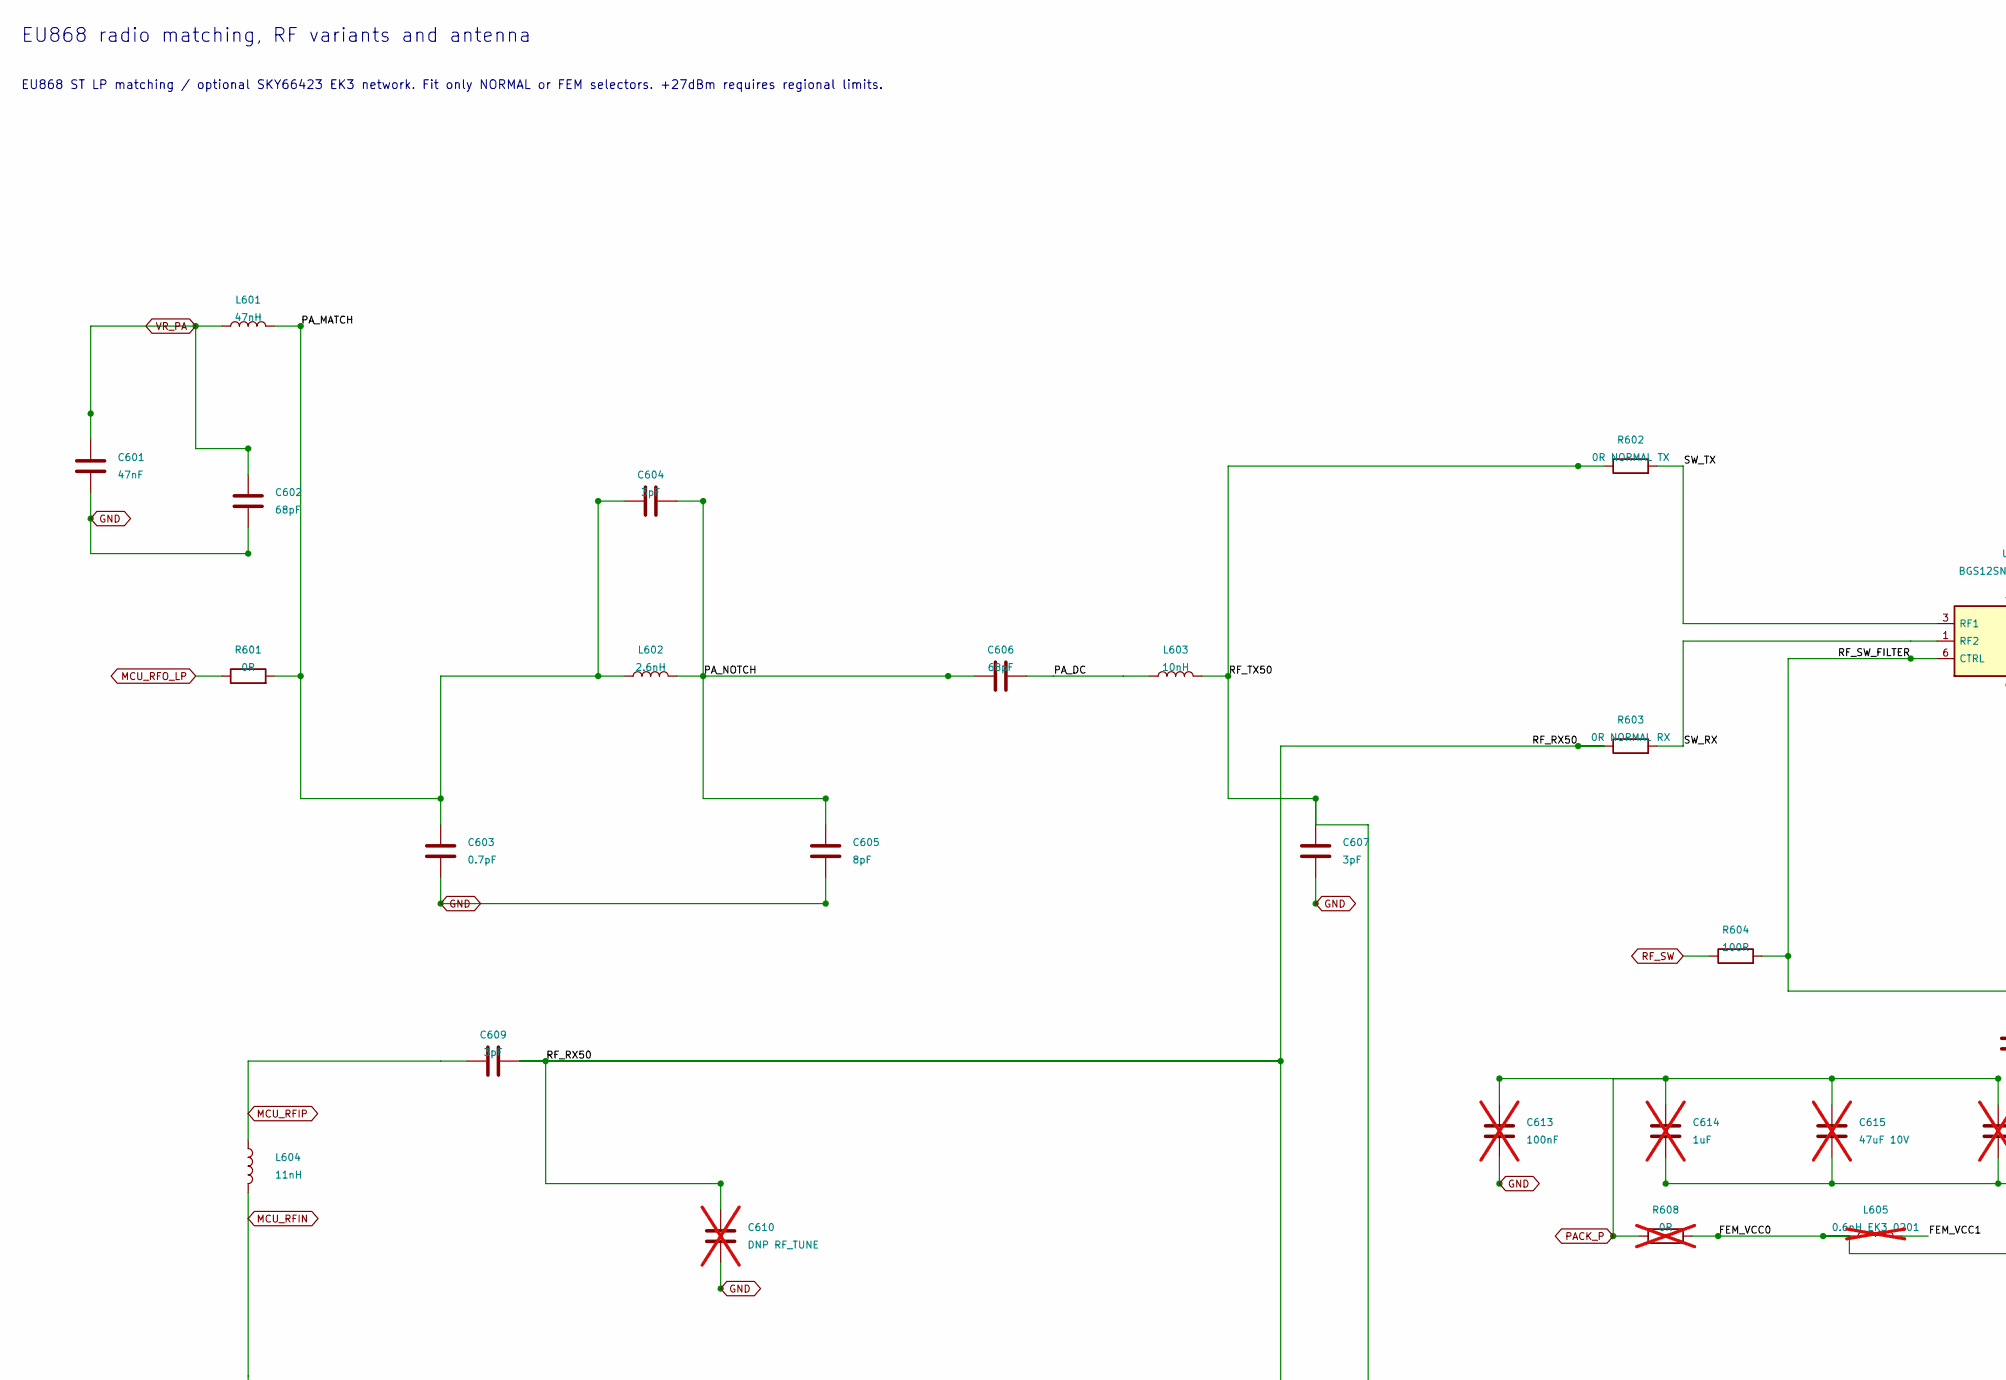
[picture p31: schematic radio.kicad_sch, EU868 radio matching, RF variants and antenna, part in row 1, column 1]

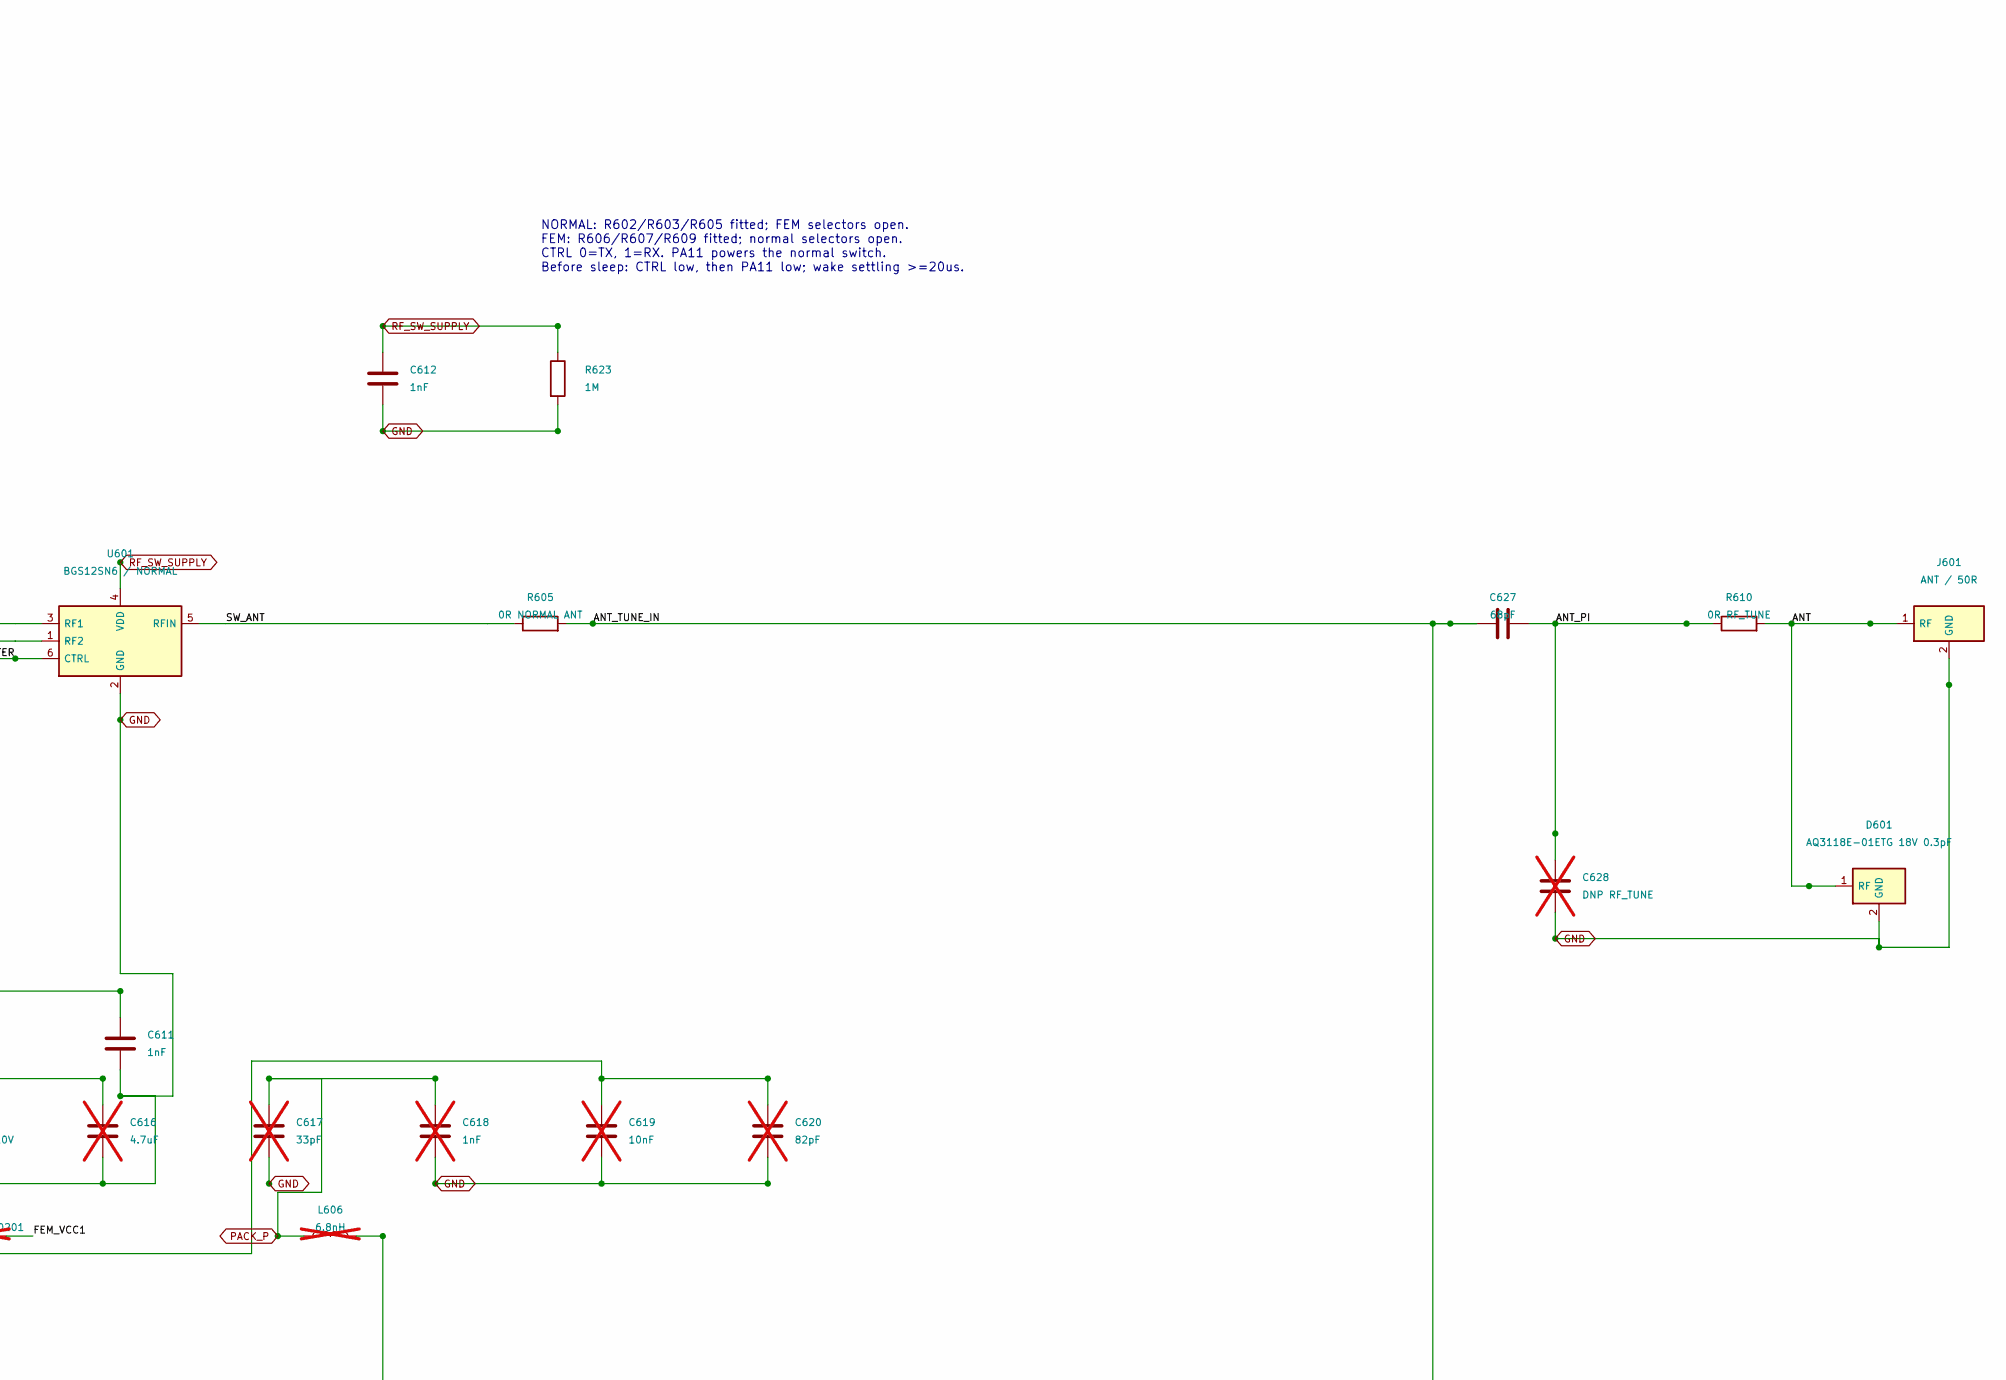
[picture p32: schematic radio.kicad_sch, EU868 radio matching, RF variants and antenna, part in row 1, column 2]

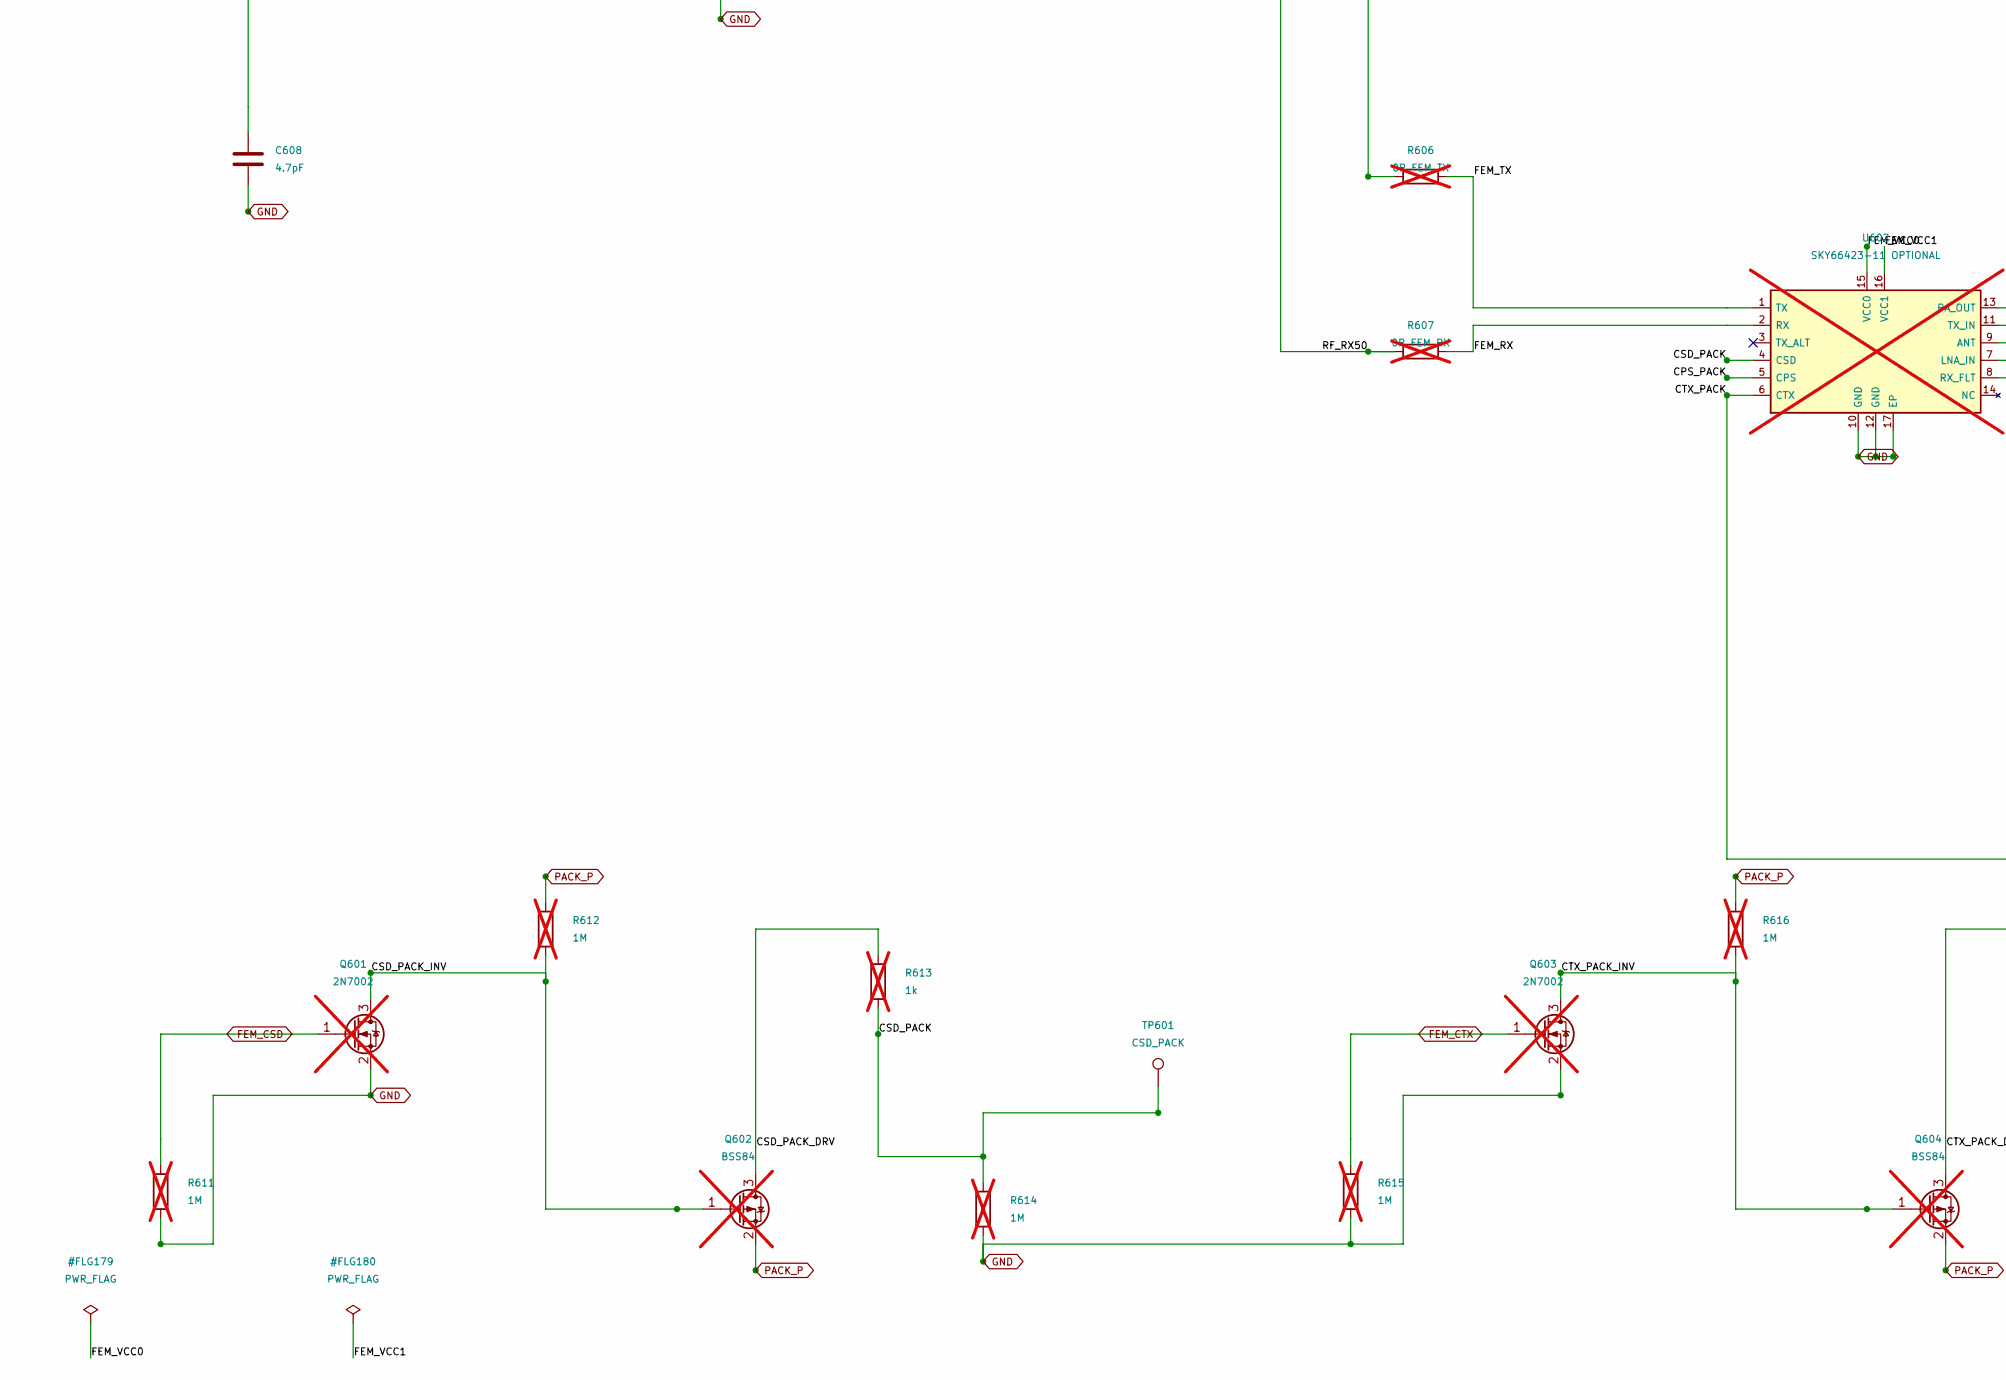
[picture p33: schematic radio.kicad_sch, EU868 radio matching, RF variants and antenna, part in row 2, column 1]

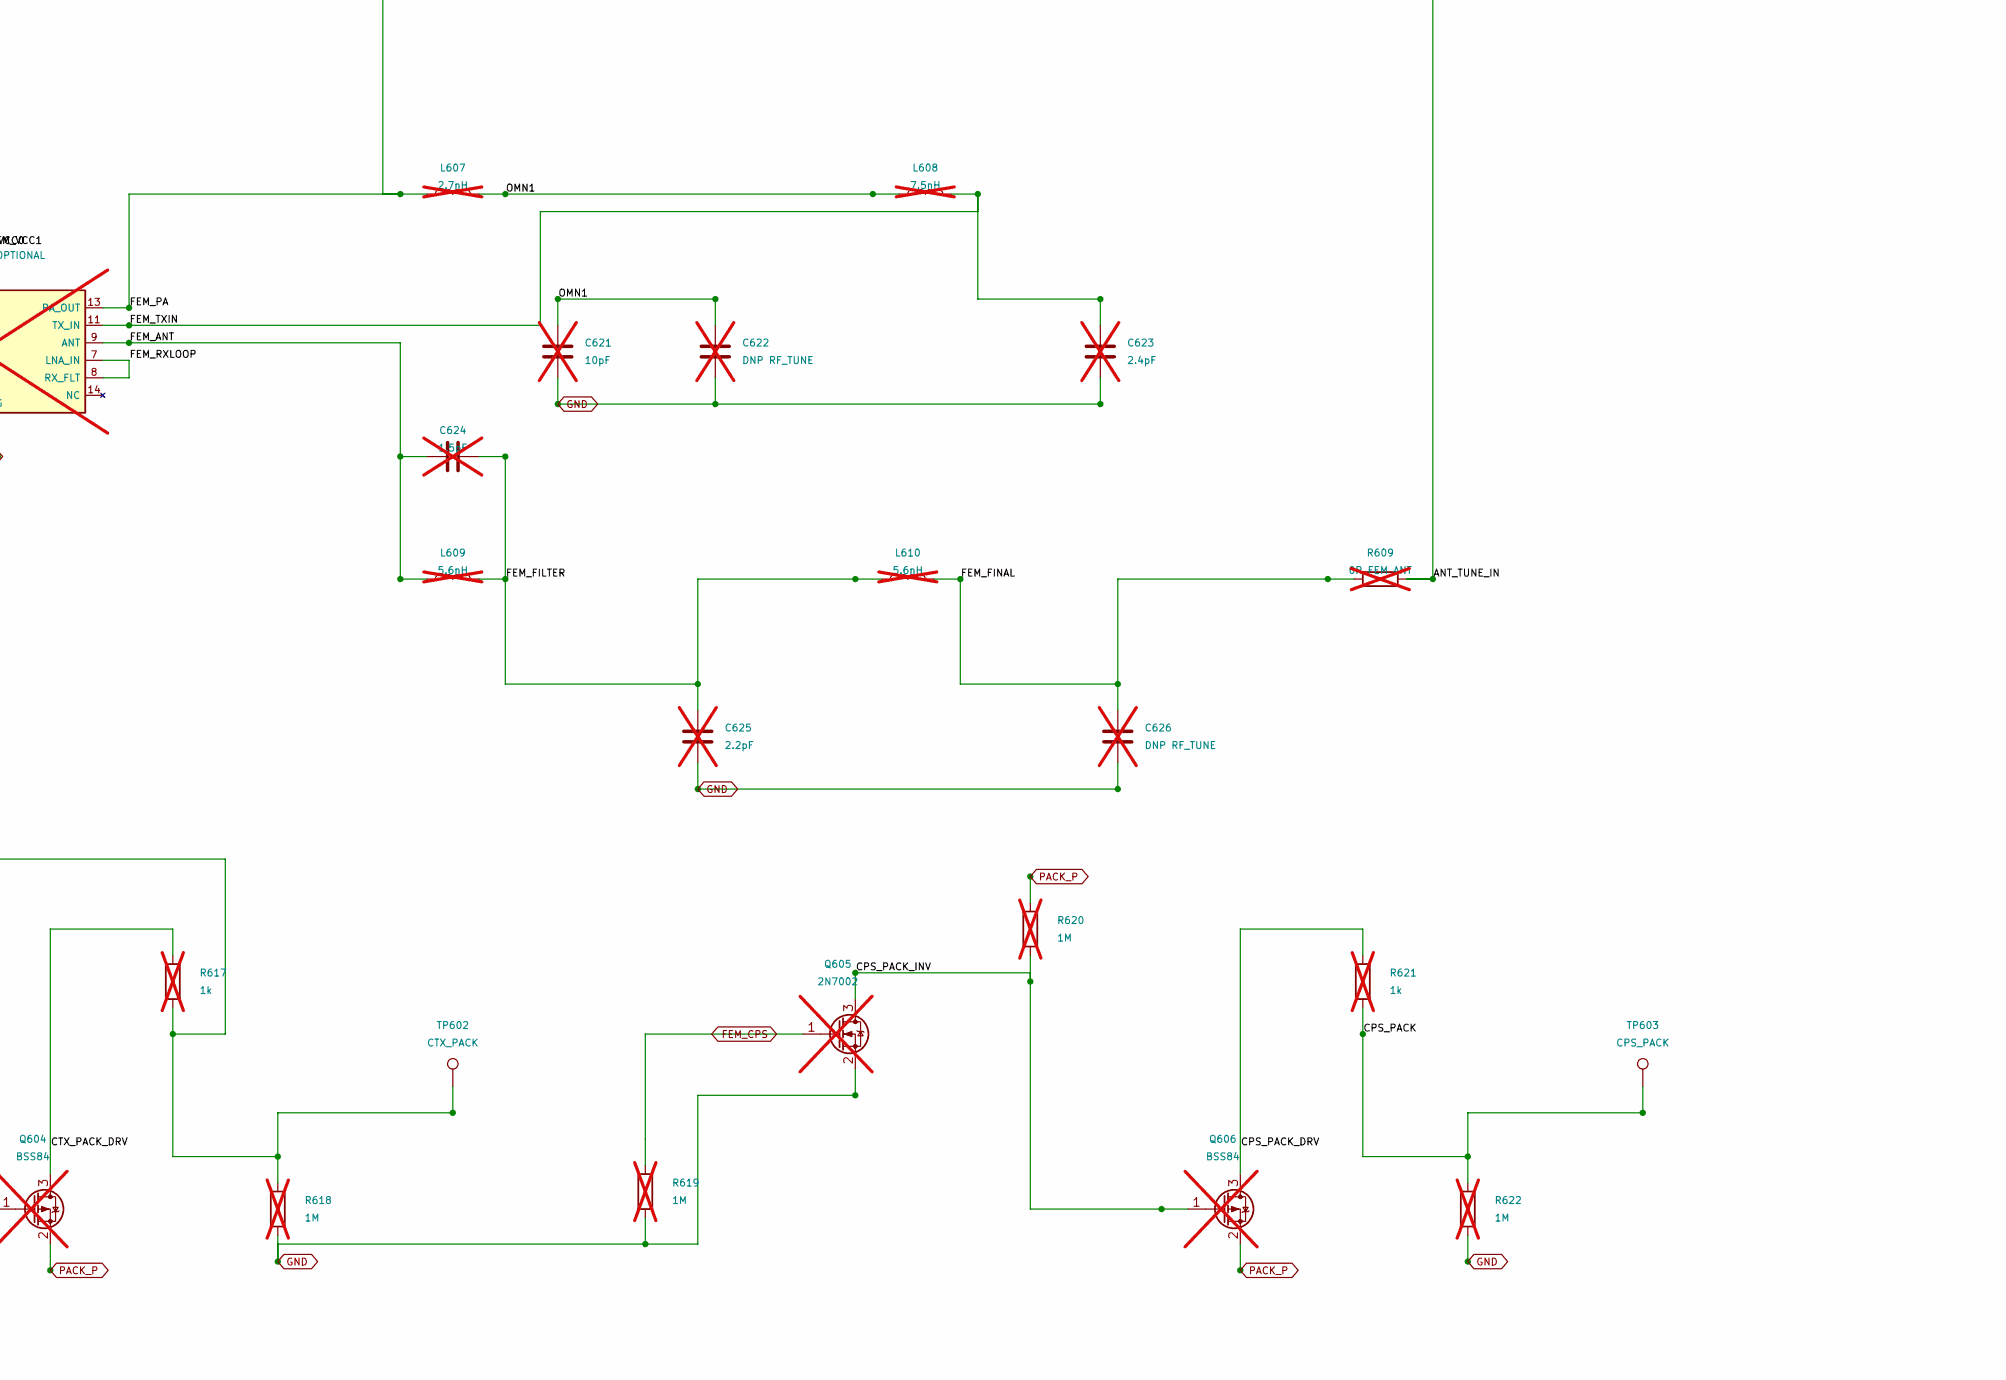
[picture p34: schematic radio.kicad_sch, EU868 radio matching, RF variants and antenna, part in row 2, column 2]

Parts:
C601: 47nF; C0402; MPN 47nF
C602, C606, C627: 68pF; C0402; MPN 68pF
C603: 0.7pF; C0402; MPN 0.7pF
C604, C607, C609: 3pF; C0402; MPN 3pF
C605: 8pF; C0402; MPN 8pF
C608: 4.7pF; C0402; MPN 4.7pF
C610, C622, C626, C628: DNP RF_TUNE; C0402; MPN DNP RF_TUNE; not fitted
C611, C612: 1nF; C0402; MPN 1nF
C613: 100nF; C0402; MPN 100nF; not fitted
C614: 1uF; C0402; MPN 1uF; not fitted
C615: 47uF 10V; C0805; MPN 47uF 10V; not fitted
C616: 4.7uF; C0402; MPN 4.7uF; not fitted
C617: 33pF; C0402; MPN 33pF; not fitted
C618: 1nF; C0402; MPN 1nF; not fitted
C619: 10nF; C0402; MPN 10nF; not fitted
C620: 82pF; C0402; MPN 82pF; not fitted
C621: 10pF; C0402; MPN 10pF; not fitted
C623: 2.4pF; C0402; MPN 2.4pF; not fitted
C624: 1.5pF; C0402; MPN 1.5pF; not fitted
C625: 2.2pF; C0402; MPN 2.2pF; not fitted
D601: AQ3118E-01ETG 18V 0.3pF; ESD0402; MPN AQ3118E-01ETG
J601: ANT / 50R; UFL; MPN U.FL-R-SMT-1(10)
L601: 47nH; L0402; MPN 47nH
L602: 2.6nH; L0402; MPN 2.6nH
L603: 10nH; L0402; MPN 10nH
L604: 11nH; L0402; MPN 11nH
L605: 0.6nH EK3 0201; L0201; MPN LQP03TN0N6B02D; not fitted
L606: 6.8nH; L0402; MPN 6.8nH; not fitted
L607: 2.7nH; L0402; MPN 2.7nH; not fitted
L608: 7.5nH; L0402; MPN 7.5nH; not fitted
L609, L610: 5.6nH; L0402; MPN 5.6nH; not fitted
Q601, Q603, Q605: 2N7002; SOT23; MPN 2N7002; not fitted
Q602, Q604, Q606: BSS84; SOT23; MPN BSS84; not fitted
R601: 0R; R0402; MPN 0R
R602: 0R NORMAL TX; R0402; MPN 0R NORMAL TX
R603: 0R NORMAL RX; R0402; MPN 0R NORMAL RX
R604: 100R; R0603; MPN 100R
R605: 0R NORMAL ANT; R0402; MPN 0R NORMAL ANT
R606: 0R FEM TX; R0402; MPN 0R FEM TX; not fitted
R607: 0R FEM RX; R0402; MPN 0R FEM RX; not fitted
R608: 0R; R0805; MPN 0R; not fitted
R609: 0R FEM ANT; R0402; MPN 0R FEM ANT; not fitted
R610: 0R RF_TUNE; R0402; MPN 0R RF_TUNE
R611, R612, R614, R615, R616, R618, R619, R620, R622: 1M; R0603; MPN 1M; not fitted
R613, R617, R621: 1k; R0603; MPN 1k; not fitted
R623: 1M; R0603; MPN 1M
TP601: CSD_PACK; TestPad; MPN CSD_PACK
TP602: CTX_PACK; TestPad; MPN CTX_PACK
TP603: CPS_PACK; TestPad; MPN CPS_PACK
U601: BGS12SN6 / NORMAL; BGS12SN6; MPN BGS12SN6 / NORMAL
U602: SKY66423-11 OPTIONAL; SKY66423_MCM16; MPN SKY66423-11 OPTIONAL; not fitted

Connections:
/EU868 radio matching, RF variants and antenna/ANT: D601.1 (RF), J601.1 (RF), R610.2
/EU868 radio matching, RF variants and antenna/ANT_PI: C627.2, C628.1, R610.1
/EU868 radio matching, RF variants and antenna/ANT_TUNE_IN: C627.1, R605.2, R609.2
/EU868 radio matching, RF variants and antenna/CPS_PACK: R621.2, R622.1, TP603.1, U602.5 (CPS)
/EU868 radio matching, RF variants and antenna/CPS_PACK_DRV: Q606.3 (D), R621.1
/EU868 radio matching, RF variants and antenna/CPS_PACK_INV: Q605.3 (D), Q606.1 (G), R620.2
/EU868 radio matching, RF variants and antenna/CSD_PACK: R613.2, R614.1, TP601.1, U602.4 (CSD)
/EU868 radio matching, RF variants and antenna/CSD_PACK_DRV: Q602.3 (D), R613.1
/EU868 radio matching, RF variants and antenna/CSD_PACK_INV: Q601.3 (D), Q602.1 (G), R612.2
/EU868 radio matching, RF variants and antenna/CTX_PACK: R617.2, R618.1, TP602.1, U602.6 (CTX)
/EU868 radio matching, RF variants and antenna/CTX_PACK_DRV: Q604.3 (D), R617.1
/EU868 radio matching, RF variants and antenna/CTX_PACK_INV: Q603.3 (D), Q604.1 (G), R616.2
/EU868 radio matching, RF variants and antenna/FEM_ANT: C624.1, L609.1, U602.9 (ANT)
/EU868 radio matching, RF variants and antenna/FEM_FILTER: C624.2, C625.1, L609.2, L610.1
/EU868 radio matching, RF variants and antenna/FEM_FINAL: C626.1, L610.2, R609.1
/EU868 radio matching, RF variants and antenna/FEM_PA: L606.2, L607.1, U602.13 (PA_OUT)
/EU868 radio matching, RF variants and antenna/FEM_RX: R607.2, U602.2 (RX)
/EU868 radio matching, RF variants and antenna/FEM_RXLOOP: U602.7 (LNA_IN), U602.8 (RX_FLT)
/EU868 radio matching, RF variants and antenna/FEM_TX: R606.2, U602.1 (TX)
/EU868 radio matching, RF variants and antenna/FEM_TXIN: C623.1, L608.2, U602.11 (TX_IN)
/EU868 radio matching, RF variants and antenna/FEM_VCC0: C619.1, C620.1, L605.1, R608.2, U602.15 (VCC0)
/EU868 radio matching, RF variants and antenna/FEM_VCC1: L605.2, U602.16 (VCC1)
/EU868 radio matching, RF variants and antenna/OMN1: C621.1, C622.1, L607.2, L608.1
/EU868 radio matching, RF variants and antenna/PA_DC: C606.2, L603.1
/EU868 radio matching, RF variants and antenna/PA_MATCH: C603.1, C604.1, L601.2, L602.1, R601.2
/EU868 radio matching, RF variants and antenna/PA_NOTCH: C604.2, C605.1, C606.1, L602.2
/EU868 radio matching, RF variants and antenna/RF_RX50: C609.2, C610.1, R603.1, R607.1
/EU868 radio matching, RF variants and antenna/RF_SW_FILTER: C611.1, R604.2, U601.6 (CTRL)
/EU868 radio matching, RF variants and antenna/RF_TX50: C607.1, L603.2, R602.1, R606.1
/EU868 radio matching, RF variants and antenna/SW_ANT: R605.1, U601.5 (RFIN)
/EU868 radio matching, RF variants and antenna/SW_RX: R603.2, U601.1 (RF2)
/EU868 radio matching, RF variants and antenna/SW_TX: R602.2, U601.3 (RF1)
FEM_CPS: Q605.1 (G), R619.1; also elsewhere on the board
FEM_CSD: Q601.1 (G), R611.1; also elsewhere on the board
FEM_CTX: Q603.1 (G), R615.1; also elsewhere on the board
GND: C601.2, C602.2, C603.2, C605.2, C607.2, C608.2, C610.2, C611.2, C612.2, C613.2, C614.2, C615.2, C616.2, C617.2, C618.2, C619.2, C620.2, C621.2, C622.2, C623.2, C625.2, C626.2, C628.2, D601.2 (GND), J601.2 (GND), Q601.2 (S), Q603.2 (S), Q605.2 (S), R611.2, R614.2, R615.2, R618.2, R619.2, R622.2, R623.2, U601.2 (GND), U602.10 (GND), U602.12 (GND), U602.17 (EP); also elsewhere on the board
MCU_RFIN: C608.1, L604.2; also elsewhere on the board
MCU_RFIP: C609.1, L604.1; also elsewhere on the board
MCU_RFO_LP: R601.1; also elsewhere on the board
PACK_P: C613.1, C614.1, C615.1, C616.1, C617.1, C618.1, L606.1, Q602.2 (S), Q604.2 (S), Q606.2 (S), R608.1, R612.1, R616.1, R620.1; also elsewhere on the board
RF_SW: R604.1; also elsewhere on the board
RF_SW_SUPPLY: C612.1, R623.1, U601.4 (VDD); also elsewhere on the board
VR_PA: C601.1, C602.1, L601.1; also elsewhere on the board

Notes on the sheet:
EU868 radio matching, RF variants and antenna
EU868 ST LP matching / optional SKY66423 EK3 network. Fit only NORMAL or FEM selectors. +27dBm requires regional limits.
NORMAL: R602/R603/R605 fitted; FEM selectors open. FEM: R606/R607/R609 fitted; normal selectors open. CTRL 0=TX, 1=RX. PA11 powers the normal switch. Before sleep: CTRL low, then PA11 low; wake settling >=20us.

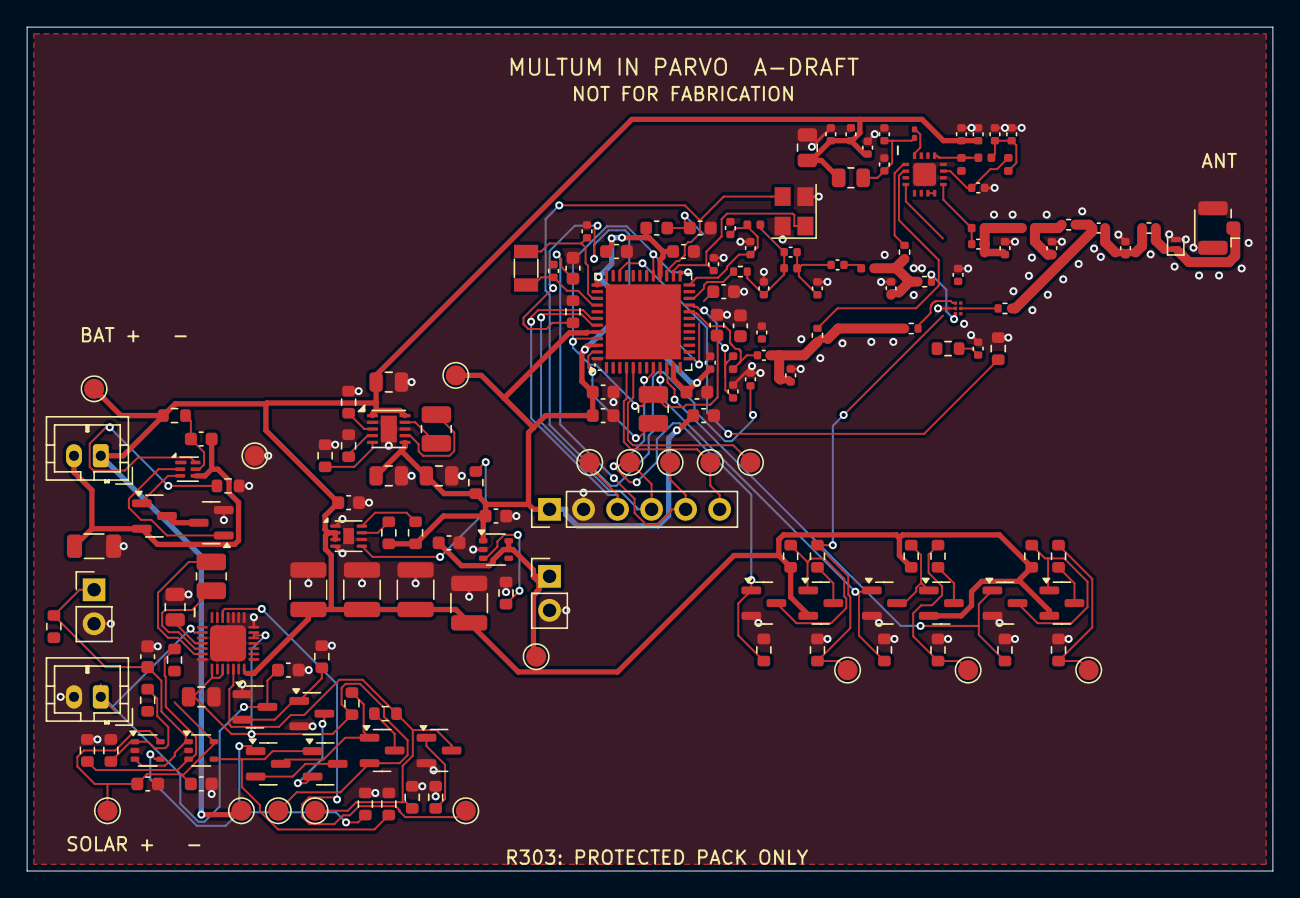
[picture p35: board hardware/mesh-node.kicad_pcb from above]

Board: 2 copper layers, 93.0 x 63.0 mm, 172 parts (0 on the bottom side), 91 nets.
