Liftyee/multum-in-parvo/hardware/tools/radio.py

rf=Page('06-radio','EU868 RF matching, normal switch and optional FEM')
box(rf,15,15,'LP output only / ST MB1720 high-band low-power starting values','RFO_HP is not connected. Firmware must select LP PA and limit FEM input to safe level.\nNormal: NORM parts fitted, FEM parts DNP. High performance: reverse these groups.\n+27 dBm is NOT universally permitted in EU868; enforce regional ERP/EIRP and duty-cycle limits.')
# ST PA choke, parallel LC notch, DC cut and low-pass.
comp(rf,'L601','47nH','VR_PA','PA_MATCH',40.64,66.04,[59,22,0],fp=LFP)
comp(rf,'C601','47nF','VR_PA','GND',20.32,81.28,[57.5,22,90],rot=0,fp=CFP)
comp(rf,'C602','68pF','VR_PA','GND',40.64,91.44,[59,23.5,90],rot=0,fp=CFP)
comp(rf,'R601','0R','MCU_RFO_LP','PA_MATCH',40.64,119.38,[58.5,25,0],fp=RFP)
comp(rf,'C603','0.7pF','PA_MATCH','GND',60.96,139.7,[60,26.5,90],rot=0,fp=CFP)
comp(rf,'L602','2.6nH','PA_MATCH','PA_NOTCH',83.82,119.38,[62,25,0],fp=LFP)
comp(rf,'C604','3pF','PA_MATCH','PA_NOTCH',83.82,91.44,[62,23.8,0],fp=CFP)
comp(rf,'C605','8pF','PA_NOTCH','GND',106.68,139.7,[64,26.5,90],rot=0,fp=CFP)
comp(rf,'C606','68pF','PA_NOTCH','PA_DC',129.54,119.38,[65.5,25,0],fp=CFP)
comp(rf,'L603','10nH','PA_DC','RF_TX50',162.56,119.38,[68,25,0],fp=LFP)
comp(rf,'C607','3pF','RF_TX50','GND',182.88,139.7,[69.5,26.5,90],rot=0,fp=CFP)
# Receive balun exactly ST's network.
comp(rf,'L604','11nH','MCU_RFIP','MCU_RFIN',40.64,187.96,[57.7,32.3,90],rot=0,fp=LFP)
comp(rf,'C608','4.7pF','MCU_RFIN','GND',40.64,226.06,[57.7,34.2,90],rot=0,fp=CFP)
comp(rf,'C609','3pF','MCU_RFIP','RF_RX50',78.74,172.72,[60,31.5,0],fp=CFP)
comp(rf,'C610','DNP RF_TUNE','RF_RX50','GND',109.22,193.04,[62,33,90],rot=0,fp=CFP,dnp=True,group='TUNE')
# Separate paths selected at both ends; no unisolated long bypass stub.
comp(rf,'R602','0R NORMAL TX','RF_TX50','SW_TX',218.44,83.82,[72,26,0],fp=RFP,group='NORM')
comp(rf,'R603','0R NORMAL RX','RF_RX50','SW_RX',218.44,116.84,[71,29.5,0],fp=RFP,group='NORM')
rf.add('U601','BGS12SN6','BGS12SN6 / NORMAL','Node:BGS12SN6',269.24,101.6,{3:'SW_TX',1:'SW_RX',6:'RF_SW_FILTER',5:'SW_ANT',4:'RF_SW_SUPPLY',2:'GND'},pcb=[74.5,28,0],group='NORM')
comp(rf,'R604','100R','RF_SW','RF_SW_FILTER',236.22,157.48,[74,31,0],group='NORM')
comp(rf,'C611','1nF','RF_SW_FILTER','GND',269.24,172.72,[76,31,90],rot=0,fp=CFP,group='NORM')
comp(rf,'C612','1nF','RF_SW_SUPPLY','GND',307.34,76.2,[74.5,25.5,90],rot=0,fp=CFP,group='NORM')
comp(rf,'R623','1M','RF_SW_SUPPLY','GND',307.34,142.24,[77.5,31,90],rot=0,group='NORM')
box(rf,205,185,'RF switch sleep sequence','PA11 supplies BGS12SN6: 100uA typ / 180uA max active.\nBefore sleep set CTRL LOW, then PA11 LOW.\nWake: PA11 HIGH, wait >=20us, select path. CTRL 0=TX; 1=RX.')
comp(rf,'R605','0R NORMAL ANT','SW_ANT','ANT_TUNE_IN',335.28,101.6,[78,28,0],fp=RFP,group='NORM')
comp(rf,'R606','0R FEM TX','RF_TX50','FEM_TX',203.2,223.52,[70.5,23.8,90],fp=RFP,dnp=True,group='FEM')
comp(rf,'R607','0R FEM RX','RF_RX50','FEM_RX',241.3,223.52,[64,30,90],fp=RFP,dnp=True,group='FEM')
global_nets.update(['FEM_TX','FEM_RX','ANT_TUNE_IN'])
box(rf,134,253,'Tuning / variant isolation','All RF capacitors C0G; use high-Q RF inductors. Values start from ST MB1720.\nPopulate only one RF path. Inactive branch begins at its open selector pad.\nRemove antenna-side selector for conducted measurements; do not add a tee stub.')

f=Page('07-fem','Optional SKY66423-11 FEM, harmonic filter and antenna')
box(f,15,15,'SKY66423-11 / EK3 868 MHz network','FEM group DNP in standard build. Controls default LOW. No +22 dBm MCU output connection.\nStart conducted tests at -9 dBm drive; nominal FEM gain ~29 dB at 868 MHz.\nNever exceed +10 dBm input absolute maximum; verify conducted output before antenna use.')
f.add('U602','SKY66423-11','SKY66423-11 OPTIONAL','Node:SKY66423_MCM16',101.6,137.16,{1:'FEM_TX',2:'FEM_RX',3:None,4:'CSD_PACK',5:'CPS_PACK',6:'CTX_PACK',13:'FEM_PA',11:'FEM_TXIN',9:'FEM_ANT',7:'FEM_RXLOOP',8:'FEM_RXLOOP',15:'FEM_VCC0',16:'FEM_VCC1',10:'GND',12:'GND',17:'GND'},dnp=True,pcb=[72,18,0],group='FEM')
def fc(ref,val,a,b,x,y,pcb,**kw):return comp(f,ref,val,a,b,x,y,pcb,dnp=True,group='FEM',**kw)
fc('R608','0R','PACK_P','FEM_VCC0',40.64,71.12,[70.5,13,0],fp='Node:R0805')
fc('L605','0.6nH EK3 0201','FEM_VCC0','FEM_VCC1',81.28,71.12,[71.25,15.7,90],fp='Node:L0201',mpn='LQP03TN0N6B02D')
fc('L606','6.8nH','PACK_P','FEM_PA',142.24,73.66,[72.75,14.5,90],fp=LFP)
for i,(ref,val,net,xy) in enumerate([('C613','100nF','PACK_P',[65,13,90]),('C614','1uF','PACK_P',[66.5,13,90]),('C615','47uF 10V','PACK_P',[64,16,90]),('C616','4.7uF','PACK_P',[67,16,90]),('C617','33pF','PACK_P',[74,13,90]),('C618','1nF','PACK_P',[75.5,13,90]),('C619','10nF','FEM_VCC0',[69,14,90]),('C620','82pF','FEM_VCC0',[69,15.5,90])]):
    fc(ref,val,net,'GND',20.32+(i%4)*35.56,213.36+(i//4)*38.1,xy,rot=0,fp=C8 if ref=='C615' else CFP)
fc('L607','2.7nH','FEM_PA','OMN1',177.8,93.98,[75,16,0],fp=LFP)
fc('C621','10pF','OMN1','GND',193.04,116.84,[77,15,90],rot=0,fp=CFP)
fc('C622','DNP RF_TUNE','OMN1','GND',215.9,116.84,[78.5,15,90],rot=0,fp=CFP)
fc('L608','7.5nH','OMN1','FEM_TXIN',241.3,93.98,[77,17,90],fp=LFP)
fc('C623','2.4pF','FEM_TXIN','GND',269.24,116.84,[76,19,0],rot=0,fp=CFP)
fc('L609','5.6nH','FEM_ANT','FEM_FILTER',190.5,162.56,[76,22,0],fp=LFP)
fc('C624','1.5pF','FEM_ANT','FEM_FILTER',190.5,144.78,[76,23.2,0],fp=CFP)
fc('C625','2.2pF','FEM_FILTER','GND',223.52,187.96,[78,23.5,90],rot=0,fp=CFP)
fc('L610','5.6nH','FEM_FILTER','FEM_FINAL',256.54,162.56,[80,22,0],fp=LFP)
fc('C626','DNP RF_TUNE','FEM_FINAL','GND',279.4,187.96,[81.5,23.5,90],rot=0,fp=CFP)
fc('R609','0R FEM ANT','FEM_FINAL','ANT_TUNE_IN',307.34,162.56,[83,22,0],fp=RFP)
comp(f,'C627','68pF','ANT_TUNE_IN','ANT_PI',335.28,205.74,[85,22,0],fp=CFP)
comp(f,'C628','DNP RF_TUNE','ANT_PI','GND',307.34,243.84,[87,23.5,90],rot=0,fp=CFP,dnp=True,group='TUNE')
comp(f,'R610','0R RF_TUNE','ANT_PI','ANT',353.06,243.84,[89,22,0],fp=RFP)
f.add('J601','UFL','ANT / 50R','Node:UFL',383.54,208.28,{1:'ANT',2:'GND'},pcb=[94,22,180],mpn='U.FL-R-SMT-1(10)')
# Low-capacitance device selected instead of the multi-pF ESDZV5.
ic('RF_ESD',[(1,'RF',A)],[],bottom=[(2,'GND',A)],width=7.62)
f.add('D601','RF_ESD','AQ3118E-01ETG 18V 0.3pF','Node:ESD0402',383.54,251.46,{1:'ANT',2:'GND'},pcb=[92,23.2,90],mpn='AQ3118E-01ETG')
box(f,176,265,'RF ESD voltage margin','18V bidirectional TVS: +27dBm into 50R gives 7.08V peak.\nA 5V TVS would clip this waveform. Verify clamp performance by ESD testing.')

c=Page('08-fem-controls','Optional FEM control level translation and safe defaults')
box(c,20,18,'Pack-referenced control outputs / default shutdown','SKY66423 requires controls near GND or VCC0 for specified sleep current.\n3.3 V GPIO is not a full-height logic high when PACK+ is 4.05 V.\nTwo-transistor level translation gives non-inverting 0 / PACK+ outputs.\nDefault MCU reset state keeps all three FEM controls LOW; no floating mode pins.')
for i,(src,dst) in enumerate([('FEM_CSD','CSD_PACK'),('FEM_CTX','CTX_PACK'),('FEM_CPS','CPS_PACK')]):
    global_nets.add(dst);x=60.96+i*116.84;px=60+i*9
    c.add('Q'+str(601+i*2),'Q_NMOS_GSD','2N7002','Node:SOT23',x,101.6,{1:src,2:'GND',3:dst+'_INV'},dnp=True,pcb=[px,50,0],group='FEM')
    c.add('Q'+str(602+i*2),'Q_PMOS_GSD','BSS84','Node:SOT23',x+40.64,157.48,{1:dst+'_INV',2:'PACK_P',3:dst+'_DRV'},dnp=True,pcb=[px+4,50,0],group='FEM')
    for j,(val,a,b,xx,yy,xy) in enumerate([('1M',src,'GND',x-25.4,142.24,[px,53,90]),('1M','PACK_P',dst+'_INV',x+20.32,73.66,[px+2,47,90]),('1k',dst+'_DRV',dst,x+45.72,119.38,[px+4,47,90]),('1M',dst,'GND',x+45.72,203.2,[px+4,53,90])]):
        comp(c,'R'+str(611+i*4+j),val,a,b,xx,yy,xy,rot=0,dnp=True,group='FEM')
    tp(c,'TP'+str(601+i),dst,x+20.32,233.68,[px+6,55,0])
box(c,25,257,'Current audit','LOW outputs have no DC resistor current. A HIGH output draws ~8uA through\nthe gate pullup and output pulldown at PACK=4.05V. Allow >=1ms settling after\nmode changes. Qualify transistor leakage and FEM shutdown current on the bench.')
