Liftyee/multum-in-parvo/hardware/tools/temperature.py

# Executed in design.py namespace.
t=Page('05-temperature','Independent battery charge-temperature interlock')
box(t,20,18,'Solar-powered temperature window / firmware cannot override','Sensing and comparators draw from SOLAR_P, not the battery. In darkness the\ncharge-inhibit transistor defaults ON. Cold/absent NTC and shorted NTC inhibit.\nNominal comparator crossover: +5 C / +40 C, leaving margin inside 0...45 C.')
comp(t,'R401','100k 0.1%','SOLAR_VALID','NTC_SENSE',45.72,76.2,[10,55,90],rot=0)
t.add('J401','Conn_01x02','100k NTC AT CELL','Node:Header1x2',45.72,124.46,{1:'NTC_SENSE',2:'GND'},pcb=[10,51,0],mpn='External NTC NCP18WF104F12RB mounted on cell tab')
comp(t,'C401','1nF','NTC_SENSE','GND',76.2,121.92,[12,54,90],rot=0)
comp(t,'R402','357k 0.1%','SOLAR_VALID','COLD_REF',116.84,73.66,[14,56,90],rot=0)
comp(t,'R403','1M 0.1%','COLD_REF','GND',116.84,111.76,[14,58,90],rot=0)
comp(t,'R404','1.98M 0.1%','SOLAR_VALID','HOT_REF',157.48,73.66,[16,56,90],rot=0)
comp(t,'R405','1M 0.1%','HOT_REF','GND',157.48,111.76,[16,58,90],rot=0)
ic('TLV7031S',[(1,'IN+',I),(3,'IN-',I)],[(4,'OUT',O)],top=[(5,'VCC',P)],bottom=[(2,'GND',P)],width=17.78)
t.add('U401','TLV7031S','TLV7031SDCKR COLD','Node:SC70_5',218.44,76.2,{1:'COLD_REF',3:'NTC_SENSE',4:'COLD_OK',5:'SOLAR_P',2:'GND'},pcb=[14,61,0])
t.add('U402','TLV7031S','TLV7031SDCKR HOT','Node:SC70_5',218.44,124.46,{1:'NTC_SENSE',3:'HOT_REF',4:'HOT_OK',5:'SOLAR_P',2:'GND'},pcb=[18,61,0])
ic('TPS3839',[],[(2,'RESET_N',O)],top=[(3,'VDD',P)],bottom=[(1,'GND',P)],width=17.78)
t.add('U403','TPS3839','TPS3839L30DBZR','Node:SOT23',330.2,76.2,{1:'GND',2:'SOLAR_VALID',3:'SOLAR_P'},pcb=[21,56,0])
comp(t,'C404','100nF','SOLAR_P','GND',375.92,81.28,[24,56,0],rot=0)
t.add('Q405','Q_NMOS_GSD','2N7002 / UV INTERLOCK','Node:SOT23',172.72,210.82,{1:'SOLAR_VALID',2:'GND',3:'TEMP_UV'},pcb=[25,59,0])
comp(t,'R412','1M','SOLAR_VALID','GND',375.92,124.46,[24,54,90],rot=0)
for i in range(2):comp(t,'C'+str(402+i),'100nF','SOLAR_P','GND',269.24,76.2+i*48.26,[14+i*4,63,0],rot=0)
# Gate voltage AND, no wired-together push-pull outputs.
t.add('Q401','Q_NMOS_GSD','2N7002','Node:SOT23',76.2,190.5,{1:'COLD_OK',2:'TEMP_AND',3:'TEMP_PG'},pcb=[23,62,0])
t.add('Q402','Q_NMOS_GSD','2N7002','Node:SOT23',116.84,190.5,{1:'HOT_OK',2:'TEMP_UV',3:'TEMP_AND'},pcb=[26,62,0])
comp(t,'R406','1M','COLD_OK','GND',40.64,203.2,[23,65,90],rot=0)
comp(t,'R407','1M','HOT_OK','GND',147.32,203.2,[26,65,90],rot=0)
t.add('Q403','Q_NMOS_GSD','BSS138 / DEFAULT INHIBIT','Node:SOT23',218.44,187.96,{1:'TEMP_PG',2:'GND',3:'TEMP_PASS'},pcb=[29,61,0])
comp(t,'R408','100k','VINT','TEMP_PG',177.8,172.72,[29,58.5,90],rot=0)
comp(t,'R409','0R','TEMP_PASS','CHG_ENABLE',269.24,180.34,[31.5,61,0])
comp(t,'R410','DNP TEST ONLY','CHG_ENABLE','GND',304.8,203.2,[33,63,90],rot=0,dnp=True,group='TEMP_TEST_DNP')
t.add('Q404','Q_NMOS_GSD','2N7002 / INHIBIT','Node:SOT23',345.44,190.5,{1:'CHG_INHIBIT',2:'GND',3:'CHG_ENABLE'},pcb=[35.5,61,0])
comp(t,'R411','1M','CHG_INHIBIT','GND',375.92,205.74,[35.5,64,90],rot=0)
box(t,25,242,'Calculations and assembly','100k NTC, B25/50=4200K; 1% R25 and B tolerance.\nReference ratios: 0.7369 cold / 0.33557 hot; resistors 0.1%.\nDividers fed by SOLAR_VALID, off below UV threshold.\nAt 4V: sensor 20uA at 25C, references 4.29uA; no battery divider current.\nTLV7031S improves offset to +/-8mV; 7mV typical hysteresis.\nTPS3839L30 inhibits below 2.63V solar; release delayed 200ms typical.\nSee temperature-analysis.md for tolerances and startup qualification.')
